Hoehlenbaer/SLARC/README.md

# SLARC – Six‑Legged Autonomous Robot Crab

> *'Crab' is a misnomer — six legs and no claws hardly make it one, but SLARC will happily act crab‑enough whenever something needs grabbing.*

SLARC is a personal hobby project with an ambitious goal: build a **state-of-the-art hexapod robot that is fully AI-controlled** — from low-level motion to high-level mission planning — using entirely off-the-shelf hardware, a fully 3D-printable chassis, and custom-trained neural networks.

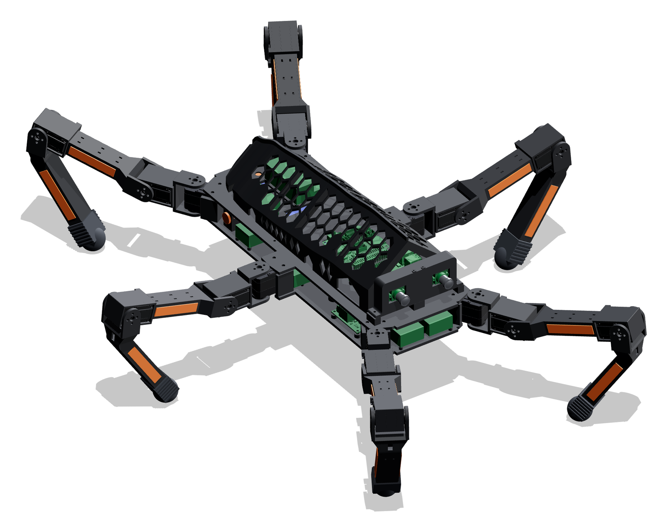
[picture p1: Documentation/Images/slarc_iso.png]
SLARC – full CAD model, isometric view


*Full CAD model, rendered straight from the parametric FreeCAD macros (Nov 2026).*

---

## What makes SLARC interesting

Most hobbyist hexapods are scripted or rely on simple remote control. SLARC aims to close the gap between hobby robotics and current research:

- **Fused multi-task perception** – a single shared neural network simultaneously performs stereo depth estimation, surface normal prediction, semantic segmentation, and object detection, all optimized for the Hailo-8 NPU
- **GPU-accelerated stereo rectification** – lens distortion correction and image scaling for both cameras runs entirely on the Raspberry Pi 5's VideoCore VII GPU via OpenGL ES shaders, freeing the CPU completely for other tasks
- **Needs-driven behaviour instead of voice remote control** – SLARC acts on its own needs (energy, curiosity, usefulness, company, safety); a deterministic arbiter picks the behaviour, and a small local vision-language model (Qwen3.5-4B on the Pi 5's CPU) answers only the semantic questions: what did the human mean, what is that object, where might the keys be
- **Portable reactive locomotion** – stair climbing and terrain adaptation are developed in a PyBullet simulation under one hard rule: the controllers may only use what the real robot can measure (joint angles, foot µ-switches, IMU), so the same logic can move 1:1 onto the ESP32
- **Fully self-printable, fully parametric** – every structural part of the chassis and legs is generated by FreeCAD macros and printed in PETG, PLA and TPU; no proprietary frames or machined parts

---

## Hardware

| Component | Details |
|---|---|
| **Main Brain** | Raspberry Pi 5, 8 GB RAM |
| **AI Accelerator** | Hailo-8 NPU (26 TOPS) via AI HAT+ |
| **Secondary Brain** | Waveshare General Driver for Robots (ESP32) |
| **Legs** | 6 × 3-DOF, 18 × Waveshare ST3215 serial bus servos (2.94 Nm stall), each servo supported on both sides |
| **Leg geometry** | Coxa 60 mm · Femur 150 mm · Tibia 175 mm (knee axis to foot tip, bent 38.6° downwards, 140 mm foot segment) — same values in CAD and simulation |
| **Feet** | TPU 95A foot caps with integrated µ-switch for ground contact detection |
| **Stereo Cameras** | 2 × IMX296 global shutter (1440×1080), M12 2.8 mm lens, 65 mm baseline, hardware-triggered via PWM |
| **IMU** | QMI8658C + AK09918C on the driver board (balance control on the ESP32); ICM-20948 on the stereo mount for visual-inertial SLAM on the Pi (I²C, data-ready interrupt, time-stamped against the camera trigger) |
| **Power** | Zeee 3S LiPo 9000 mAh, 3S BMS, relay-switched Pi supply and one relay per leg (power sequencing by the ESP32); wiring plan and perfboard layouts in `Documentation/Wiring` |
| **Chassis** | Two 4 mm PETG baseplates with the coxa servos sandwiched between them, generated by FreeCAD macros |
| **Size / mass** | ~85 cm leg span, ~1 m long; 3.79 kg all-up according to the CAD model (battery, electronics and cables estimated, still to be weighed) |

The Raspberry Pi handles all AI inference and high-level planning. The ESP32 handles real-time servo control, sensor reading and safety, communicating with the Pi over UART (see [Low-Level Control](#low-level-control--esp32)).

---

## AI Architecture

### Perception – FusedHexapodModel V5.0

The core perception system is a **single multi-task neural network** with four output heads, designed to run entirely on the Hailo-8 NPU. All heads share a common MobileNetV2-1.4 backbone with asymmetric channel alignment — the feature extraction cost is paid once per frame.

#### Architecture Evolution

The model has gone through several iterations, each driven by deployment constraints on the Hailo-8 NPU:

| Change | V3.1 | V4.0 | V5.0 | Reason |
|---|---|---|---|---|
| Backbone | MobileNetV3-Large | MobileNetV2-1.4 | MobileNetV2-1.4 | SE blocks caused 6× slowdown on Hailo |
| Channel Alignment | None | None | **Stereo-focused (64/128/128/256)** | Wider stereo features via 1×1 projection, preserving ImageNet weights |
| Stereo Matching | CostVolume + GroupedConv | CostVolume + GroupedConv | **Flat CostVolume + MLP reduction** | Cross-disparity learning, no per-bin isolation |
| CostVolume channels | 32 | 16 | 16 | Halved without quality loss |
| Stereo output | Full res (480×640) | s4 (120×160) | s4 (120×160) | s1 refinement added artifacts |
| Attention | CBAM after FPN | Removed | Removed | AvgPool + FC chains are NPU-hostile |
| Activations | ReLU + HardSwish | ReLU6 | ReLU6 | Pure INT8 quantization |
| Seg classes | 6 (with NAV_ANCHOR) | 6 (with NAV_ANCHOR) | **6 (FLOOR/TERRAIN split)** | Better outdoor navigation |
| Detection classes | 40 | 40 | **41 (+ UNKNOWN)** | Catch-all for the other 40 COCO classes |
| Confidence Gate | None | Peak confidence | Peak confidence | Suppresses false stereo matches |
| NPU deployment | Not achieved | 3-HEF, 18 FPS | **3-HEF (1+3+1 ctx), 16.5 FPS** | Wider features trade speed for quality |

#### Architecture Overview

```
Stereo Camera Pair (640×480, grayscale)
    │
    ▼
┌──────────────────────────────────────────────────────────────┐
│  MobileNetV2-1.4 Backbone (1-channel input, luminance merge) │
│  out_indices: s4 (32ch) · s8 (48ch) · s16 (136ch) · s32 (448ch)│
└──┬──────────┬──────────┬──────────┬──────────────────────────┘
   │          │          │          │
   ▼          ▼          ▼          ▼
┌──────────────────────────────────────────────────────────────┐
│  Channel Aligner (stereo-focused)                            │
│  1×1 Conv projections: 32→64 · 48→128 · 136→128 · 448→256   │
│  Wider s4/s8 for stereo, slimmer s32 saves compute           │
└──┬──────────┬──────────┬──────────┬──────────────────────────┘
   │s4(64)    │s8(128)   │s16(128)  │s32(256)
   │          │          │          ▼
   │          │          │    ┌───────────┐
   │          │          │    │   SPPF    │ Spatial Pyramid Pooling
   │          │          │    │  (k=5)    │ Expands receptive field
   │          │          │    └─────┬─────┘
   │          │          │          │
   │          │          ▼          ▼
   │          │    ┌─────────────────────┐
   │          │    │   Light FPN Neck    │ Bi-directional feature fusion
   │          │    │  (64ch, RepConv)    │ 4× RepConv (folded at deploy)
   │          │    └──┬───────┬───────┬──┘
   │          │       │s8     │s16    │s32
   │          │       ▼       ▼       ▼
   │          │    ┌────────────────────────┐
   │          │    │    YOLO Detection      │ 41 classes (40 known + UNKNOWN)
   │          │    │  (3 Decoupled Heads)   │ 3 scales: s8 / s16 / s32
   │          │    │  CoordConv + RepConv   │
   │          │    └────────────────────────┘
   │          │
   ▼          ▼
┌──────────────────┐
│  Geometry Stem   │ RepConv(64→32) + RepConv(32→32)
│  (s4, 32ch out)  │ High-res edge features
└──┬───────────────┘
   │ geo_features
   │
   ├───────────────────────────────────┐
   │                                   │
   ▼                                   ▼
┌──────────────────────┐    ┌─────────────────────────────────┐
│   NormalsHead        │    │   Correlation Stereo Head (V5)  │
│                      │    │                                 │
│  Fusion: s4 + s8     │    │  Flat CostVolume (s8)           │
│   + geo (CoordConv)  │    │   · Shift+Concat all disparities│
│   96 → 64 → 32 → 3  │    │   · 16ch × 24 bins = 384ch     │
│                      │    │                                 │
│  L2 normalize        │    │  MLP Reduction (384 → 96 → 24) │
│  (deploy-safe sqrt)  │    │   · Cross-disparity learning    │
│                      │    │   · Learns correlations across  │
│  Output:             │    │     all disparity bins jointly  │
│   normals_s4         │    │                                 │
│   [1, 3, 120, 160]   │    │  Confidence Gate (eval only)    │
│                      │    │                                 │
└──────┬───────────────┘    │  Refine s4 (backbone guidance)  │
       │ normals_s4         │                                 │
       ▼                    │  Output:                        │
┌────────────────────────┐  │   disp_s4  [1, 1, 120, 160]    │
│  LRASPP Seg Head       │  │   disp_s8  [1, 1,  60,  80]    │
│  low (s4 + normals)    │  └─────────────────────────────────┘
│  + high (s16, pooled   │
│    via LearnablePool)  │
│  + mid (dilated + norm)│
│                        │
│  Output:               │
│   seg [1, 6, 120, 160] │
│                        │
│  6 classes:            │
│  FLOOR · STEP ·        │
│  WALL · OBSTACLE ·     │
│  VOID · TERRAIN        │
└────────────────────────┘
```

#### Model Summary

| Property | Value |
|---|---|
| Total parameters | 5.90 M |
| Backbone (MobileNetV2-1.4) | 3.45 M |
| Channel Aligner | 0.14 M |
| YOLO Head | 1.46 M |
| Seg Head | 0.21 M |
| Normals Head | 0.16 M |
| Input | 1 × 480 × 640 grayscale (×2 for stereo) |
| Outputs | 7 tensors (disp_s4, seg, disp_s8, normals_s4, yolo_s8/s16/s32) |

#### Building Blocks

| Block | Purpose | NPU Cost |
|---|---|---|
| **MobileNetV2-1.4** | Shared backbone — wider channels (32/48/136/448) than MNV2-1.0, no SE blocks, pure ReLU6 | Very low — ideal for INT8 NPU |
| **Channel Aligner** | 1×1 Conv projections to Hailo-optimal widths (64/128/128/256); preserves ImageNet weights, wider s4/s8 for stereo, slimmer s32 saves compute | Negligible — four 1×1 convs |
| **SPPF** | Expands receptive field at s32 via cascaded 5×5 max-pooling | Minimal — pooling + 1×1 convs |
| **CoordConv** | Appends normalized X/Y coordinate grids; spatial awareness for stereo matching and normals | Negligible — 2 extra input channels |
| **RepConv** | Three parallel paths during training (3×3 + 1×1 + identity); folds into single 3×3 conv at deploy | **Zero overhead at inference** |
| **GeometryStem** | High-frequency edge features from s4 via 2× RepConv; shared by Stereo and Normals | Low — 2 convs at stride 4 |
| **Flat CostVolume** | Shift + Concat all disparity bins into a single flat tensor (384ch); no per-bin GroupedConv | More regular memory access pattern |
| **MLP Reduction** | Two-stage 1×1 Conv (384→96→24) with ReLU6; enables cross-disparity learning — each output bin sees all 24 shifts simultaneously | Low — two small 1×1 convs |
| **DWSepConv** | Depthwise-separable convolution; ~8–9× fewer FLOPs than standard conv | Very efficient |
| **LearnablePool** | Replaces AvgPool2d with depthwise conv initialized as averaging; avoids Hailo quantization shift errors | Identical compute, better quantization |
| **Confidence Gate** | At inference: suppresses stereo matches where peak confidence is too low (repetitive textures, sky) | Negligible — max + clamp + mul |
| **SegFormer teacher fusion** | SegFormer-b2 on GPU during training only; enriches geometry-derived seg labels with semantics | **Zero at inference** |
| **EMA loss balancing** | Per-task loss normalization with priority weights and NaN guards | **Zero at inference** |

#### Head Details

**Stereo Depth** — Flat CostVolume with cross-disparity learning at stride 4 resolution:
- Flat CostVolume at stride 8: shift + concatenate left/right features for all 24 disparity bins into a single 384-channel tensor
- MLP Reduction (384→96→24): two-stage 1×1 Conv with ReLU6 — enables each output bin to see all 24 shifts simultaneously, learning cross-disparity correlations instead of isolated per-bin matching
- Post-correlation refinement: 2× Conv2d 3×3 with spatial context smoothing
- Confidence Gate: peak confidence check — suppresses false matches on repetitive textures and sky regions
- Refine s4: Upscale ×2, backbone + geo + normals guidance via CoordConv
- Output: dense disparity map at s4 (120×160); for display, multiply by 4 and upscale with OpenCV

**Surface Normals** — Multi-scale fusion at stride 4:
- s4 backbone (64ch) + adapted s8 (32ch) + GeometryStem (32ch) = 128ch fused via CoordConv
- L2 normalization (deploy-safe: max-scaling to prevent INT8 overflow, then sqrt + clamp)
- Output: per-pixel unit normal vectors at s4 resolution (120×160)

**Segmentation** — LRASPP with normals injection:
- Low path: s4 features + predicted normals
- High path: s16 features via LearnablePool + 1×1 projection
- Mid path: dilated conv on s16 + normals
- Labels fused from depth-derived geometry (floor angle, surface roughness) + SegFormer-b2 teacher predictions (semantic classes)
- 6 classes: FLOOR (smooth hard surfaces), STEP (stairs), WALL (vertical), OBSTACLE (impassable), VOID (sky/far), TERRAIN (walkable but uneven: grass, sand, dirt)

**Object Detection** — YOLO-style 3-scale:
- 3-scale decoupled heads (s8, s16, s32) with CoordConv + RepConv
- 41 classes: 40 robot-relevant COCO classes (10 of them outdoor, e.g. bench, hydrant, traffic light as outdoor landmarks) + UNKNOWN
- UNKNOWN is trained on the remaining 40 COCO categories. Objects that COCO never labels (socks, cables, keys) were background during training, so true class-agnostic objectness should not be expected — this is still to be measured (LVIS annotations on COCO val)
- Not yet covered: doors, windows and drink cans. They are needed for navigation by named landmarks and for the can-fetching milestone and will be added by refining the detection head
- GIoU box regression, focal loss for classification

#### Training

| Aspect | Detail |
|---|---|
| Backbone init | MobileNetV2-1.4 pretrained on ImageNet, first conv patched 3→1 channel via luminance weight merging |
| Stereo + Seg + Normals data | TartanAir synthetic dataset (photorealistic indoor/outdoor stereo pairs with dense depth GT) |
| Detection data | COCO train2017 with offline YOLOv5 pseudo-label completion |
| Seg label fusion | Geometry (depth + normals thresholds) merged with SegFormer-b2 teacher on color images |
| Loss balancing | EMA-normalized multi-task loss with per-task priority weights and clamped effective weights [0.5, 10.0] |
| Optimizer | AdamW, per-module LR multipliers, Flat-Cosine LR schedule (warmup → hold → cosine decay) |
| Precision | Mixed FP16 via GradScaler, FP16-safe normalize (eps=1e-4), L1-norm edge maps (no sqrt) |
| Stability | NaN guards on EMA + total loss, per-module + global gradient clipping, forced `.item()` on all log values to prevent memory leaks in long training runs |
| Hardware | NVIDIA RTX 3080 Ti (12 GB), AMD Ryzen 9 5950X, WSL2 |

#### Eval Results

| Task | Metric | V3.1 | V4.0 | V5.0 | V4→V5 |
|---|---|---|---|---|---|
| **Stereo** | EPE | 2.42 px | 1.00 px | **0.97 px** | −3% |
| **Stereo** | Bad3 | — | 17.1% | **14.1%** | −18% |
| **Detection** | mAP@50 | 0.118 | 0.260 | **0.253** | −3% (41 cls) |
| **Detection** | Top10 Conf | — | 0.593 | **0.689** | +16% |
| **Segmentation** | mIoU | 23.8% | 22.7% | **22.6%** | ≈ (new classes) |
| **Normals** | Cosine Sim | 0.567 | 0.639 | **0.638** | ≈ |

**V5.0 highlights:**
- Stereo Bad3 drops from 17.1% to 14.1% — the MLP reduction and cross-disparity learning significantly improve matching quality
- YOLO confidence jumps 16%, mainly thanks to the wider backbone features
- YOLO mAP@50 is slightly lower (0.253 vs 0.260) because V5.0 has 41 classes instead of 40 — the additional UNKNOWN class makes classification marginally harder
- Seg mIoU is comparable despite a complete class redefinition (WALKABLE→FLOOR, NAV_ANCHOR removed, TERRAIN added)
- VOID detection works for the first time (53.7% IoU vs 0.0% in V4.0)

*All metrics evaluated on TartanAir eval (amusement, oldtown) and COCO val2017. Stereo EPE measured at s4 resolution (120×160).*

### Hailo-8 NPU Deployment

The model is split into **3 HEF files** for deployment on the Hailo-8 NPU. Alternative splits were evaluated (2-HEF combined, 3-HEF with Normals+Detection merged) but failed due to INT8 concat zero-point mismatches or excessive inter-context bandwidth. The 3-HEF split remains the most reliable and performant approach.

#### 3-HEF Pipeline

```
img_left ──→ [HEF A: Backbone] ──→ f_s4, f_s8, f_s16, f_s32
img_right ─→ [HEF A: Backbone] ──→ f_s4_r, f_s8_r
                                         │
              features_l + features_r ───→ [HEF B: Geometry] ──→ disp_s4, normals_s4, disp_s8
                                         │
              features_l + normals_s4 ──→ [HEF C: Detection] ──→ seg, yolo_s8, yolo_s16, yolo_s32
```

#### Compilation Results

| HEF | Contexts | Weights | GOPS | Inter-Context BW | SNR (dB) |
|---|---|---|---|---|---|
| **A: Backbone** | 1 | 3.0 M | 2.57 | 0 MB | 14–18 |
| **B: Geometry** | 3 | 0.3 M | ~12 | 73.9 MB | 28–39 |
| **C: Detection** | 1 | 3.9 M | ~8 | 0 MB | 40–44 |
| **Total** | **5** | **7.2 M** | **~23** | — | — |

#### Cluster Utilization

**Backbone** (single context):

| Cluster | Control | Compute | Memory |
|---|---|---|---|
| Total | 74.2% | 47.7% | 34.4% |

**Geometry** (3 contexts, highest utilization context shown):

| Cluster | Control | Compute | Memory |
|---|---|---|---|
| Total (ctx 1) | 71.9% | 28.1% | 26.4% |

**Detection** (earlier 2-context build, context 0 shown; the final build fits into a single context):

| Cluster | Control | Compute | Memory |
|---|---|---|---|
| Total (ctx 0) | 60.2% | 33.6% | 43.4% |

#### Quantization Quality (SNR)

| Output | HEF | SNR (dB) | Quality |
|---|---|---|---|
| f_s4 (backbone) | A | 16.3 | Acceptable (intermediate feature) |
| f_s8 (backbone) | A | 16.0 | Acceptable (intermediate feature) |
| f_s16 (backbone) | A | 14.2 | Acceptable (intermediate feature) |
| f_s32 (backbone) | A | 15.2 | Acceptable (intermediate feature) |
| disp_s4 (stereo) | B | **39.1** | Excellent |
| normals_s4 | B | **33.1** | Very good |
| disp_s8 (coarse) | B | **27.8** | Good |
| seg | C | **44.5** | Excellent |
| yolo_s8 | C | **41.8** | Excellent |
| yolo_s16 | C | **43.6** | Excellent |
| yolo_s32 | C | **39.7** | Excellent |

*Backbone SNR is lower because intermediate features have wider value distributions. The downstream heads compensate effectively — all final output SNRs exceed 27 dB.*

#### Runtime Performance (Raspberry Pi 5, PCIe Gen 3)

| Step | V4.0 Latency | V5.0 Latency (median) |
|---|---|---|
| Backbone (left) | 13.5 ms | 14.1 ms |
| Backbone (right) | 10.0 ms | 10.0 ms |
| Geometry (stereo + normals) | 21.8 ms | 25.9 ms |
| Detection (seg + YOLO) | 10.6 ms | 10.4 ms |
| **Pipeline total** | **56 ms → 17.9 FPS** | **60.5 ms → 16.5 FPS** |

*V5.0 final HEFs (1+3+1 contexts), pure inference time from raw image to head outputs, no I/O or post-processing; min/max 59.9 / 62.5 ms. V5.0 uses stereo-focused channel alignment (64/128/128/256) which produces wider feature tensors, slightly increasing transfer overhead. Measured on Raspberry Pi 5 with PCIe Gen 3 (`dtparam=pciex1_gen=3`).*

#### Quantization check FP32 → INT8 (TartanAir oldtown sample)

| | EPE | Max disparity |
|---|---|---|
| FP32 (PyTorch) | 1.134 px | 20.12 px |
| INT8 (Hailo-8) | 1.121 px | 20.47 px |

Mean FP32 → INT8 difference: 0.20 px — INT8 quantization costs no measurable stereo accuracy. Normals, segmentation and detection also match the FP32 outputs visually.

**Known limitation – sky:** the largest remaining stereo error is in sky regions (the network outputs disparity where the ground truth is ~0). This is a training-data artifact, not an architecture problem; fixing it needs fine-tuning on real images from SLARC's own cameras.

#### Lessons Learned: Hailo-8 Optimization

The path from a trained PyTorch model to a working HEF on the Hailo-8 was the most challenging part of this project. Key takeaways:

1. **Squeeze-and-Excite blocks are NPU killers.** MobileNetV3-Large with SE blocks: 35 ms per backbone pass. Without SE: 5.6 ms — a 6.3× speedup. The avgpool→fc→fc→sigmoid→multiply chain creates excessive context switches.

2. **HardSwish costs more than expected.** Even without SE, MobileNetV3 (16 FPS) was slower than MobileNetV2 (18.5 FPS) because HardSwish compiles as a multi-op sequence requiring 16-bit precision.

3. **AvgPool2d causes quantization failures.** Global average pooling with large kernel sizes (30×40, 60×80) triggers shift-delta errors in the Hailo quantizer. Solution: replace with depthwise conv initialized as averaging (`LearnablePool`), or use `pre_quantization_optimization(global_avgpool_reduction)`.

4. **The DFC renames all ONNX inputs.** Start nodes become `input_layer1`, `input_layer2`, etc., regardless of the ONNX names. Input mapping must use positional order, not name matching.

5. **Model script normalization requires assignment syntax.** `norm_0 = normalization([mean], [std], input_layer1)` — bare `normalization()` calls fail silently.

6. **Single-HEF is not always faster.** A single HEF with many contexts can have higher inter-context bandwidth than multiple smaller HEFs. Always benchmark both approaches.

7. **Calibration data must be unnormalized.** When using in-network normalization via model script, calibration data should be raw \[0, 255\] values, not pre-normalized.

8. **RepConv deploy flag must be threaded through all constructors.** If any `RepConv` module doesn't receive `deploy=True`, the folded weights won't load. Use a post-creation fix: iterate all modules and set `deploy=True` + create `rbr_reparam` manually.

9. **Classification backbones waste channels for dense prediction.** MobileNetV2-1.4 puts 448 channels at s32 (for ImageNet classification) but only 48 at s8 (where stereo matching happens). A simple 1×1 projection ("Channel Aligner") redistributes capacity: wider s4/s8 for stereo, slimmer s32 for detection. ImageNet weights are preserved — only the projection layers are new.

10. **Grouped Convolutions in Cost Volumes limit stereo quality.** V4.0's GroupedConv processed each disparity bin in isolation — bin 5 had no information about bins 4 or 6. Replacing this with a flat Concat + MLP reduction (384→96→24) lets each output bin see all 24 shifts simultaneously, enabling cross-disparity learning. This changed the learning dynamics fundamentally: the model learns global depth structure instead of local bin-by-bin matching.

11. **Concat zero-point mismatches block HEF merging.** Combining Normals (range [-1, 1]) and Backbone features (range [-3, 3]) in a single HEF causes INT8 quantization conflicts at Concat nodes. Keeping them in separate HEFs lets the compiler resolve zero-points at HEF boundaries. A 2-HEF approach (Backbone + Combined) failed for this reason; 3-HEF remains the most reliable split.

### High-Level Brain – needs-driven behaviour (`src_dev/ai/brain/`, V0.9)

SLARC should not be a voice-controlled remote. A command like *"walk north until the battery is empty"* is just remote control with extra steps. Instead, SLARC acts on its own needs — **energy, curiosity, usefulness, company** — plus a sense of **safety**. People can still ask for things; the brain files a request under these needs. The goal is behaviour that feels alive rather than scripted.

The design follows behaviour-based robotics (three-layer architecture):

| Layer | Where | Rate | Job |
|---|---|---|---|
| Reflexes & expression | ESP32 | 100 Hz | Balance, foot contacts, detecting being lifted or tapped, idle motion, "thinking" pose |
| Behaviour | Pi, behaviour trees (`py_trees`) | 10 Hz | Runs one behaviour from a fixed catalogue: explore, look around, inspect, search, report, greet, follow, return home, rest, retreat … |
| Needs & memory | Pi | 1 Hz | Updates the needs, applies the safety veto, picks the behaviour, keeps memory of objects and places and a diary |
| LLM | Pi, llama.cpp | Event-driven | Semantic questions only |

**Key decisions**

- **Action selection lives in code, not in the LLM.** In the first test, Qwen3-4B as decision maker scored 36/45 against 42/45 for the plain code arbiter, and it chose a human request over returning home in all three "battery low, far from home" cases. Safety limits and the energy-based return home are therefore hard rules with a veto.
- **The LLM does what only it can:** interpret chat messages, judge unknown objects, guess where to search for something, narrate the diary, and break near-ties between equally good options. Outputs are forced into a fixed format with llama.cpp GBNF grammars.
- **"What is that?"** Unknown detections are never touched. SLARC crops the box with a red frame, asks the vision-language model from two viewpoints and only accepts a name if both answers agree; otherwise it asks a human in the chat. On PC tests about 3 of 4 household objects were named correctly.
- **Blackboard as the only interface** (`blackboard.py`, BB 0.2): pose, 10 cm occupancy grid, detections in world coordinates, object tracks (present / missing / moved), persons, frontiers and navigation state. Path planning with A* (`nav/`, numpy only). The brain stays unchanged when simulation is replaced by real perception and SLAM.

**LLM on the Raspberry Pi 5 (8 GB, CPU only)**

| Setting | Value |
|---|---|
| Model | Qwen3.5-4B Q4_K_M + vision projector (mmproj) Q8_0 |
| Runtime | One `llama-server`, built without BLAS (no measurable gain), 4 slots — one per task, so switching tasks costs nothing |
| Server options | `-np 4 -c 8192 -fa on -ctk q8_0 -ctv q8_0 -ub 256 --cache-ram 0` |
| Memory | ~4.2 GB |
| Pause per call (measured) | Chat ~9–10 s · search places ~12–15 s · object judgement ~14 s · goal choice ~19 s · image question at 320 px ~10 s |

While the LLM computes, SLARC enters a **thinking state**: perception and motion on the Pi pause so the model gets all cores, while the ESP32 keeps the reflexes running and shows a thinking pose. As far as I know there is still no practical way to run an SLM of this size on the Hailo-8 — happy to hear otherwise.

**Testing without hardware:** unit tests (`brain/tests`), decision and open-ended test suites with held-out sentences, a model comparison tool, a text-level day simulation (`brain/sim`) and a 2D simulation (`brain/sim2d`) with a simulated camera, map building, object tracking and an HTML replay viewer. In the first 2D run SLARC mapped all seven rooms of a simulated flat in under an hour, tracked 20 objects and was back home before the battery ran low.

**Interaction** works without audio for now: web chat, phone notifications, body language, LEDs and tapping the shell as praise. Audio will come via USB, because I²S on the Pi collides with the camera trigger on GPIO18.

Full concept, measurements and decisions: `Documentation/Brain_Konzept.md` (German).

*The earlier prototypes (`exploration_manager_V4.py`, `bt_executor.py`, `mission_replanner_V1.py`) turned a command into a JSON behaviour tree. They are superseded by the brain but remain in `src_dev/ai/` as reference.*

---

## Camera Pipeline & GPU-Accelerated Rectification

> **This may be of independent interest as a standalone technique.**

Stereo vision requires both camera images to be rectified before depth estimation — distortion must be removed and the images aligned so that corresponding points sit on the same horizontal scanline. On a Raspberry Pi, doing this in software (OpenCV `remap`) consumes a significant portion of the CPU budget at high resolution.

SLARC offloads the entire rectification and rescaling pipeline to the **VideoCore VII GPU** using OpenGL ES 3.0 fragment shaders via `moderngl`. The approach:

```
picamera2 (1440×1080, YUV420)
    │  Y-plane only → Shared Memory
    ▼
OpenGL ES Fragment Shader (VideoCore VII)
    │  Inverse camera model per output pixel:
    │   1. Map output pixel → ray (K_new⁻¹)
    │   2. Rotate ray into camera frame (R⁻¹)
    │   3. Apply radial + tangential distortion (k1, k2, p1, p2)
    │   4. Project back to source pixel (K_old)
    │   5. Bilinear texture sample
    ▼
Rectified + scaled output (640×480, RGB)
    │  → Shared Memory → Hailo-8 inference
    ▼
POSIX Semaphore signals AI process
```

**Why this matters on a Raspberry Pi:**
- The VideoCore VII has its own memory bus and shader cores that are otherwise completely idle during inference workloads
- CPU load for rectification at 50 fps drops from ~40% (OpenCV) to ~0% (GPU shader)
- Both cameras are processed sequentially in a single OpenGL framebuffer pass
- The pipeline handles arbitrary stereo calibration matrices loaded from a JSON file, or falls back to identity matrices for testing

The implementation lives in `vision/vision_processor.py` and `vision/vision_capture.py`. Synchronization between the two camera capture processes and the GPU worker uses a `multiprocessing.Barrier` and POSIX semaphores, keeping latency deterministic.

If you are working on stereo vision on Raspberry Pi and looking for a way to free up CPU time, this approach should transfer directly to any project using `picamera2` + `moderngl`.

Both IMX296 sensors are triggered externally by a PWM signal so that left and right exposures start at the same instant (setup notes: `Documentation/Setup HW trigger.txt`). With fx ≈ 357 px at 640×480 and 192 px maximum disparity, the 65 mm baseline gives a minimum measurable distance of ≈ 1.86 × baseline ≈ 12 cm — close enough to see the robot's own feet.

---

## Locomotion & Simulation

Gait and climbing control are developed in **PyBullet** (`utilities/Motion_development/slarc_sim/`) before they touch real servos. The simulation model uses the planned leg geometry, servo limits (2.94 Nm stall, soft position gain to mimic gear backlash and the TPU foot) and realistic friction/contact parameters.

**Design rule:** every controller may only use signals the real robot has — joint angles, foot µ-switch contacts and IMU roll/pitch. No world coordinates from the physics engine. That keeps the control logic portable to the ESP32.

### Controller layers

| Layer | Input | Function |
|---|---|---|
| **R1 – foot seek** | µ-switch per leg | Lowers a leg until it touches ground; no contact → keep searching |
| **R2 – balancer** | IMU pitch / roll | Holds the body attitude; while climbing the setpoint follows the slope of the support plane instead of 0° |
| **R3 – body height** | Median of stance-leg forward kinematics | Keeps body height robust against single legs standing on bumps (median, not mean) |

In an isolated hold test the three regulators kept all six feet in contact through all disturbance scenarios. During walking they run per gait.

### Gaits

| Gait | Legs in stance | Use |
|---|---|---|
| **Tripod** | 3 | Fast walking on flat ground |
| **Ripple** | 4 | Uneven terrain, more stability margin |
| **Placemove** | 5 | One leg at a time, probing foothold – stairs and unknown terrain |

A **centaur mode** (walking on the middle and rear pairs, front legs used as grippers) is planned.

### Stair climbing

The current development line is **V10.17** (`slarc_sim_V10.py`): leg geometry, masses and inertias come from the CAD model (`urdf/slarc_cad.urdf`, 3.79 kg), the IK handles the bent tibia and the lowered femur axis, and joint limits are the real mechanical ones (coxa ±90°, femur/tibia ±112°) — a target outside them is pulled back along the line to the neutral foot position instead of clipping single joints. Climbing a real 17 cm step was shown to be kinematically feasible for the earlier 175/150 mm legs (to be rechecked for 150/175 with the bent tibia). With the current CAD geometry V10.17 gets stuck at the step edge, so the climbing constants have to be re-optimised. Longer term, constant tuning alone will not be enough: the target architecture is a planned foothold layer on the Pi on top of the stable analytical regulators on the ESP32. Key findings so far:

- Body length matters: with the coxa joints 400 mm apart, one leg pair lands per step on a 250 mm tread instead of several pairs crowding one step
- Height regulation while climbing uses a dedicated small gain — this brought body bounce down from ~5 cm to ~1 cm
- A fore-aft centre-of-mass shift unloads whichever leg group is about to swing
- Rear leg targets are biased forward during climbing so the rear legs swing via the coxa instead of folding the tibia against the riser
- Manual teleop found a reliable climbing pattern: alternating tripods with a deliberate sideways body roll that unloads each tripod before it swings, contact-gated so a leg only moves once its µ-switch reports no ground contact

### Self-righting

The gabled back shell is shaped so that SLARC cannot rest stably on its back. In simulation (Nov 2026, manual teleop in joint mode, `slarc_manual.py --start-back`) SLARC rolled from its back onto its belly for the first time: the right-side coxas go to their stops, femur and tibia push, and the body rolls over the middle right leg. An automatic self-righting routine is still to be written.

### Tools

| File | Purpose |
|---|---|
| `slarc_sim_V10.py` | Main simulation: gaits, regulators, stair and hill courses, CSV logging with a version tag in every log |
| `slarc_harness.py` | Headless regression harness (PyBullet DIRECT), PASS/FAIL per scenario, exit code for CI |
| `slarc_cma_climb.py` | CMA-ES optimizer for the climbing constants over three step heights (8, 12, 17 cm); best result in `slarc_cma_best.txt` |
| `slarc_manual.py` | Manual teleoperation (foot or joint mode) with recording and replay (JSONL keyframes), load and torque table for all 18 servos (% of stall), optional start on the back |
| `slarc_leg_tuner.py` | Slider-based joint tuner, saves poses to `leg_positions.json` |
| `test_hold.py`, `test_layers.py` | Isolated tests for hold mode and controller layers |

---

## Low-Level Control – ESP32

The **Waveshare General Driver for Robots** (ESP32) is the real-time executor. It owns the servo bus, the foot switches and the IMU and is responsible for safety on its own — it never waits for the Pi to stop a movement.

**Current state – firmware V0.1** (`firmware/esp32/`, PlatformIO + Arduino): a commissioning tool with a USB serial command line. It has an ST3215 bus driver and commands for I²C scan, servo search over all baud rates, ID assignment, register dump, live joint angles, zero-offset calibration, slow moves within the software joint limits, foot contacts, battery voltage, the power button and the relays. Pins, servo IDs, joint directions and limits sit in `include/config.h`, taken from `Documentation/Hardware_Interfaces.md`. No control loop and no Pi protocol yet.

**Planned architecture:**

- **Framework:** PlatformIO + Arduino-ESP32 (Core 3.x), two FreeRTOS tasks: communication on core 0, a fixed 100 Hz control loop on core 1 with one SyncWrite to all 18 servos per cycle
- **Hardware-independent core library** (`slarc_core`) with unit tests that run on the PC (`pio test -e native`)
- **Safety:** heartbeat from the Pi every 100 ms; > 300 ms without heartbeat during a movement → `SAFE_STOP` (servos hold position, latched until cleared)
- **Power sequencing:** a push button wakes the ESP32 from deep sleep; it switches the Pi supply via relay K1, the Pi holds K1 itself through a transistor so it can shut down cleanly, then the ESP32 powers the legs (one relay per leg) and enables torque. Shutdown runs in reverse: park the legs, torque off, shut down the Pi, deep sleep. Holding the button for 5 s cuts all relays at once

### Pi ↔ ESP32 protocol (v0.1)

Newline-delimited JSON over UART with a CRC-8 per message, body-frame coordinates (REP-103) and leg order FR, MR, HR, FL, ML, HL (H = hind).

| Class | Examples | Behaviour |
|---|---|---|
| **Streaming** | walk velocity `vx, vy, wz`, body pose | Continuous; latest value wins |
| **Action** | pose, park, grip | Discrete; acknowledged with `ack` / `done` / `err` |
| **Config** | limits, gains | Only while idle |

Telemetry at 20 Hz: state, measured and commanded joint angles, contact bits, roll/pitch, torque, loop timing. Odometry fields are planned so the Pi can execute distance- and angle-based moves.

---

## Mechanical Design (CAD)

All printed parts are generated by **parametric FreeCAD macros** (FreeCAD 0.21 / 1.0). Every dimension sits in a spreadsheet, so leg lengths, clearances or the stereo baseline can be changed and the model rebuilds. All macros live in `Drawings/Macros/`, together with the STEP models of the bought parts, which the macros load from their own folder and place into the assembly for collision checks.

| Macro | Content |
|---|---|
| `slarc_leg_freecad_v9.py` | Complete leg (V9.7): coxa, femur, tibia with three ST3215, double-bearing forks, servos fully enclosed and secured from below, bent tibia, TPU foot cap with µ-switch. Femur and tibia are hollow tubes that carry the switch cable inside. Details driven by the first test prints: servo pocket clearance from the STEP dimensions, teardrop screw holes, 45° peaked roofs instead of bridges in every cavity, cable-tie eyelets on the outside, a terminal chamber behind the µ-switch. All printable without supports. `MIRROR = True` builds the mirrored left leg |
| `slarc_foot_fit_test_v1.py` | Fit test for the sliding TPU foot cap: eight short rings with clearances from 0.3 to 1.0 mm on one print |
| `slarc_baseplates_v2.py` | Upper plate (Pi 5 + AI HAT+, General Driver, stereo mount, 5 V DC-DC for the Pi, module spots for the MCP23017 IO expander and an optional I²C mux) and lower plate (battery bay with a tool-free bayonet latch pin, holder for the battery connectors, BMS, relay), coxa servos between the plates, sweep cut-outs for the coxa range of motion, split for a 300 × 300 mm print bed |
| `slarc_stereo_mount_v1_4.py` | Stereo holder for 2 × IMX296 with M12 lens, 65 mm baseline, pocket for the trigger PCB, mount for the ICM-20948 on top (rigid to the camera pair), rounded corners (V1.5), M12 lens ZH3019-14 as check body (stand-in; the fitted lens is a Richer-R 2.8 mm, length still to be measured) |
| `slarc_cover_v1.py` | Back shell in beetle form: gabled lattice roof with a ridge crest (makes lying on the back unstable and helps self-righting), carried by 6 posts on the plate columns, two print parts without supports |
| `slarc_assembly_v1.py` | Full robot: both plates with electronics plus six legs (fast linked mode or six independent legs with individual joint angles) |

**Materials:** PETG (structure, black), PLA (decorative strips, orange), TPU 95A (feet). Printed on an Anycubic Kobra+ with Cura.

**Bill of materials:** `Drawings/Macros/SLARC_Stueckliste.xlsx` — bought parts with quantities and reserve, printed parts with volumes from the CAD model, print settings per part, and a weight estimate.

**Print projects:** `Drawings/Cura/make_cura_3mf.py` generates a ready-to-slice Cura project (`Drawings/STL files/AKP_<part>.3mf`) for every printed part: model in print orientation, material, infill, walls, supports and brim taken from the bill of materials, printer and profile from templates.

> Mirrored legs: in the left legs the femur and tibia servos are mounted rotated by 180°, so their direction of rotation must be inverted in software.

---

## Software Stack

### Virtual Environments

All Python components run in isolated venvs under `~/projects/slarc/venvs/`:

| Venv | Purpose | Key packages |
|---|---|---|
| `slarc_base` | Shared IPC / messaging | `posix_ipc` |
| `vision` | Camera, OpenCV, rendering | `picamera2`, `opencv-python`, `moderngl`, `pyzmq` |
| `ai` | LLM + perception inference | `llama-cpp-python`, `onnxruntime`, `ollama`, `hailort` |
| `sensors` | IMU, I²C sensors | `smbus2`, `icm20948`, `scipy` |
| `motion_control` | Servo / GPIO control | `RPi.GPIO`, `scipy` |
| `slam` | Mapping and localization | `opencv-python`, `matplotlib` |

`vision` and `ai` use `--system-site-packages` to access `hailort` and `picamera2`, which are installed system-wide by the Hailo stack.

### Shell Shortcuts

`setup_venvs.sh` automatically adds convenience aliases to `~/.bashrc`:

```bash
venv-ai       # source .../venvs/ai/bin/activate
venv-vision   # source .../venvs/vision/bin/activate
venv-sensors  # source .../venvs/sensors/bin/activate
venv-motion   # source .../venvs/motion_control/bin/activate
venv-slam     # source .../venvs/slam/bin/activate
venv-base     # source .../venvs/slarc_base/bin/activate
venv-off      # deactivate
```

Active after the next login, or immediately with `source ~/.bashrc`.

---

## Raspberry Pi 5 Configuration

### Boot without button press

To allow the Pi to boot automatically when power is applied (e.g. when the Waveshare driver board enables the relay), add to `/boot/firmware/config.txt`:

```
POWER_OFF_ON_HALT=0
```

Without this setting, the Pi enters a low-power halt state on shutdown and requires a physical button press to boot again.

### PCIe Gen 3

For optimal Hailo-8 transfer speeds, enable PCIe Gen 3:

```
dtparam=pciex1_gen=3
```

This is already configured automatically by the AI HAT+. If using an M.2 AI Kit, enable it manually via `raspi-config → Advanced Options → PCIe Speed → Yes` or by adding the line above to `/boot/firmware/config.txt`.

---

## Requirements

| Component | Requirement |
|---|---|
| Hardware | Raspberry Pi 5 |
| AI Accelerator | Hailo-8 (AI HAT+ or AI Kit) |
| Operating System | Raspberry Pi OS **Trixie** – 64-bit |
| Kernel | ≥ 6.6.31 |

> **Note:** Raspberry Pi OS Bookworm is **not** supported for the current Hailo software stack (`hailo-all` ≥ 4.20). Flash a fresh Trixie image using [Raspberry Pi Imager](https://www.raspberrypi.com/software/).

---

## Quick Start

Clone this repository and run the setup script:
```bash
# git is required to clone – on a fresh Trixie image it may be missing:
sudo apt install -y git

git clone https://github.com/Hoehlenbaer/SLARC.git ~/projects/slarc
cd ~/projects/slarc/utilities
sudo bash setup_venvs.sh
```

That's it. The script handles everything in the correct order:

1. **System packages** – installs `build-essential`, `cmake`, `ninja-build`, `libopenblas-dev`, `python3-venv` and others if missing
2. **Hailo stack** – installs `hailo-all` via apt if not already present, builds the DKMS kernel module, configures autoload, and installs a post-upgrade hook so the driver survives future kernel updates automatically
3. **Virtual environments** – creates all project venvs
4. **Python packages** – installs all pip dependencies per venv, including a custom OpenBLAS-accelerated build of `llama-cpp-python`
5. **Shell shortcuts** – adds `venv-ai`, `venv-vision`, `venv-off` etc. to `~/.bashrc`
6. **LLM model** – downloads `Qwen3-4B-Instruct-2507-Q4_K_M.gguf` (~2.3 GB) to `~/.models/` if not already present; download is resumable with Ctrl+C

The script is **fully idempotent** – re-running it on an already configured system skips everything that is already in place.

> **Note:** the setup script still installs the earlier LLM setup (Qwen3-4B, `llama-cpp-python` with OpenBLAS). The high-level brain now uses Qwen3.5-4B with a vision projector in a `llama-server` built without BLAS (see [High-Level Brain](#high-level-brain--needs-driven-behaviour-src_devaibrain-v09)); the script has not been updated for that yet.

> **After a fresh Hailo installation:** A reboot is required before the Hailo device becomes available. The script will remind you.

---

## llama-cpp-python

Built from source with OpenBLAS acceleration. The repository is cloned to `~/llama-cpp-python` and is handled automatically by `setup_venvs.sh`. To rebuild manually:

```bash
cd ~/llama-cpp-python
source ~/projects/slarc/venvs/ai/bin/activate
CMAKE_ARGS="-DGGML_BLAS=ON -DGGML_BLAS_VENDOR=OpenBLAS" pip install . --no-cache-dir
deactivate
```

---

## Hailo NPU

### Verify the device

```bash
hailortcli fw-control identify
```

### Kernel updates

After a kernel update (`apt upgrade`), the Hailo PCIe driver is automatically rebuilt by a DKMS hook that `setup_venvs.sh` installs at `/etc/kernel/postinst.d/dkms-hailo`. No manual action required. If you suspect the driver is missing after an update:

```bash
dkms status                  # should show current kernel as 'installed'
sudo modprobe hailo_pci      # load manually if needed
hailortcli fw-control identify
```

---

## Configuration Backup & Restore

To migrate settings from a Bookworm system to Trixie (PCIe speed, PWM overlays, I²C, systemd units, etc.):

```bash
# On the old Bookworm system
sudo bash utilities/rpi_config_backup.sh

# Copy the archive to the Trixie system, then:
sudo bash utilities/rpi_config_restore.sh rpi_backup_YYYYMMDD_HHMMSS.tar.gz
```

The restore script is interactive and selective – it never blindly overwrites system files. Every file gets a `.pre-restore.bak` before being changed.

---

## Repository Structure

```
SLARC/
├── src_stable/                 # Tested state, started by launch_all.py
│   ├── launch_all.py
│   ├── vision/                 # vision_main / vision_capture / vision_processor (GPU rectification)
│   ├── ai/                     # ai_main.py – perception + planning process
│   ├── motion_control/
│   ├── sensors/
│   └── slam/
├── src_dev/                    # Work in progress
│   ├── ai/                     # HEF pipeline, benchmarks, earlier LLM planner prototypes
│   │   ├── brain/              # High-level brain: needs, arbiter, behaviours, LLM tasks, blackboard,
│   │   │                       #   nav (A*), vision (VLM tools), sim + sim2d, tests, results
│   │   ├── hefs/               # Compiled HEFs
│   │   └── V5.x_*_deploy/      # Deploy notebooks + HEFs per model version
│   ├── motion_control/         # Pathfinder (costmap A*) prototypes
│   ├── sensors/                # ICM-20948 tests and calibration
│   └── vision/
├── firmware/
│   └── esp32/                  # ESP32 firmware (PlatformIO), currently V0.1 commissioning tool
├── utilities/
│   ├── setup_venvs.sh          # Main setup script (start here)
│   ├── rpi_config_backup.sh    # Backs up RPi config to a .tar.gz archive
│   ├── rpi_config_restore.sh   # Restores config from archive (Bookworm → Trixie)
│   └── Motion_development/
│       └── slarc_sim/          # PyBullet simulation, harness, CMA-ES optimizer, teleop, CAD-URDF
├── Documentation/              # Model training/deploy notebooks, Hailo notes, HW trigger setup
│   ├── Hardware_Interfaces.md  # Hardware interfaces for the firmware, Pi, simulation and AI work
│   ├── Stand_und_Entscheidungen.md  # Decisions with reasons, measurements, open points
│   ├── Brain_Konzept.md        # High-level brain concept and measurements
│   ├── SLARC Pi↔ESP32 Protokoll v0.1.pdf  # Protocol spec
│   ├── Images/                 # README images and render scripts
│   └── Wiring/                 # Wiring plan, current budget, perfboard layouts (SVG)
├── Drawings/
│   ├── Macros/                 # FreeCAD macros, STEP models used by them, bill of materials
│   ├── Cura/                   # Generator for Cura projects (source: bill of materials)
│   ├── STL files/              # Exported print files and Cura projects (AKP_*.3mf)
│   └── Step files/             # STEP models of bought parts (ST3215, Pi 5, driver, relay, IMX296)
├── Archive/                    # Older model generations and experiments
├── CLAUDE.md                   # Working notes for Claude Code (German)
└── README.md
```

---

## Project Status

| Component | Status |
|---|---|
| Chassis / legs – parametric CAD (FreeCAD) | ✅ Complete design, collision-checked; first test prints done, leg V9.2–V9.7 fixes from them |
| TPU foot cap fit | 🔧 Fit-test rings printed, clearance to be chosen |
| Bill of materials + Cura projects | ✅ Print settings per part, Cura projects generated from the BOM |
| Wiring plan + perfboard layouts | ✅ Plan in `Documentation/Wiring`, not yet built |
| Hardware build | 🔧 Starting with a single leg and servo dummies |
| Simulation – walking (tripod / ripple / placemove) | ✅ Working, R1–R3 regulators integrated |
| Simulation – stair climbing (17 cm) | 🔧 V10.17 stalls at the step edge; climbing constants to be re-optimised |
| Simulation – self-righting from the back | 🔧 Works manually in teleop; automatic routine to do |
| ESP32 firmware | 🔧 V0.1 commissioning tool in the repo; control loop and protocol to do |
| Pi ↔ ESP32 protocol | 🔧 Spec v0.1 |
| Camera pipeline – GPU rectification | ✅ Working |
| FusedHexapodModel V5.0 – Training | ✅ Complete |
| FusedHexapodModel V5.0 – Hailo deployment | ✅ 3-HEF pipeline (1+3+1 contexts), 16.5 FPS |
| FusedHexapodModel – Stereo head | ✅ EPE 0.97 px, Bad3 14.1% |
| FusedHexapodModel – Surface normals | ✅ Cosine sim 0.638 |
| FusedHexapodModel – Segmentation | ✅ mIoU 22.6% (6 classes: FLOOR/STEP/WALL/OBSTACLE/VOID/TERRAIN) |
| FusedHexapodModel – Object detection | ✅ mAP@50 0.253 (41 classes incl. UNKNOWN) |
| FusedHexapodModel – new classes (door, window, can) | 📋 Planned (refinement of the detection head) |
| FusedHexapodModel – fine-tuning on SLARC camera images (sky artifact) | 📋 Planned, needs stereo calibration first |
| High-level brain (needs, behaviour trees, LLM for semantics) | 🔧 V0.9, running in 2D simulation; LLM setup measured on the Pi 5 |
| System setup scripts | ✅ Complete |
| Centaur mode (quadruped + front-leg gripping) | 📋 Planned |

**Goal for end of 2026:** SLARC climbs an office staircase and fetches a soda can.

---

## Troubleshooting

**Hailo stops working after `apt upgrade`**
A kernel update replaced the running kernel. The DKMS hook should handle this automatically, but if it didn't:
```bash
sudo dkms build hailo_pci/4.23.0 -k $(uname -r)
sudo dkms install hailo_pci/4.23.0 -k $(uname -r)
sudo modprobe hailo_pci
```

**Hailo not detected after install**
Reboot the Raspberry Pi. The kernel module needs to load after a fresh `hailo-all` installation.

**`hailortcli fw-control identify` fails**
- Check that the AI HAT+ is properly seated
- Verify PCIe is enabled in `/boot/firmware/config.txt`
- Check kernel version: `uname -r` (must be ≥ 6.6.31)

**llama-cpp-python build fails**
- Ensure `libopenblas-dev` is installed: `dpkg -s libopenblas-dev`
- Check available disk space – the build temporarily requires several GB
- If RAM is tight, a swapfile helps: `sudo dphys-swapfile setup`

**numpy version conflicts**
`sensors` and `slam` venvs intentionally pin numpy to `1.24` for compatibility with `scipy==1.11.4`. This is isolated from the `ai` venv which uses the latest numpy.

**Pi won't boot after shutdown**
Add `POWER_OFF_ON_HALT=0` to `/boot/firmware/config.txt`. Without this, the Pi enters a halt state that requires a physical button press.

---

## License

MIT License

Copyright (c) 2026 Hoehlenbaer (https://github.com/Hoehlenbaer/SLARC)

Permission is hereby granted, free of charge, to any person obtaining a copy of this software and associated documentation files (the "Software"), to deal in the Software without restriction, including without limitation the rights to use, copy, modify, merge, publish, distribute, sublicense, and/or sell copies of the Software, and to permit persons to whom the Software is furnished to do so, subject to the following conditions:

The above copyright notice and this permission notice shall be included in all copies or substantial portions of the Software.

THE SOFTWARE IS PROVIDED "AS IS", WITHOUT WARRANTY OF ANY KIND, EXPRESS OR IMPLIED, INCLUDING BUT NOT LIMITED TO THE WARRANTIES OF MERCHANTABILITY, FITNESS FOR A PARTICULAR PURPOSE AND NONINFRINGEMENT. IN NO EVENT SHALL THE AUTHORS OR COPYRIGHT HOLDERS BE LIABLE FOR ANY CLAIM, DAMAGES OR OTHER LIABILITY, WHETHER IN AN ACTION OF CONTRACT, TORT OR OTHERWISE, ARISING FROM, OUT OF OR IN CONNECTION WITH THE SOFTWARE OR THE USE OR OTHER DEALINGS IN THE SOFTWARE.

---

*If you use SLARC code or techniques in your own project, a mention or link back is always appreciated — not required, just good open-source karma.*
