Hoehlenbaer/SLARC/src_dev/ai/brain/ergebnisse/2026-11-08/pi_matrix_1748.md

# Pi-Messreihe 08.11.2026 17:48

| Lauf | Modell | mmproj | Slots | zielwahl Wechsel / wiederholt | chat Wechsel / wiederholt | objekt Wechsel / wiederholt | suchorte Wechsel / wiederholt | Prompt tok/s (Zielwahl) | Erzeugung tok/s | frei MB | °C Ende |
|---|---|---|---|---|---|---|---|---|---|---|---|
| slots-1 | Qwen3.5-4B-Q4_K_M.gguf | mmproj-Qwen3.5-4B-Q8_0.gguf | 1 | 71.66 / 12.64 s | 43.69 / 9.37 s | 28.95 / 12.04 s | 23.09 / 12.23 s | 19.1 | 3.1 | 3938 | 63.4 |
| slots-4 | Qwen3.5-4B-Q4_K_M.gguf | mmproj-Qwen3.5-4B-Q8_0.gguf | 4 | 12.25 / 12.28 s | 8.85 / 8.79 s | 11.24 / 11.29 s | 11.47 / 11.43 s | 9.7 | 3.2 | 2909 | 66.1 |
