Hoehlenbaer/SLARC/src_dev/ai/brain/ergebnisse/2026-11-08/pi_matrix_2056.md

# Pi-Messreihe 08.11.2026 20:56

| Lauf | Modell | mmproj | Slots | zielwahl Wechsel / wiederholt / anders | chat Wechsel / wiederholt / anders | objekt Wechsel / wiederholt / anders | suchorte Wechsel / wiederholt / anders | Prompt tok/s (Zielwahl) | Erzeugung tok/s | Server anon MB | Server Datei MB | frei MB | °C Ende |
|---|---|---|---|---|---|---|---|---|---|---|---|---|---|
| inhalt-q35-4b | Qwen3.5-4B-Q4_K_M.gguf | mmproj-Qwen3.5-4B-Q8_0.gguf | 4 | 11.69 / 11.62 / 19.41/19.08 s | 8.43 / 8.4 / 9.74/8.85 s | 10.05 / 10.03 / 14.96/14.06 s | 12.02 / 12.07 / 14.98/11.51 s | 10.0 | 3.4 | 4174 | 2352 | 3197 | 63.9 |
| inhalt-q3-4b | Qwen3-4B-Instruct-2507-Q4_K_M.gguf | – | 4 | 14.85 / 14.86 / 22.77/23.26 s | 9.88 / 9.67 / 10.38/9.79 s | 8.43 / 8.43 / 11.34/11.23 s | 10.36 / 10.38 / 13.04/9.99 s | 3.4 | 3.4 | 3094 | 2376 | 4306 | 63.4 |
