Hoehlenbaer/SLARC/Drawings/Macros/SLARC_Stueckliste.xlsx

Sheet: Legende
SLARC – Stückliste (BOM)
Druckeinstellungen | Blatt Druckeinstellungen: Werte, die für alle Teile eines Materials gelten. Teilespezifisches (Füllung, Wände, Ausrichtung, Stützen) im Blatt Druckteile.
Blaue Schrift | Eingabewerte (Mengen, Volumen, Schätzwerte) – bei Änderungen hier anpassen
Gelb hinterlegt | Von dir auszufüllen: Einzelpreis, Status, Bezugsquelle
Schwarze Schrift | Formeln – nicht überschreiben
Bestellliste | Blatt Bestellliste: Schrauben und Elektronik geordnet, Mengen inkl. Reserve per Formel aus Kaufteile, Status ebenfalls aus Kaufteile.
Stand | Konstruktion: Bein V9.1 (Femur 150, Tibia 175, Knick 38,6°), Baseplates V2.7 (DC-DC, Modulplätze, Steckerhalter, Akku-Riegel), Kamerahalter V1.5, Panzer V1.1
Druckteil-Volumen | aus dem FreeCAD-Modell (Gesamtmodell, Standardparameter). Ändern sich Femur/Tibia-Längen, ändern sich die Volumen.
Gewichte | Gedruckte Masse = Volumen × Dichte × Füllfaktor. Der Füllfaktor ist eine Schätzung; Cura zeigt nach dem Slicen den echten Wert.
Beispielzeile | Zeile 'Servo ST3215' im Blatt Kaufteile zeigt das Format: Preis eintragen -> Gesamtpreis rechnet sich.
Cura-Projekte | Drawings/Cura/make_cura_3mf.py liest das Blatt Druckteile: Zeilen mit STL-Datei (Spalte N) bekommen ein Projekt AKP_<STL>.3mf. Material (C), Füllung (erste Zahl in J), Wände (K), Ausrichtung (O: Fläche des Modells, die aufs Bett kommt: -Z = wie modelliert, +Z = Oberseite, ±X/±Y = Seitenflächen). In M wird 'Brim N mm' und 'Tree Support' erkannt. Spalte P: weitere Cura-Einstellungen pro Modell als key=value; key=value.

Sheet: Kaufteile
Pos | Gruppe | Bauteil | Spezifikation / Hinweis | Menge | Reserve | Bestellmenge | Einzelpreis (€) | Gesamt (€) | Status | Bezugsquelle
1 | Antrieb | Servo ST3215 (Feetech/Waveshare, 12 V) | 30 kg·cm (2,94 Nm) Stall; Blechschrauben 2x5 beiliegend | 18 | 2 |  | 24.90 €
2 | Steuerung | Raspberry Pi 5 | inkl. Active Cooler | 1 | 0 |  |  |  | vorhanden
3 | Steuerung | Raspberry Pi Active Cooler | falls nicht beim Pi | 1 | 0
4 | Steuerung | Hailo-8 AI HAT+ (26 TOPS) | bringt eigene Abstandsbolzen + GPIO-Verlängerung mit | 1 | 0 |  |  |  | vorhanden
5 | Steuerung | Waveshare General Driver for Robots | ESP32, Bus-Servo-Anschluss | 1 | 0 |  |  |  | vorhanden
6 | Energie | DC-DC 12 V -> 5 V / 5 A Fulree F35J5V5A1S-C | Versorgung Pi 5; 46,2x27,5x14, auf Baseplate oben hinten | 1 | 0
7 | Steuerung | IO-Expander MCP23017-E (Modul/Breakout) | auf Hub-Platine B (seitliche Stiftleiste); Adresse 0x20 (A0–A2 auf GND); Füße an PA0–5, ITA -> IO34; ~7,30 € | 1 | 0
8 | Steuerung | I2C-Hub / Multiplexer TCA9548A (optional) | Modulplatz MUX ist reserviert | 1 | 0
9 | Steuerung | Drucktaster 12 mm, Einbau, Schließer (Metall, IP65) | Ein/Aus: weckt ESP32 aus dem Deep Sleep (IO35), kurz = aus, 5 s = Notaus; Gewindelänge >= 6 mm, Kopf-Ø <= 15 mm | 1 | 0
10 | Verdrahtung | Widerstand 10 kΩ | Pull-ups Fußkontakte (6) + Ein/Aus-Taster an IO35 (1) | 7 | 4
11 | Verdrahtung | WS2812B-LED-Streifen (optional) | Daten an IO4; 5 V vom Treiber (bis ~10 LEDs) oder vom DC-DC | 1 | 0
12 | Sensorik | IMX296 Kamera-Modul mit ext. Trigger | 39x39 mm, M12-Halter | 2 | 0 |  |  |  | vorhanden
13 | Sensorik | M12-Objektiv 2,8 mm (ZH3019-14) | F2.2, 1/2.7" | 2 | 0
14 | Sensorik | CSI-Kabel Pi 5 (22-pol auf 15-pol), ca. 200 mm | Kamera -> Pi 5 CAM0/CAM1 | 2 | 0
15 | Sensorik | Trigger-Verteilerplatine | Eigenbau, 20x22 mm | 1 | 0
16 | Sensorik | Mikroschalter D2F (oder ähnlich) | Fußkontakt; Maße im Bein-Makro (sw_*) anpassen | 6 | 2
17 | Sensorik | IMU ICM-20948 (Pimoroni-Breakout) | vorhanden (vom alten Kameramodul); oben auf dem Kamerahalter, I²C am Pi | 1 | 0 |  |  |  | vorhanden
18 | Energie | LiPo ZEEE 3S 9000 mAh | ca. 170x50x32 mm, Deans (Buchse am Akku) | 1 | 0 |  |  |  | vorhanden
19 | Energie | BMS 3S (Daly 12 V 60 A oder 30–40 A) | kleineres BMS reicht (Mittel ~10 A, Spitzen 20–30 A) | 1 | 0
20 | Energie | Flachsicherung 30 A + Inline-Halter | F1 in der Plusleitung Deans -> Power-Board; Standard-Flachsicherung (ATO), Halter mit Litze ≥ AWG14 (z. B. Neuftech 30 A wasserdicht); Reserve = Ersatzsicherung gleicher Bauform | 1 | 1
21 | Energie | Relaismodul 8-Kanal | 8× SRD-05VDC-SL-C (10 A): K1 12 V -> DC-DC (Pi), K2–K7 je ein Bein, K8 frei; Jumper JD-VCC ziehen (VCC 3,3 V, JD-VCC 5 V) | 1 | 0 |  |  |  | vorhanden
22 | Energie | Deans-T-Stecker (Stifte, Robot-Seite) | Gegenstück zur Deans-Buchse am Akku; sitzt im Steckerhalter (untere Platte hinten) | 1 | 1
23 | Energie | Litze AWG20 rot/schwarz (m) | vorhanden; je Bein 12 V (von Kx NO) + GND, Relais-COM, DC-DC, Pi-5V (je Pol 2 Adern) | 12 | 0 |  |  |  | vorhanden
24 | Verdrahtung | Bein-Platine A (Lochraster ½ 3×7 cm) | Eigenbau, Layout Documentation/Wiring | 6 | 1
25 | Verdrahtung | JST-XH 2,54 Steckverbinder-Sortiment |  | 1 | 0
26 | Verdrahtung | Dupont-Kabel (Trigger/Strobe) | Kameras <-> Trigger-Platine | 4 | 2
27 | Verdrahtung | Elko 470 µF / 25 V (radial, low ESR) | je Bein-Platine, + an 12 V | 6 | 2
28 | Verdrahtung | Keramikkondensator 100 nF | Abblockung MCP23017 (Hub) | 1 | 4
29 | Verdrahtung | Transistor BC547 (NPN) | Relais-Adapter: Pi hält K1 (Diode ginge nicht, ausgeschalteter Pi zieht den Eingang) | 1 | 1
30 | Verdrahtung | Widerstand 4,7 kΩ | Basiswiderstand BC547 | 1 | 2
31 | Verdrahtung | Stiftleiste 2,54 mm gerade, 40-pol. | Servo-Anschlüsse Bein-Platinen (18× 3-pol.) | 2 | 0
32 | Verdrahtung | Buchsenleiste 2,54 mm, 10-pol., gewinkelt | Relais-Adapter auf die Eingangsstifte des Relaismoduls (nur ~16 mm Höhe frei) | 1 | 0
33 | Verdrahtung | Lochrasterplatinen AZ-Delivery | vorhanden: 3× 3×7 (6 Bein-Platinen), 2× 5×7 (Hub, Power), 1× 2×8 (Relais-Adapter) | 1 | 0 |  |  |  | vorhanden
34 | Verdrahtung | Signal-Litze AWG24, mehrere Farben (m) | für XH-Crimps (AWG20 passt nicht in XH-Kontakte): Hub <-> Beine, I²C, INT, Relais | 10 | 0
35 | Energie | Litze AWG14 rot/schwarz (m) | Akku -> Sicherung -> Power-Board, Akku- -> BMS -> Power-Board; alternativ 3× AWG20 parallel | 1 | 0
36 | Verdrahtung | Kupferdraht 1,5 mm² massiv (m) | Sammelschienen Power-Board (z. B. NYM-Rest) | 0.5 | 0
37 | Verdrahtung | Kupferdraht verzinnt 0,8 mm (m) | Schienen Bein-Platinen und Hub | 2 | 0
38 | Verdrahtung | Servokabel 5264 3-pol. | H5 -> Hub (nur DATA + GND), ggf. Verlängerung Tibia-Servo | 2 | 2
39 | Verbindung | Zylinderschraube M3x8 (ISO 7380/4762) | Gabelwange oben -> Horn, 4 je Gelenk; NICHT länger (Servogehäuse) | 72 | 8
40 | Verbindung | Zylinderschraube M3x6 | Gabelwange unten -> Rückscheibe, 4 je Gelenk (72); Relaismodul in Gewindeeinsätze (4); nicht länger | 76 | 8
41 | Verbindung | Blechschraube 2x5 (beiliegend bei ST3215) | Coxa 4 je Servo (Platten), Bein-Servos 2 je Servo | 48 | 0
42 | Verbindung | Zylinderschraube M3x50 | alle 8 Säulen von unten: 6 in die Gewindeeinsätze der Panzersäulen, 2 bei x = -40 mit Sicherungsmutter (5,6 mm Überstand unter dem Panzer) | 8 | 1
43 | Verbindung | Gewindeeinsatz M3 (Einschmelzmutter, 5,7 lang, Ø4,6) | Panzersäulen (6) + Relais-Bunde auf der unteren Platte (4) | 10 | 2 |  |  |  | vorhanden
44 | Verbindung | Zylinderschraube M3x12 + Mutter | Teilungsspant Panzer | 3 | 1
45 | Verbindung | Zylinderschraube M3x10 | Plattenstoß, 4 je Platte | 8 | 2
46 | Verbindung | Sicherungsmutter M3 (Nylonring) | Plattenstoß (8) + 2 Säulen M3x50 bei x = -40 (2) | 10 | 4
47 | Verbindung | Zylinderschraube M3x10 + Mutter | DC-DC-Laschen (2) + Hub-Träger (2) + Steckerhalter Akku (2) + Taster-Winkel (1) | 7 | 2
48 | Verbindung | Linsenkopfschraube M2x6 | Kamera-Platinen (8) + Lochraster-Platinen (18), direkt in die 1,7-mm-Kernlöcher | 26 | 4 |  |  |  | vorhanden
49 | Verbindung | Zylinderschraube M3x25 + Mutter | Kamerahalter-Laschen durch Sockel + Platte (Bohrung 3,2 = M3) | 2 | 1
50 | Verbindung | Zylinderschraube M2,5x16 | Pi 5: von unten durch Platte, gedruckte Hülse und Pi in die Abstandsbolzen des AI HAT+ (ersetzt dessen lange Schrauben) | 4 | 2
51 | Verbindung | Distanzhülsen M2,5 x 16 + Schrauben M2,5x7 (Treiber) | liegen dem Treiber bei | 4 | 0 |  |  |  | vorhanden
52 | Verbindung | Kunststoff-Unterlegscheiben M2/M2,5/M3 (Sortiment) |  | 1 | 0 |  |  |  | vorhanden
53 | Verbindung | Federstahldraht 1,2 mm (m) | Haltestifte Mikroschalter: quer durch Tibia und Schalterlöcher, bündig abknipsen (2 je Fuß); Ersatz: Stahlnagel Ø1,2 oder aufgebogene Büroklammer | 0.5 | 0
54 | Kleinteile | Kabelbinder 2,5 mm | Kabelösen Femur/Tibia | 50 | 0
55 | Kleinteile | Klettband 20 mm (m) | Batterie 2 Gurte, BMS 1 Gurt | 1 | 0
56 | Kleinteile | Moosgummi EPDM 5 mm, selbstklebend (Streifen, ca. 20 mm breit) | Akku: Streifen unter die obere Platte (Spalt 4,1 mm) gegen Klappern; 1 Stück 20x20 mit Ø9-Loch unter den Kopf des Akku-Riegels | 1 | 0
57 | Kleinteile | Doppelseitiges Klebeband | Trigger-Platine | 1 | 0
58 | Kleinteile | 2K-Epoxid oder Sekundenkleber + Primer | Zierleisten | 1 | 0
59 | Filament | PETG schwarz (kg) | siehe Blatt Druckteile; inkl. Probedrucke | 2 | 0
60 | Filament | TPU 95A (kg) | Füße | 0.25 | 0
61 | Filament | PLA orange (kg) | Zierleisten | 0.1 | 0
 |  |  |  |  |  |  | Summe
 |  |  |  |  |  |  | Preise erfasst

Sheet: Bestellliste
Bestellliste – Mengen inkl. Reserve, rechnen aus dem Blatt Kaufteile (Spalte Bestellmenge). Status aus Kaufteile.
Schrauben, Muttern, Einsätze
Gruppe | Teil | Bestellmenge | Status | Verwendung
Blechschraube | Blechschraube 2x5 (beiliegend bei ST3215) |  |  | Coxa-Servos an den Platten (4 je Servo), Bein-Servos unten (2 je Servo); liegen den Servos bei
M2 | Linsenkopfschraube M2x6 |  |  | Kamera- und Lochraster-Platinen in 1,7-mm-Kernlöcher
M2,5 | Zylinderschraube M2,5x16 |  |  | Pi 5 durch Platte + gedruckte Hülse in die HAT-Bolzen
M3 | Zylinderschraube M3x6 |  |  | Gabelwange unten + Relaismodul (Gewindeeinsätze)
M3 | Zylinderschraube M3x8 |  |  | Gabelwange oben -> Horn, 4 je Gelenk
M3 | Zylinderschraube M3x10 |  |  | Plattenstoß (8, mit Sicherungsmutter); DC-DC, Hub-Träger, Steckerhalter, Taster-Winkel (7, mit Mutter)
M3 | Zylinderschraube M3x12 |  |  | Teilungsspant Panzer
M3 | Zylinderschraube M3x25 |  |  | Kamerahalter-Laschen durch Sockel + Platte
M3 | Zylinderschraube M3x50 |  |  | alle 8 Säulen (6 in Gewindeeinsätze, 2 mit Sicherungsmutter)
Muttern | Mutter M3 (DIN 934) |  |  | zu allen Schrauben „+ Mutter“ (M3x10, M3x12, M3x25)
Muttern | Sicherungsmutter M3 (Nylonring) |  |  | Plattenstoß, 2 Säulen bei x = -40
Einsätze | Gewindeeinsatz M3 (5,7 lang, Ø4,6) |  |  | Panzersäulen + Relais-Bunde
Sonstiges | Kunststoff-Unterlegscheiben M2/M2,5/M3 (Sortiment) |  |  | Elektronik isoliert befestigen
Sonstiges | Federstahldraht 1,2 mm (m) |  |  | Haltestifte Mikroschalter
Elektronik und Verdrahtung
Gruppe | Teil | Bestellmenge | Status | Verwendung
Antrieb | Servo ST3215 (Feetech/Waveshare, 12 V) |  |  | 18 Servos, 3 je Bein
Rechner | Raspberry Pi 5 |  |  | Perzeption, Planung
Rechner | Raspberry Pi Active Cooler |  |  | falls nicht beim Pi
Rechner | Hailo-8 AI HAT+ (26 TOPS) |  |  | NPU
Rechner | Waveshare General Driver for Robots |  |  | ESP32, Servo-Bus
Energie | LiPo ZEEE 3S 9000 mAh |  |  | Akku
Energie | BMS 3S (Daly 12 V 60 A oder 30–40 A) |  |  | Kurzschluss-, Überstrom-, Zellenschutz
Energie | Flachsicherung 30 A + Inline-Halter |  |  | F1 in der Plusleitung; Inline-Halter, Litze ≥ AWG14
Energie | Deans-T-Stecker (Stifte, Robot-Seite) |  |  | Steckerhalter
Energie | DC-DC 12 V -> 5 V / 5 A Fulree F35J5V5A1S-C |  |  | Pi-Versorgung
Energie | Relaismodul 8-Kanal |  |  | K1 Pi, K2–K7 Beine
Sensorik | IMX296 Kamera-Modul mit ext. Trigger |  |  | Stereo
Sensorik | M12-Objektiv 2,8 mm (ZH3019-14) |  |  | Stereo
Sensorik | CSI-Kabel Pi 5 (22-pol auf 15-pol), ca. 200 mm |  |  | Kamera -> Pi
Sensorik | IMU ICM-20948 (Pimoroni-Breakout) |  |  | VIO/SLAM am Pi
Sensorik | Mikroschalter D2F (oder ähnlich) |  |  | Fußkontakte
Bauteile | IO-Expander MCP23017-E (Modul/Breakout) |  |  | Hub-Platine
Bauteile | Drucktaster 12 mm, Einbau, Schließer (Metall, IP65) |  |  | Ein/Aus
Bauteile | Widerstand 10 kΩ |  |  | Pull-ups Füße + Taster
Bauteile | Widerstand 4,7 kΩ |  |  | Basiswiderstand BC547
Bauteile | Transistor BC547 (NPN) |  |  | Relais-Adapter
Bauteile | Elko 470 µF / 25 V (radial, low ESR) |  |  | Bein-Platinen
Bauteile | Keramikkondensator 100 nF |  |  | Hub
Optional | I2C-Hub / Multiplexer TCA9548A (optional) |  |  | nicht nötig, Platz vom Hub belegt
Optional | WS2812B-LED-Streifen (optional) |  |  | Status-LEDs an IO4
Stecker & Kabel | JST-XH 2,54 Steckverbinder-Sortiment |  |  | Hub <-> Beine, Fußschalter, Taster, Treiber
Stecker & Kabel | Stiftleiste 2,54 mm gerade, 40-pol. |  |  | Servo-Anschlüsse Bein-Platinen
Stecker & Kabel | Buchsenleiste 2,54 mm, 10-pol., gewinkelt |  |  | Relais-Adapter
Stecker & Kabel | Dupont-Kabel (Trigger/Strobe) |  |  | Kameras, I²C, Pi-GPIO
Stecker & Kabel | Servokabel 5264 3-pol. |  |  | H5 -> Hub, ggf. Verlängerung
Stecker & Kabel | Signal-Litze AWG24, mehrere Farben (m) |  |  | gesteckte Signalleitungen
Stecker & Kabel | Litze AWG14 rot/schwarz (m) |  |  | Akku -> F1 -> Power-Board
Stecker & Kabel | Litze AWG20 rot/schwarz (m) |  |  | Strom je Bein, Relais, DC-DC, Pi
Stecker & Kabel | Kupferdraht 1,5 mm² massiv (m) |  |  | Sammelschienen Power-Board
Stecker & Kabel | Kupferdraht verzinnt 0,8 mm (m) |  |  | Schienen Bein-Platinen, Hub
Platinen | Lochrasterplatinen AZ-Delivery |  |  | 3× 3×7, 2× 5×7, 1× 2×8

Sheet: Druckteile
Bauteil | Makro / Objekt | Material | Anzahl | Volumen je Teil (cm³) | Dichte (g/cm³) | Masse massiv je Teil (g) | Füllfaktor | Masse gedruckt gesamt (g) | Füllung (Cura) | Wände (Linien à 0,4) | Druckausrichtung | Stützen / Besonderes | STL-Datei (für Cura-Projekt) | Cura-Ausrichtung (Fläche aufs Bett) | Cura-Extras (key=value; …)
Coxa rechts | Bein-Makro, Coxa_Part | PETG | 3 | 21.71 | 1.27 |  | 0.8 |  | 50 % Gyroid | 4 | Gelenkachse senkrecht | Tree Support | SLARC_Leg_Coxa | -Z | support_top_distance=0.2; support_roof_enable=True; support_roof_density=80; support_xy_distance=0.8; support_roof_offset=1.5
Coxa links (gespiegelt) | MIRROR = True oder in Cura spiegeln | PETG | 3 | 21.71 | 1.27 |  | 0.8 |  | 50 % Gyroid | 4 | Gelenkachse senkrecht | Tree Support
Femur rechts | Femur_Part | PETG | 3 | 48.61 | 1.27 |  | 0.8 |  | 40 % Gyroid (nur Gelenkbereiche) | 5 | Gelenkachse senkrecht | Tree Support; 5 Wände = 2-mm-Rohrwand; Brückeneinstellungen an (16-mm-Decke im Rohr) | SLARC_Leg_Femur | -Z | support_top_distance=0.2; support_roof_enable=True; support_roof_density=80; support_xy_distance=0.8; support_roof_offset=1.5; minimum_support_area=20
Femur links (gespiegelt) | Femur_Part, gespiegelt | PETG | 3 | 48.61 | 1.27 |  | 0.8 |  | 40 % Gyroid (nur Gelenkbereiche) | 5 | Gelenkachse senkrecht | Tree Support; Brückeneinstellungen an
Tibia rechts | Tibia_Part | PETG | 3 | 57.13 | 1.27 |  | 0.8 |  | 40 % Gyroid | 5 | Gelenkachse senkrecht | Tree Support; Brückeneinstellungen an | SLARC_Leg_Tibia | -Z | support_top_distance=0.2; support_roof_enable=True; support_roof_density=80; support_xy_distance=0.8; support_roof_offset=1.5
Tibia links (gespiegelt) | Tibia_Part, gespiegelt | PETG | 3 | 57.13 | 1.27 |  | 0.8 |  | 40 % Gyroid | 5 | Gelenkachse senkrecht | Tree Support; Brückeneinstellungen an
Fuß | Foot_TPU | TPU 95A | 6 | 17.51 | 1.21 |  | 0.8 |  | 20–25 % Gyroid | 5 | Öffnung nach unten | Brim 5 mm (hohes, weiches Teil auf schmalem Rand; 14.11.2026). Keine Stützen (Hohlraumdecke: 8-mm-Brücke zwischen 45°-Fasen); STL in Druckausrichtung | SLARC_Leg_Foot | -Z
Zierleiste Femur | Deco_Femur_A/B | PLA | 12 | 0.92 | 1.24 |  | 1 |  | 20 % | 2 | flach | keine | SLARC_Leg_Deco_Femur | -Z
Zierleiste Tibia | Deco_Tibia_A/B | PLA | 12 | 1.04 | 1.24 |  | 1 |  | 20 % | 2 | flach | keine | SLARC_Leg_Deco_Tibia | -Z
Baseplate oben vorn | Baseplate_Top_Front | PETG | 1 | 137.33 | 1.27 |  | 0.85 |  | 40 % Gyroid | 4 | Unterseite aufs Bett | keine; Brim 8 mm; V2.13: Fenster unter Pi und Treiber | SLARC-Baseplate_Top_Front | -Z
Baseplate oben hinten | Baseplate_Top_Rear | PETG | 1 | 88.45 | 1.27 |  | 0.85 |  | 40 % Gyroid | 4 | Oberseite aufs Bett (Stoßzunge oben flach) | keine; Brim 8 mm | SLARC-Baseplate_Top_Rear | +Z
Baseplate unten vorn | Baseplate_Bottom_Front | PETG | 1 | 191.43 | 1.27 |  | 0.85 |  | 40 % Gyroid | 4 | Unterseite aufs Bett | keine; Brim 8 mm; M2-Bunde für 4 Bein-Platinen; V2.13: Servo-Wiegen FR/FL/MR/ML (Wangen stehend, ohne Stützen) | SLARC-Baseplate_Bottom_Front | -Z
Baseplate unten hinten | Baseplate_Bottom_Rear | PETG | 1 | 108.54 | 1.27 |  | 0.85 |  | 40 % Gyroid | 4 | Unterseite aufs Bett | flache Stütze nur unter der Stoßzunge (sonst Support-Blocker); Brim 8 mm; V2.13: Servo-Wiegen RR/RL | SLARC-Baseplate_Bottom_Rear | -Z | support_enable=True; minimum_support_area=20
Kamerahalter | Stereo-Makro V1.5 / Stereo_Mount | PETG | 1 | 30.7 | 1.27 |  | 0.85 |  | 40 % Gyroid | 4 | Frontfläche aufs Bett | keine; Brim 6–8 mm | SLARC-Stereo_Mount | +X
Steckerhalter Akku | Baseplate-Makro V2.6 / Connector_Holder | PETG | 1 | 4.06 | 1.27 |  | 1 |  | 100 % | 4 | Laschen aufs Bett | keine; Tunnel als kurze Brücken | SLARC_Connector_Holder | -Z
Akku-Riegel (Bajonettstift) | Baseplate-Makro V2.7 / Battery_Latch (STL: SLARC_Battery_Latch_Pin) | PETG | 1 | 3.63 | 1.27 |  | 1 |  | 100 % | 4 | stehend, Kopf aufs Bett | keine | SLARC_Battery_Latch_Pin | -Z
Rückenpanzer vorn | slarc_cover_v1.py V1.2 / Cover_Front | PETG | 1 | 81.3 | 1.27 |  | 0.9 |  | 100 % (Gitter) | 4 | Grundfläche aufs Bett | keine; Dachunterseite 50°
Rückenpanzer hinten | slarc_cover_v1.py V1.2 / Cover_Rear | PETG | 1 | 71.54 | 1.27 |  | 0.9 |  | 100 % (Gitter) | 4 | Grundfläche aufs Bett | keine; Dachunterseite 50°
Hub-Träger | Baseplate-Makro V2.8 / Hub_Carrier | PETG | 1 | 6.87 | 1.27 |  | 0.85 |  | 40 % | 4 | flach, Bunde nach oben | keine | SLARC_Hub_Carrier | -Z
Power-Brücke | Baseplate-Makro V2.8 / Power_Bridge | PETG | 1 | 12.52 | 1.27 |  | 0.85 |  | 40 % | 4 | Deck aufs Bett, Bunde nach oben | keine | SLARC_Power_Bridge | -Z
Hülse Power-Brücke | Baseplate-Makro V2.8 / Power_Bridge_Sleeve | PETG | 2 | 1.38 | 1.27 |  | 1 |  | 100 % | 4 | stehend | keine | SLARC_Power_Bridge_Sleeve | -Z
Distanzhülse Pi | Baseplate-Makro V2.9 / Pi_Sleeve | PETG | 4 | 0.13 | 1.27 |  | 1 |  | 100 % | 4 | stehend | keine; Bohrung bei Bedarf auf 2,8–3 mm aufbohren | SLARC_Pi_Sleeve | -Z
Taster-Winkel | Baseplate-Makro V2.10 / Button_Bracket | PETG | 1 | 2.48 | 1.27 |  | 1 |  | 100 % | 4 | Fuß aufs Bett, Blende stehend | keine | SLARC_Button_Bracket | -Z
ST3215-Dummy (optional) | Drawings/STL files/ST3215_Dummy.stl | PETG | 0 | 34.4 | 1.27 |  | 0.5 |  | 15 % | 3 | seitlich liegend | keine; Anzahl nach Bedarf eintragen (Platzhalter für fehlende Coxa-Servos) | ST3215_Dummy | -Y
Summe nach Material
PETG |  |  |  |  |  |  | g gesamt
TPU 95A |  |  |  |  |  |  | g gesamt
PLA |  |  |  |  |  |  | g gesamt
Alle Druckteile
Hilfsmittel (nicht im Robotergewicht)
Bein-Prüfstand Unterteil | Baseplate-Makro V2.12 / Leg_Test_Stand_Base (STL: SLARC_Leg_Test_Stand_Base) | PLA | 1 | 117.27 | 1.24 |  | 0.5 |  | 15 % | 3 | Platte aufs Bett, Wände nach oben | keine; Achse 60 mm vor der Tischkante (Kerben), mit Schraubzwinge klemmen; 4× M3-Gewindeeinsatz oben in die Wände; V2.13 mit Servo-Wiege; 0,2-mm-Schichten (0,4 zu grob für Gewindeeinsätze) | SLARC_Leg_Test_Stand_Base | -Z
Bein-Prüfstand Deckel | Baseplate-Makro V2.12 / Leg_Test_Stand_Cap (STL: SLARC_Leg_Test_Stand_Cap) | PLA | 1 | 18.5 | 1.24 |  | 0.85 |  | 40 % Gyroid | 4 | Oberseite aufs Bett (Tasche oben) | keine; 4× M3x8 in die Einsätze; dichter als das Unterteil, weil hier die Servoschrauben sitzen (1,5 mm unter dem Kopf) | SLARC_Leg_Test_Stand_Cap | +Z
Elektronik-Testbrett | Baseplate-Makro V2.15 / Bench_Board (STL: SLARC_Bench_Board) | PLA | 1 | 166.5 | 1.24 |  | 0.5 |  | 15 % Gyroid | 3 | Platte aufs Bett | keine; Relais auf 4× M3-Einsatz + M3x6, Treiber auf Hülsen mit M2.5x7 von unten, Power C und Bein A mit M2x6 | SLARC_Bench_Board | -Z
Testbrett-Adapter Relais | Baseplate-Makro V2.15 / bench_adapters (STL: SLARC_Bench_Adapter_Relay) | PLA | 1 | 16.2 | 1.24 |  | 0.5 |  | 20 % Gyroid | 3 | Platte aufs Bett | keine; nur für Testbrett V2.14: 4× M3x8 in die alten Einsätze, Modul mit 4× M3x12 + Mutter (Sechskant unten) | SLARC_Bench_Adapter_Relay | -Z
Testbrett-Adapter Power C | Baseplate-Makro V2.15 / bench_adapters (STL: SLARC_Bench_Adapter_PowerC) | PLA | 1 | 7 | 1.24 |  | 0.5 |  | 20 % Gyroid | 3 | Platte aufs Bett | keine; nur für Testbrett V2.14: 2× M2x6 in die alten Bunde, Platine mit 2× M2x10 + Mutter (seitlich einschieben) | SLARC_Bench_Adapter_PowerC | -Z
TPU-Fuß Passungsringe (Test, V1.1) | slarc_foot_fit_test_v1.py / Foot_Fit_Rings (STL: SLARC_Foot_Fit_Rings) | TPU 95A | 1 | 7.89 | 1.21 |  | 1 |  | 100 % | 5 | Öffnung (Lippenseite) aufs Bett | keine; 4 Ringe mit Lippe 0,5 mm (Punkt auf der Lasche), Gleitspiel slide_c 0,5–0,8 mm, Wert erhaben auf der Lasche; Ring mit der Bettseite voran auf die Tibia schieben | SLARC_Foot_Fit_Rings | -Z
Fuß-Gleithülse PETG (Test, 3 Spielvarianten) | slarc_foot_slider_test_v1.py V1.1 / Foot_Slider_Test (STL: SLARC_Foot_Slider_Test) | PETG | 1 | 32.5 | 1.27 |  | 1 |  | 100 % | 4 | Stirnwand aufs Bett | keine (Senkungsdecke 6,5-mm-Brücke); Spiel 0,2/0,3/0,4 mm je Seite (Zahl vertieft auf der Seite); je Hülse 1 Zylinderschraube M3x6 direkt ins PETG (Schaltpunkt, Kopf versenkt) | SLARC_Foot_Slider_Test | -Z

Sheet: Druckeinstellungen
Einstellung | PETG | TPU 95A | PLA
Düse | 0,4 mm | 0,4 mm | 0,4 mm
Schichthöhe | 0,2 mm (erste Schicht 0,2–0,24 mm) | 0,2 mm | 0,2 mm
Düsentemperatur | 230 °C (erste Schicht 235, Ende 225; Temperaturturm Anycubic PETG 10.11.2026) | 225 °C | 210 °C
Betttemperatur | 80 °C, große flache Teile 85 °C | 50 °C | 60 °C
Lüfter | erste 3–4 Schichten aus, danach max. 30–40 % | 50 % | 100 % ab Schicht 2
Druckgeschwindigkeit | normal; erste Schicht 20 mm/s | 20–25 mm/s (Profil 20, Wände 10); Fahrt 120 mm/s (80 gab Fäden an der Kugelkuppe, 14.11.2026) | normal
Erste Schicht | Linienbreite 120 %, horizontale Ausdehnung −0,1 mm (Elefantenfuß) | Linienbreite 120 % | Linienbreite 120 %
Löcher | horizontale Ausdehnung für Löcher 0,15 mm (aus Marcos Cura-Profil) | – | wie PETG: 0,15 mm
Rückzug (Retract) | 4,5 mm (Bowden, aus Marcos Profil) | kurz (≤ 1 mm) oder aus | 3 mm aus Material eSUN PLA+; bei Fäden 4–4,5 mm
Brücken | Brückeneinstellungen an: Wand/Haut 20–25 mm/s, Lüfter Brücke 100 %, Haut-Fluss 100 % (bei Durchhängen 90 %), mehrere Brückenschichten an | – | –
Wände (Standard) | 4 Linien (1,6 mm); Bein-Rohre 5 Linien = 2 mm | 5 Linien | 3 Linien (Zierleisten 2)
Deck-/Bodenschichten | je 5 (1 mm) | je 4 | oben 5 (1,0 mm), unten 4 (0,8 mm)
Haftung | Brim bei großen flachen Teilen (Platten 8 mm, Kamerahalter 6–8 mm), sonst keine | keine | keine
Umgebung | kein Luftzug; Teil auf dem Bett abkühlen lassen | – | –
Kernlöcher | M2 = 1,7 mm, M2,5 = 2,1 mm: Wandzahl ist wichtiger als Füllung | – | –
Kleinteile | mehrere 100-%-Teile zusammen auf eine Platte (Kühlzeit je Schicht) | – | –
Stützen | Tree, nur vom Druckbett; Dach 80 %, Abstand oben 0,2 mm, XY 0,8 mm, Dachversatz 1,5 mm (pro Teil in Spalte P der Druckteile). Lüfter für gestützte Haut 100 % (Lüfterdrehzahl überschreiben, 12.11.2026) | keine | wie PETG: Lüfter für gestützte Haut 100 %
Beschleunigung / Ruck | Druck 500 mm/s², Ruck 5 mm/s (Marcos Profil); Fahrt 1000 mm/s², Ruck 8 mm/s (13.11.2026, vorher Cura-Standard 5000/30 -> Vibrationen beim Stützendruck) | Druck 500 mm/s², Ruck 5 mm/s; Fahrt 1000 mm/s², Ruck 8 mm/s (13.11.2026) | Druck 500 mm/s², Ruck 6 mm/s; Fahrt 1000 mm/s² (Marcos Profil)

Sheet: Gewicht
Baugruppe | Masse (g) | Quelle / Annahme
Gedruckte Teile |  | Blatt Druckteile
Servos ST3215 |  | 18 x ca. 55 g (Annahme, bitte wiegen)
Akku 3S 9000 mAh | 600 | Annahme, bitte wiegen
Elektronik (Pi+Hailo+Kühler, Treiber, Kameras, Relais, BMS, DC-DC, MCP23017) | 450 | Annahme
Kabel, Schrauben, Kleinteile | 200 | Annahme
Gesamt |  | Sim rechnet bisher mit 2.580 g
