Hoehlenbaer/SLARC/Drawings/IMX219-83-Stereo-Camera-3D-Drawing/0619.stp

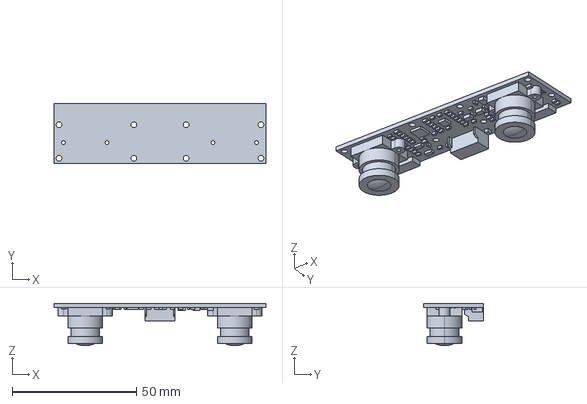
[picture p2: CAD file, 2025-09-16]
Drawings/IMX219-83-Stereo-Camera-3D-Drawing/0619.stp
85.2 x 24.0 x 17.1 mm
