Hoehlenbaer/SLARC/Drawings/Macros/SLARC.FCStd

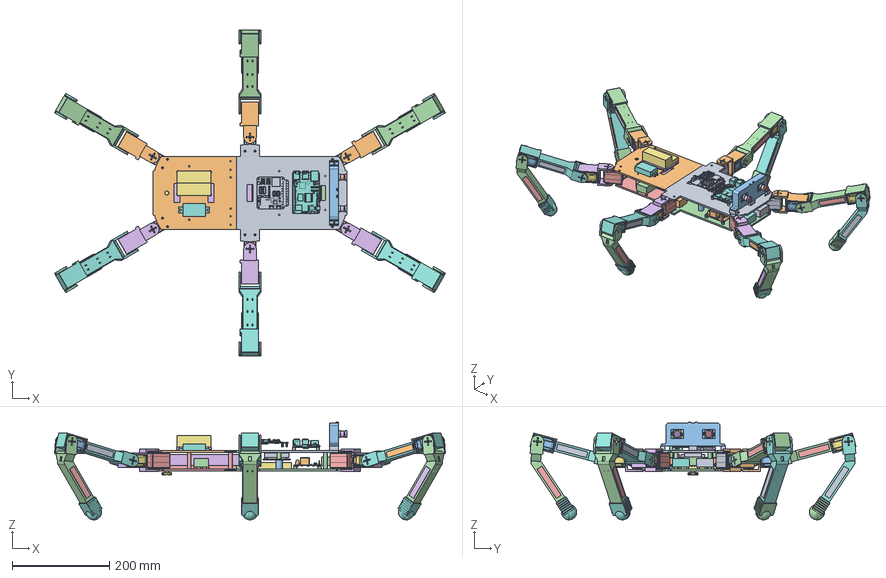
[picture p3: CAD file, 2026-10-26]
Drawings/Macros/SLARC.FCStd
804.4 x 671.0 x 201.2 mm
Baseplate_Top_Front
Baseplate_Top_Rear
Stereo_Mount
Baseplate_Bottom_Front
Baseplate_Bottom_Rear
Battery_3S_9000
BMS_Daly_3S
DCDC_5V_Fulree
Connector_Holder
Button_Bracket
Power_Button
Pi_Sleeve1
Pi_Sleeve2
Pi_Sleeve3
Pi_Sleeve4
PCB_A_FR
PCB_A_FL
PCB_A_MR
PCB_A_ML
PCB_A_RR
PCB_A_RL
Hub_Carrier
PCB_B_Hub
Power_Bridge
PCB_C_Power
Power_Bridge_Sleeve1
Power_Bridge_Sleeve2
PCB_D_Relay_Adapter
Lens_ZH3019_L
Lens_ZH3019_R
Battery_Latch_1
RaspberryPi5
GeneralDriver
Relay8
IMX296_L
IMX296_R
ST3215_Coxa x 3
Coxa_Part x 3
ST3215_Femur x 3
Femur_Part x 3
Deco_Femur_A x 3
Deco_Femur_B x 3
ST3215_Tibia x 3
Tibia_Part x 3
Deco_Tibia_A x 3
Deco_Tibia_B x 3
Microswitch x 3
Foot_TPU x 3
ST3215_Coxa001 x 3
Coxa_Part001 x 3
ST3215_Femur001 x 3
Femur_Part001 x 3
Deco_Femur_A001 x 3
Deco_Femur_B001 x 3
ST3215_Tibia001 x 3
Tibia_Part001 x 3
Deco_Tibia_A001 x 3
Deco_Tibia_B001 x 3
Microswitch001 x 3
Foot_TPU001 x 3
