Hoehlenbaer/SLARC/Drawings/Step files/IMX296 With M12.stp

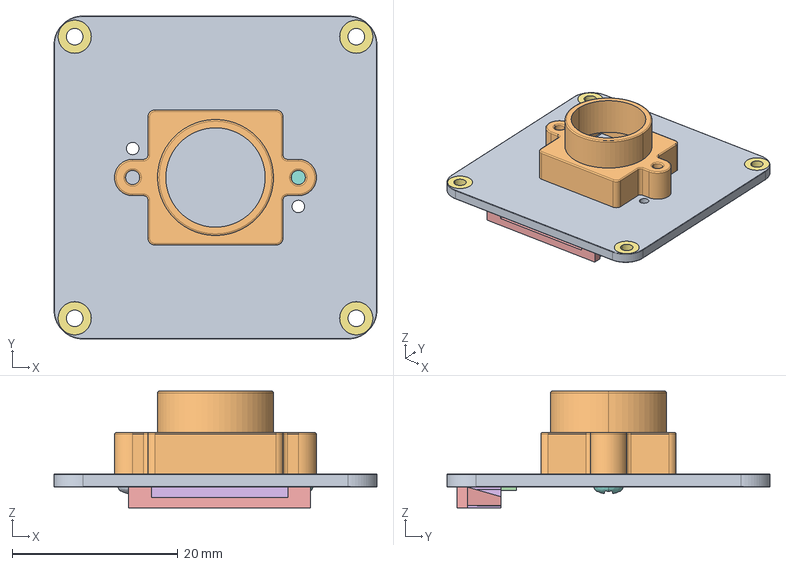
[picture p4: CAD file, 2026-01-20]
Drawings/Step files/IMX296 With M12.stp
39.0 x 39.0 x 14.1 mm
