Hoehlenbaer/SLARC/Drawings/STL files/AKP_SLARC_Leg_Foot.3mf

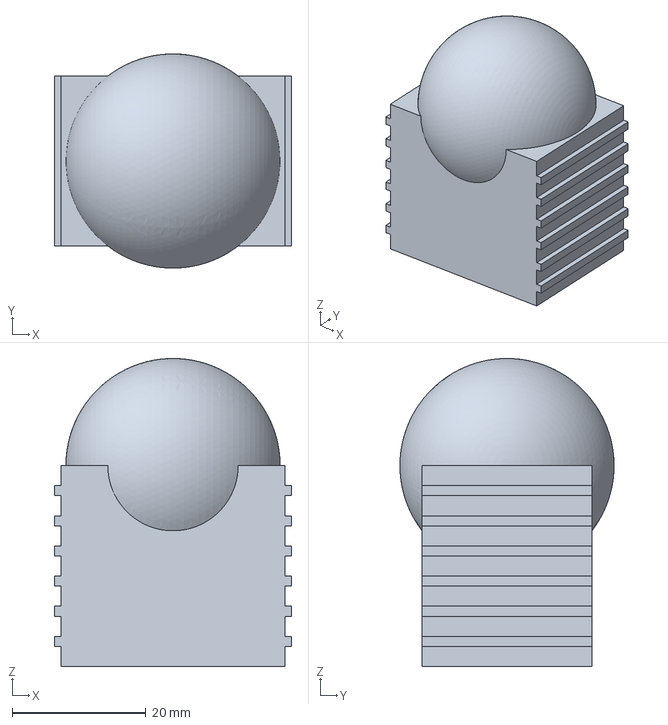
[picture p5: CAD file, 2026-11-14]
Drawings/STL files/AKP_SLARC_Leg_Foot.3mf
35.4 x 32.0 x 46.0 mm
