Hoehlenbaer/SLARC/utilities/Motion_development/slarc_sim/urdf/meshes/coxa_R.stl

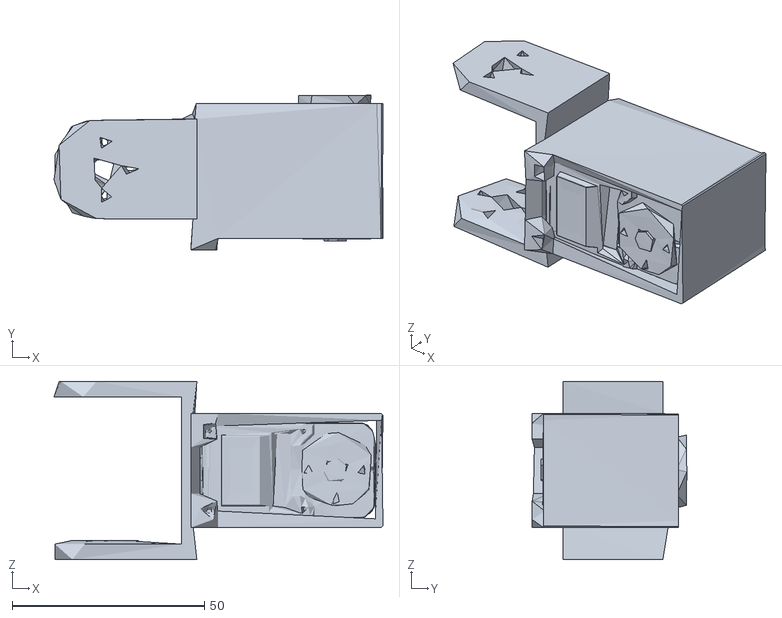
[picture p6: CAD file, 2026-10-24]
utilities/Motion_development/slarc_sim/urdf/meshes/coxa_R.stl
85.5 x 40.2 x 46.3
