Hoehlenbaer/SLARC/Drawings/Macros/ST3215_Dummy.step

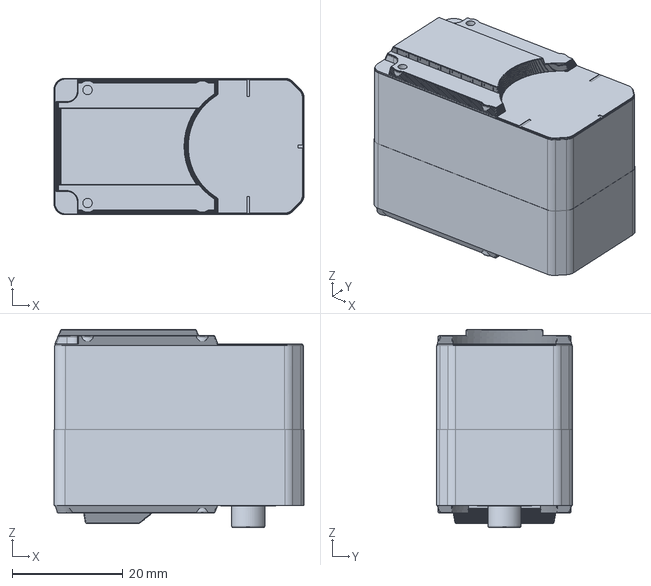
[picture p7: CAD file, 2026-10-24]
Drawings/Macros/ST3215_Dummy.step
45.1 x 24.6 x 35.7 mm
