Hoehlenbaer/SLARC/Drawings/STL files/SLARC_Foot_Fit_Rings.stl

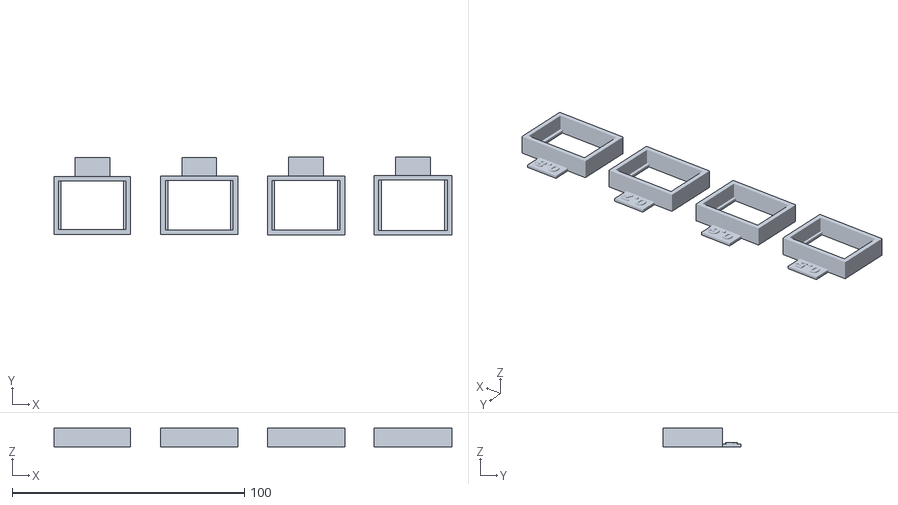
[picture p9: CAD file, 2026-11-13]
Drawings/STL files/SLARC_Foot_Fit_Rings.stl
171.3 x 33.6 x 8.00
