Hoehlenbaer/SLARC/utilities/Motion_development/slarc_sim/urdf/meshes/femur_R.stl

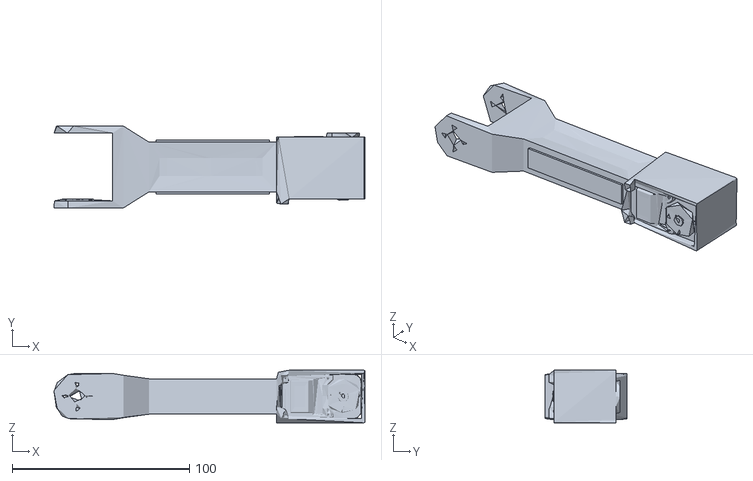
[picture p10: CAD file, 2026-10-24]
utilities/Motion_development/slarc_sim/urdf/meshes/femur_R.stl
175.5 x 46.2 x 29.7
