Hoehlenbaer/SLARC/Drawings/STL files/AKP_SLARC-Baseplate_Bottom_Rear.3mf

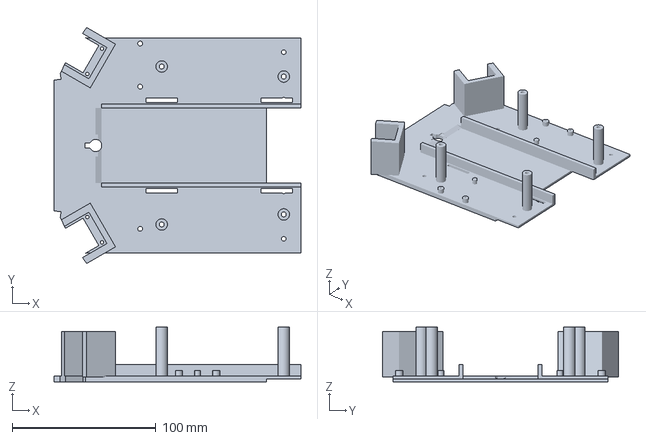
[picture p11: CAD file, 2026-11-13]
Drawings/STL files/AKP_SLARC-Baseplate_Bottom_Rear.3mf
172.0 x 164.4 x 38.1 mm
