Hoehlenbaer/SLARC/utilities/Motion_development/slarc_sim/urdf/meshes/tibia_L.stl

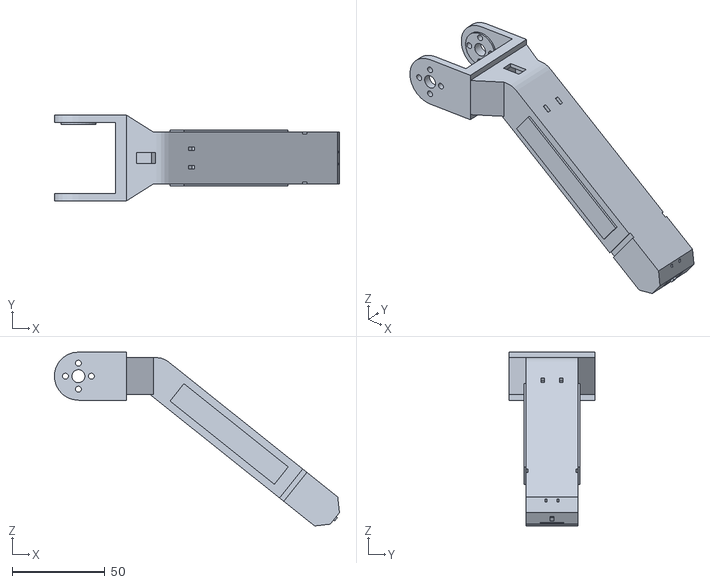
[picture p12: CAD file, 2026-10-24]
utilities/Motion_development/slarc_sim/urdf/meshes/tibia_L.stl
153.8 x 46.2 x 93.8
