Hoehlenbaer/SLARC/Drawings/STL files/AKP_SLARC_Power_Bridge.3mf

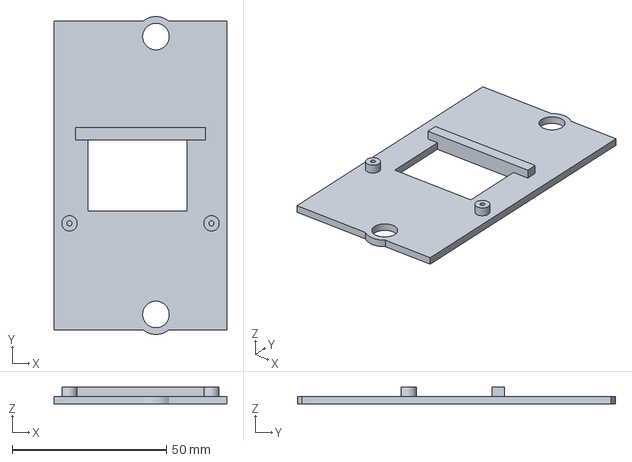
[picture p13: CAD file, 2026-11-13]
Drawings/STL files/AKP_SLARC_Power_Bridge.3mf
56.0 x 103.0 x 5.50 mm
