Hoehlenbaer/SLARC/utilities/Motion_development/slarc_sim/urdf/meshes/foot_L.stl

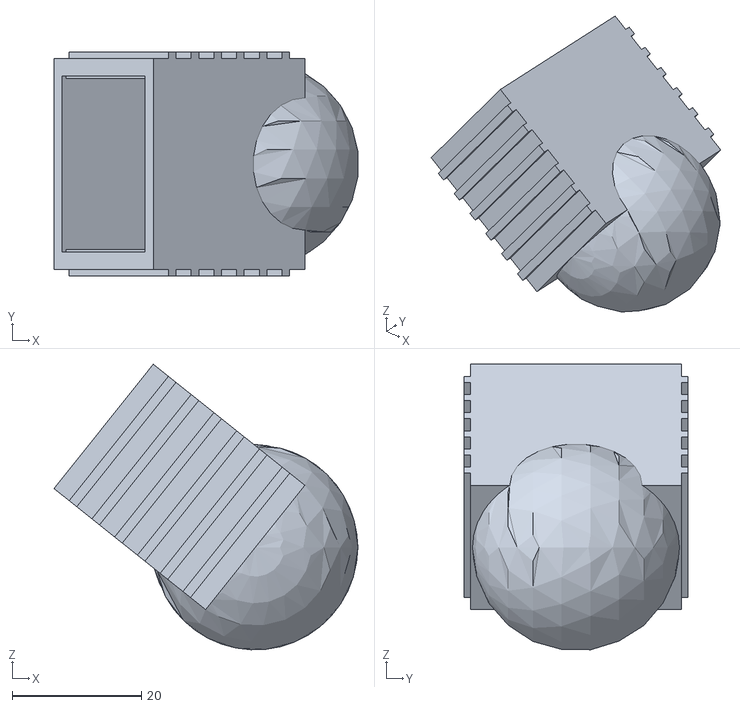
[picture p14: CAD file, 2026-10-24]
utilities/Motion_development/slarc_sim/urdf/meshes/foot_L.stl
47.0 x 34.6 x 44.2
