Hoehlenbaer/SLARC/Drawings/STL files/AKP_SLARC_Battery_Latch_Pin.3mf

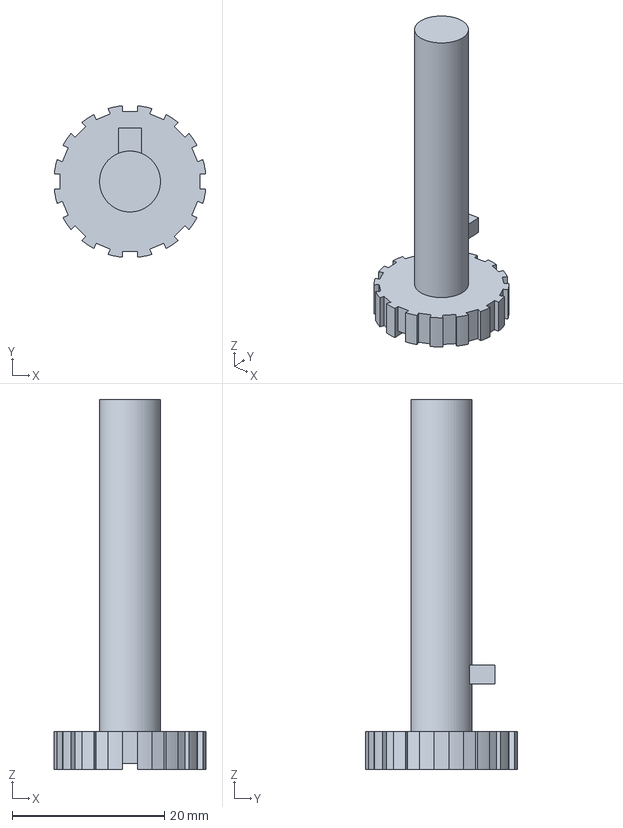
[picture p15: CAD file, 2026-11-13]
Drawings/STL files/AKP_SLARC_Battery_Latch_Pin.3mf
19.9 x 19.9 x 48.6 mm
