Hoehlenbaer/SLARC/utilities/Motion_development/slarc_sim/urdf/meshes/cover_hull.stl

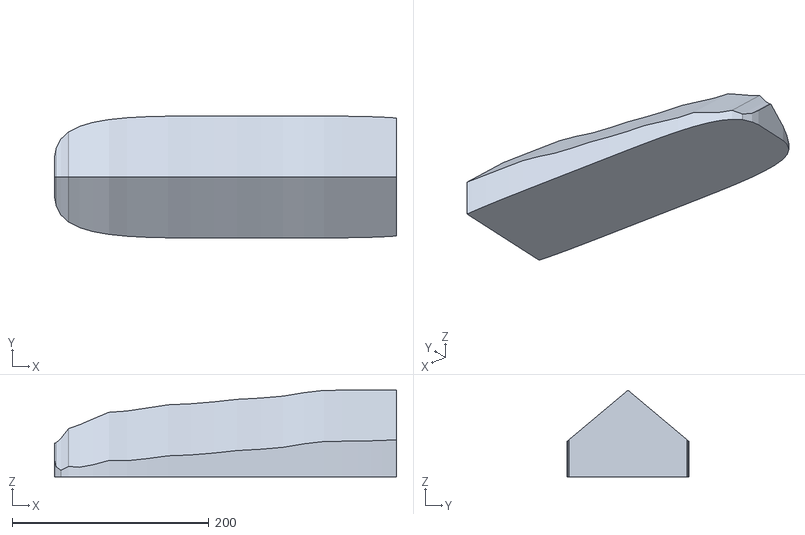
[picture p16: CAD file, 2026-10-24]
utilities/Motion_development/slarc_sim/urdf/meshes/cover_hull.stl
347.5 x 124.0 x 88.0
