Hoehlenbaer/SLARC/Drawings/Macros/General Driver for Robots STEP.step

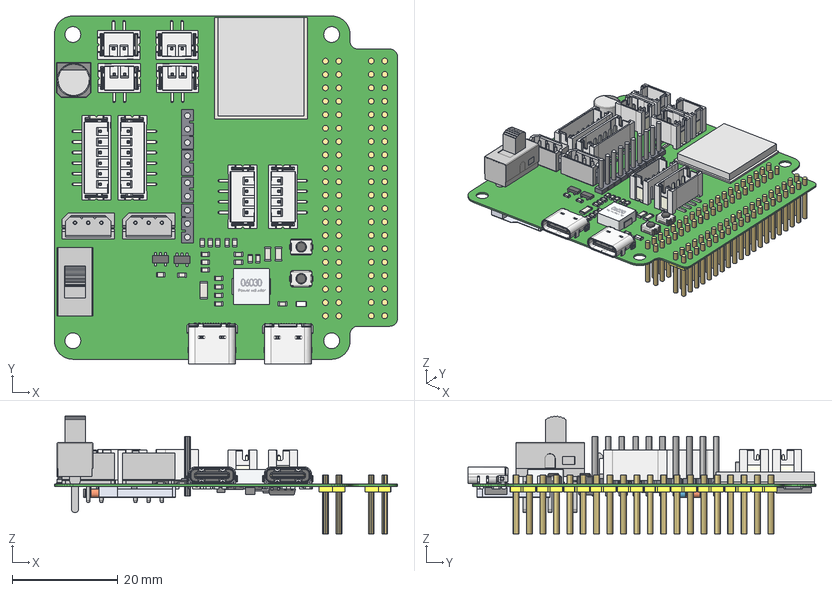
[picture p17: CAD file, 2026-01-10]
Drawings/Macros/General Driver for Robots STEP.step
65.0 x 65.9 x 22.3 mm
Board
Extruded x 118
Extruded (1) x 59
User_Library-DS1066-04-4MSV6 x 2
Extruded (2) x 20
Extruded (3) x 20
Extruded (4) x 80
Extruded (5) x 2
TSSOP14_ËÜÌå
Òý½Å_0.9 x 14
LOGOԲ0.25
Extruded (6)
Extruded (7)
Extruded (8)
Extruded (9) x 2
Extruded (10) x 4
Extruded (11) x 56
Extruded (12) x 27
Extruded (13) x 4
Extruded (14) x 7
Extruded (15)
User_Library-DS1066-04-2MSV6 x 4
Extruded (16) x 2
Extruded (17)
Extruded (18) x 8
Extruded (19) x 4
Extruded (20)
Extruded (21) x 6
Extruded (22) x 3
Extruded (23) x 4
Extruded (24) x 2
Extruded (25) x 4
Extruded (26) x 2
Extruded (27) x 6
Extruded (28) x 3
Cap,_elec,_6.3x4.2
Cap,_elec,_6.3x4.2 (1)
Cap,_elec,_6.3x4.2 (2)
Extruded (29)
User_Library-DS1066-04-6MSV6 x 2
X2564WV-03-N0SN x 2
User_Library-06030
Extruded (30)
Extruded (31)
Extruded (32)
Extruded (33)
User_Library-sop-8
Extruded (34)
Extruded (35)
Extruded (36) x 6
Extruded (37) x 2
Extruded (38) x 9
Extruded (39) x 3
SMT_Tactile_Switch_PTS-820 x 2
Extruded (40)
Extruded (41) x 24
Extruded (42) x 10
Extruded (43) x 2
Extruded (44)
Extruded (45)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
