Hoehlenbaer/SLARC/Drawings/STL files/AKP_SLARC_Pi_Sleeve.3mf

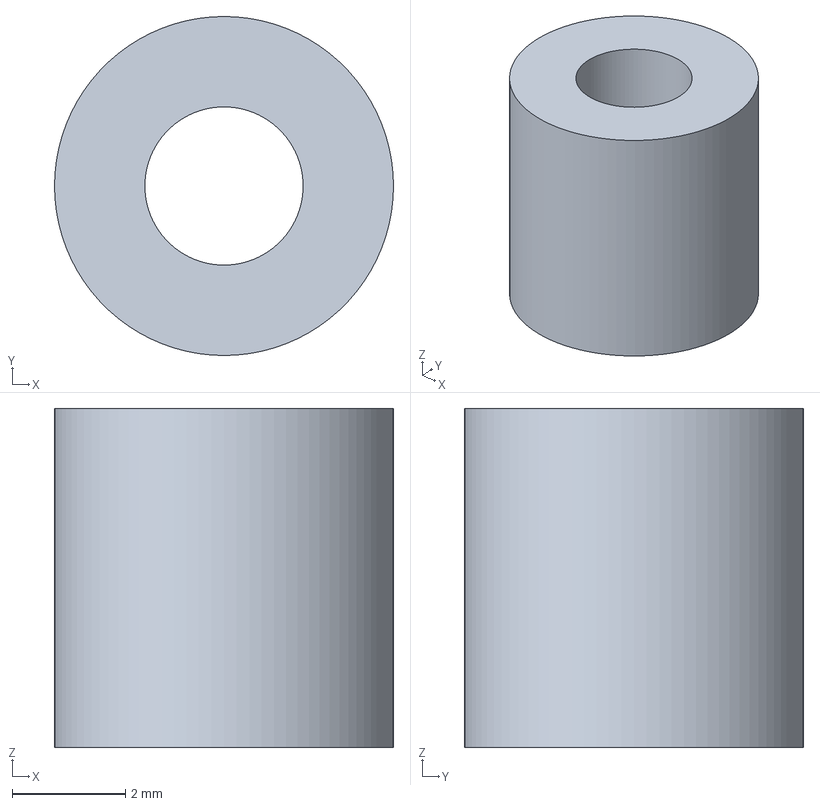
[picture p18: CAD file, 2026-11-13]
Drawings/STL files/AKP_SLARC_Pi_Sleeve.3mf
6.00 x 6.00 x 6.00 mm
