Hoehlenbaer/SLARC/Drawings/STL files/AKP_SLARC_Leg_Tibia.3mf

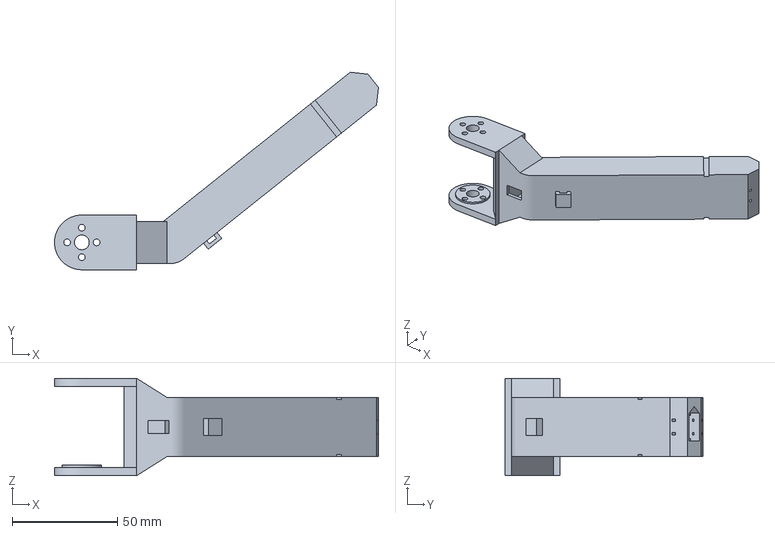
[picture p19: CAD file, 2026-11-13]
Drawings/STL files/AKP_SLARC_Leg_Tibia.3mf
153.9 x 93.8 x 46.2 mm
