Hoehlenbaer/SLARC/Drawings/STL files/AKP_SLARC-Baseplate_Top_Rear.3mf

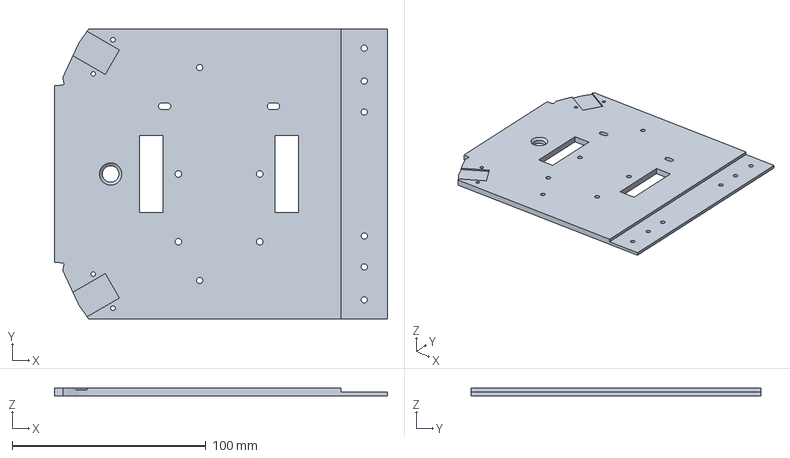
[picture p20: CAD file, 2026-11-13]
Drawings/STL files/AKP_SLARC-Baseplate_Top_Rear.3mf
172.0 x 150.0 x 4.00 mm
