Hoehlenbaer/SLARC/Drawings/STL files/AKP_SLARC-Baseplate_Top_Front.3mf

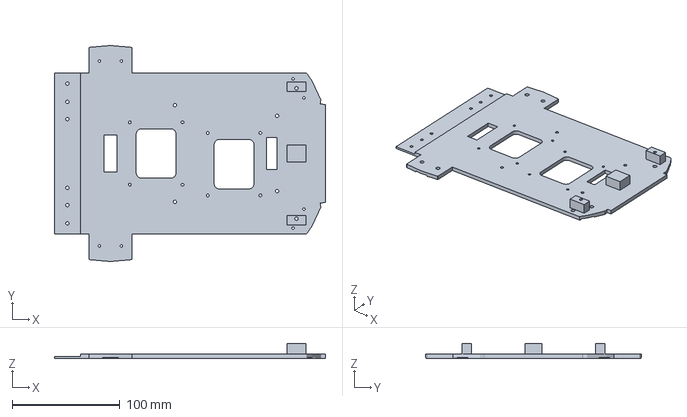
[picture p21: CAD file, 2026-11-13]
Drawings/STL files/AKP_SLARC-Baseplate_Top_Front.3mf
252.0 x 200.9 x 14.0 mm
