Hoehlenbaer/SLARC/Drawings/STL files/AKP_SLARC_Leg_Coxa.3mf

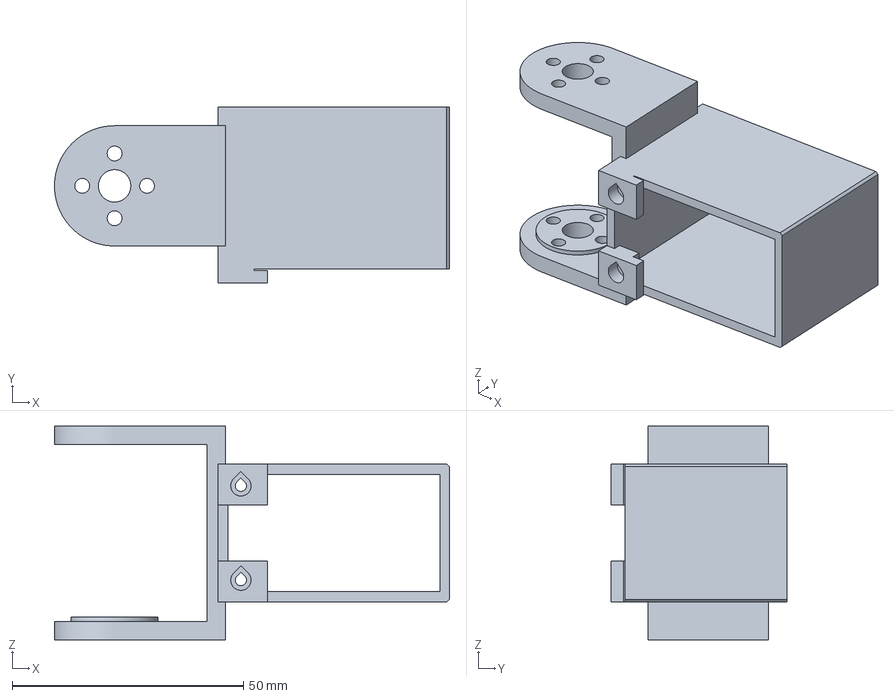
[picture p22: CAD file, 2026-11-13]
Drawings/STL files/AKP_SLARC_Leg_Coxa.3mf
85.4 x 38.0 x 46.2 mm
