Hoehlenbaer/SLARC/Drawings/STL files/AKP_SLARC_Leg_Femur.3mf

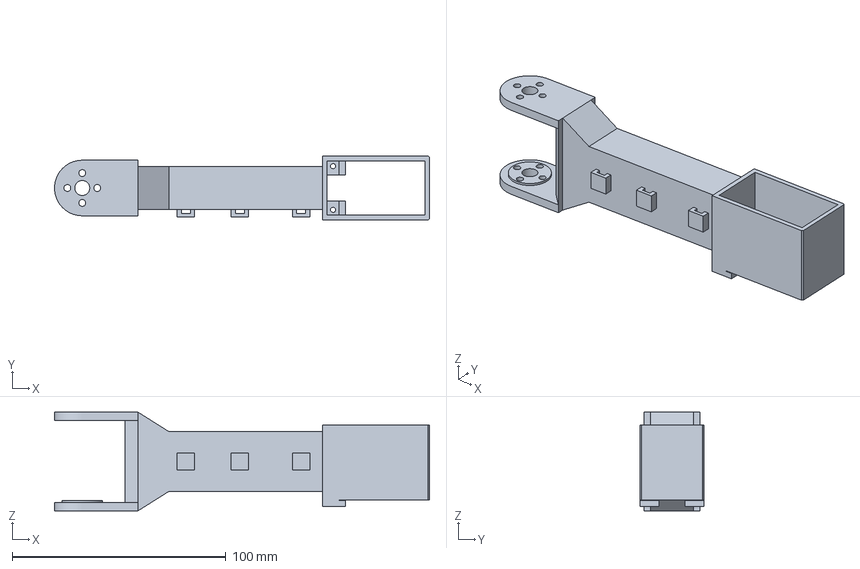
[picture p23: CAD file, 2026-11-13]
Drawings/STL files/AKP_SLARC_Leg_Femur.3mf
175.4 x 29.8 x 46.2 mm
