Hoehlenbaer/SLARC/Drawings/STL files/AKP_SLARC_Power_Bridge_Sleeve.3mf

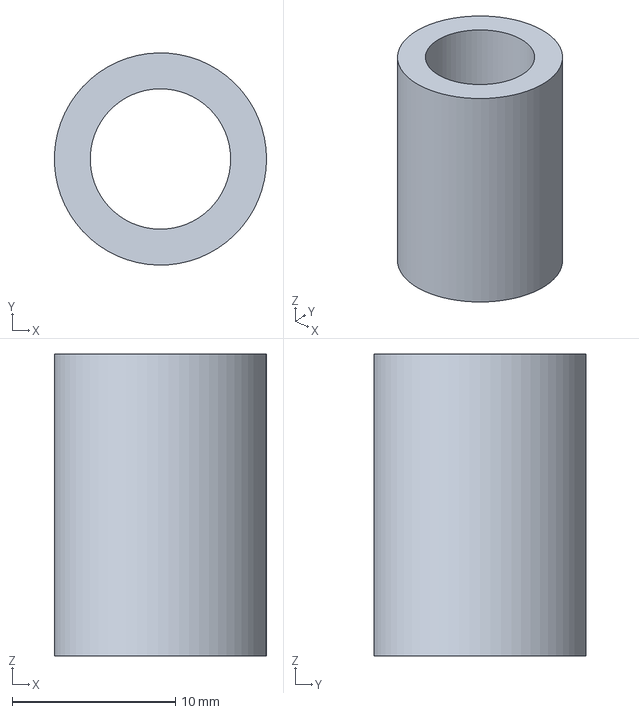
[picture p24: CAD file, 2026-11-13]
Drawings/STL files/AKP_SLARC_Power_Bridge_Sleeve.3mf
13.0 x 13.0 x 18.5 mm
