Hoehlenbaer/SLARC/Drawings/STL files/AKP_SLARC_Connector_Holder.3mf

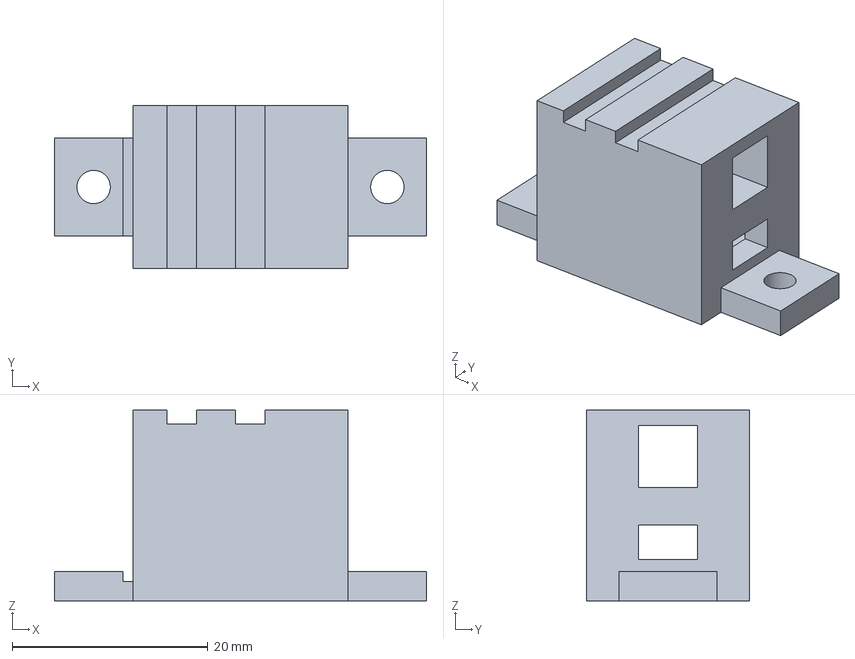
[picture p25: CAD file, 2026-11-13]
Drawings/STL files/AKP_SLARC_Connector_Holder.3mf
38.0 x 16.7 x 19.5 mm
