Hoehlenbaer/SLARC/Drawings/STL files/AKP_SLARC_Button_Bracket.3mf

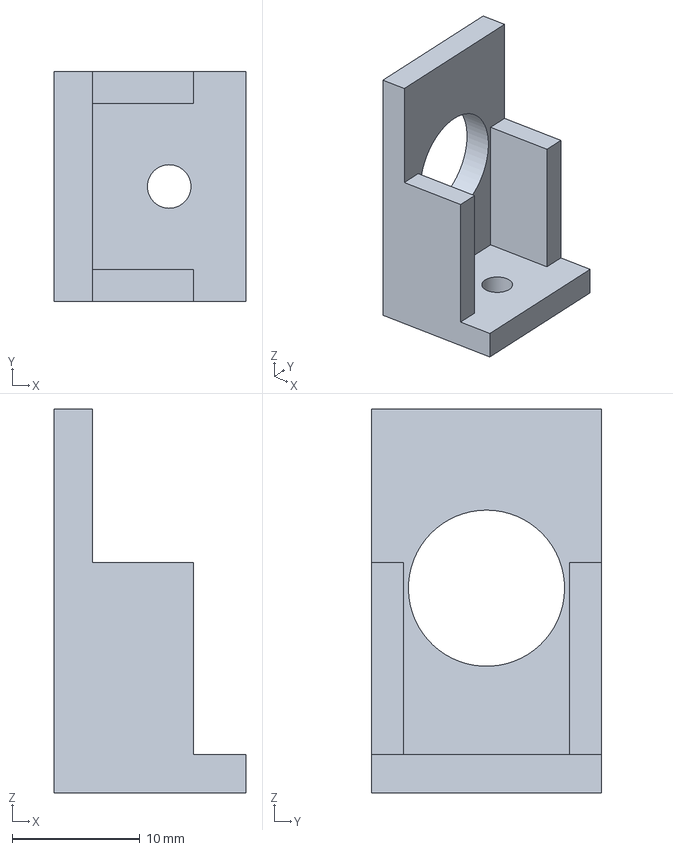
[picture p26: CAD file, 2026-11-13]
Drawings/STL files/AKP_SLARC_Button_Bracket.3mf
15.0 x 18.0 x 30.0 mm
