Hoehlenbaer/SLARC/Drawings/STL files/AKP_SLARC_Bench_Board.3mf

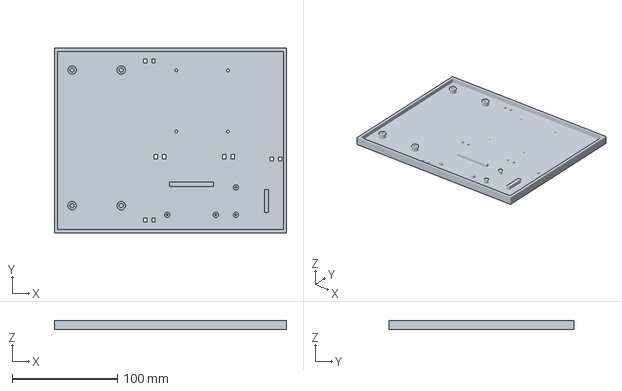
[picture p27: CAD file, 2026-11-13]
Drawings/STL files/AKP_SLARC_Bench_Board.3mf
220.0 x 175.0 x 9.00 mm
