Hoehlenbaer/SLARC/Drawings/STL files/AKP_SLARC_Leg_Test_Stand_Cap.3mf

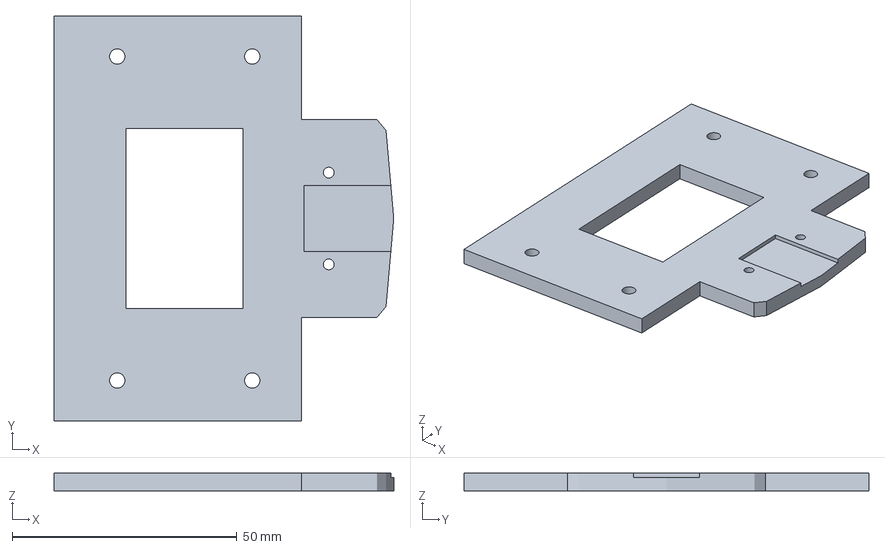
[picture p28: CAD file, 2026-11-13]
Drawings/STL files/AKP_SLARC_Leg_Test_Stand_Cap.3mf
75.4 x 90.0 x 4.00 mm
