Hoehlenbaer/SLARC/Drawings/STL files/AKP_SLARC_Leg_Deco_Tibia.3mf

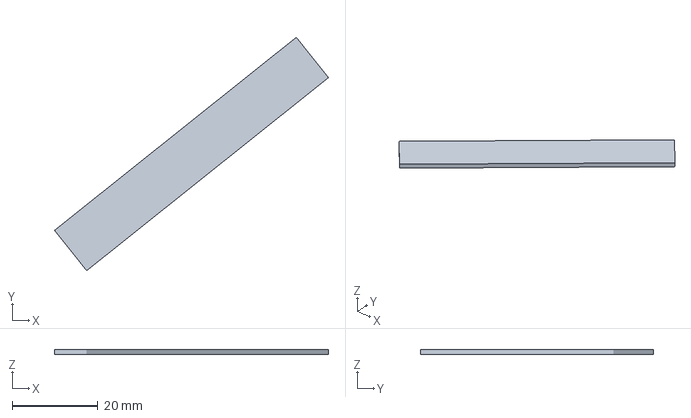
[picture p29: CAD file, 2026-11-13]
Drawings/STL files/AKP_SLARC_Leg_Deco_Tibia.3mf
63.8 x 54.3 x 1.20 mm
