Hoehlenbaer/SLARC/Drawings/STL files/AKP_SLARC_Foot_Fit_Rings.3mf

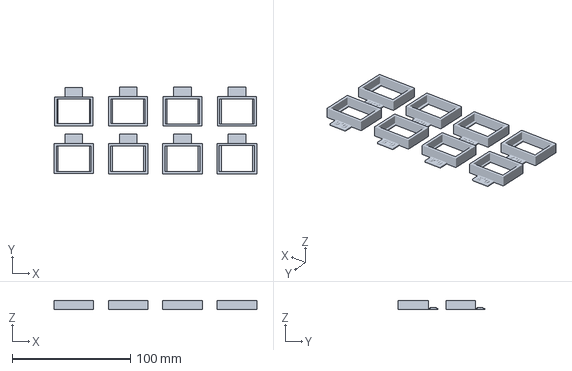
[picture p30: CAD file, 2026-11-13]
Drawings/STL files/AKP_SLARC_Foot_Fit_Rings.3mf
171.7 x 73.6 x 8.00 mm
