Hoehlenbaer/SLARC/Drawings/STL files/AKP_SLARC_Hub_Carrier.3mf

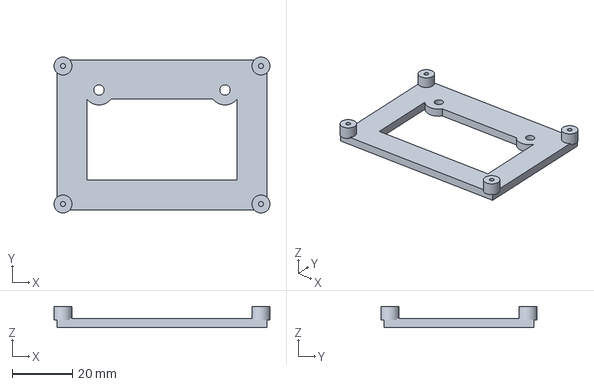
[picture p31: CAD file, 2026-11-13]
Drawings/STL files/AKP_SLARC_Hub_Carrier.3mf
72.0 x 52.0 x 7.00 mm
