Hoehlenbaer/SLARC/Drawings/STL files/AKP_SLARC-Stereo_Mount.3mf

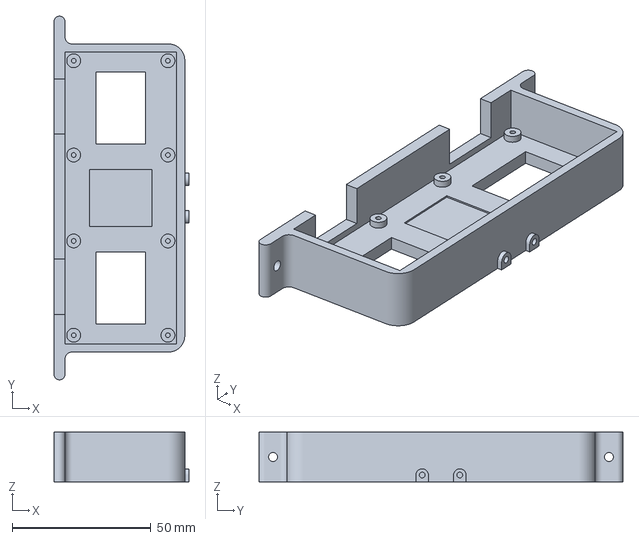
[picture p32: CAD file, 2026-11-13]
Drawings/STL files/AKP_SLARC-Stereo_Mount.3mf
48.7 x 131.2 x 18.0 mm
