Hoehlenbaer/SLARC/Drawings/STL files/AKP_SLARC_Bench_Adapter_PowerC.3mf

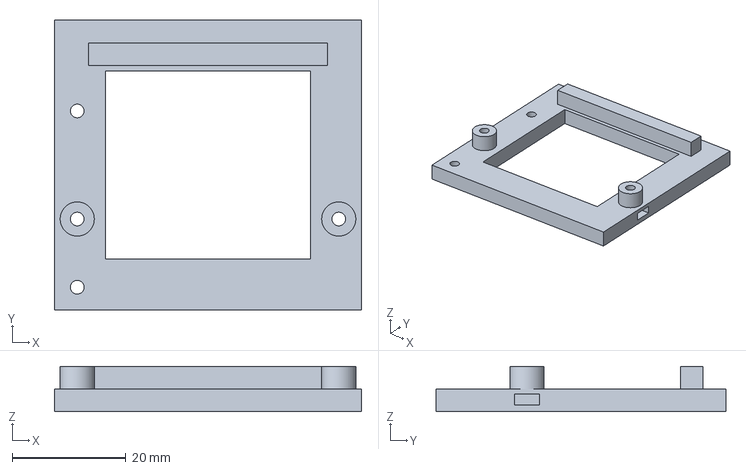
[picture p33: CAD file, 2026-11-13]
Drawings/STL files/AKP_SLARC_Bench_Adapter_PowerC.3mf
54.0 x 51.0 x 8.00 mm
