Hoehlenbaer/SLARC/Drawings/STL files/SLARC_Leg_Foot.stl

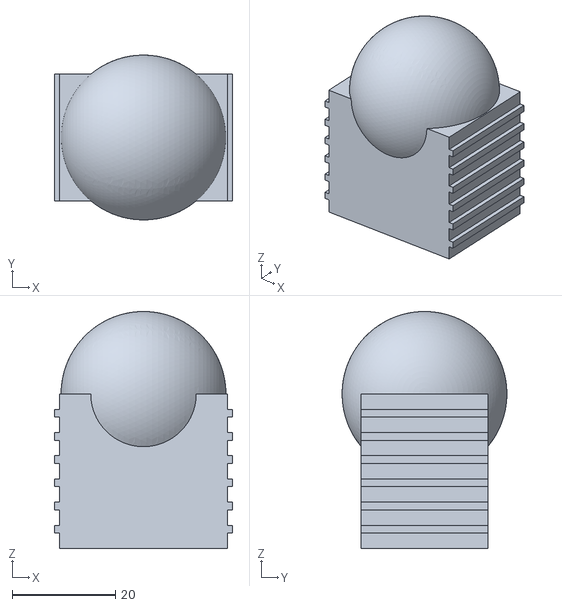
[picture p34: CAD file, 2026-11-11]
Drawings/STL files/SLARC_Leg_Foot.stl
34.6 x 32.0 x 46.0
