Hoehlenbaer/SLARC/Drawings/STL files/SLARC-Baseplate_Bottom_Front.stl

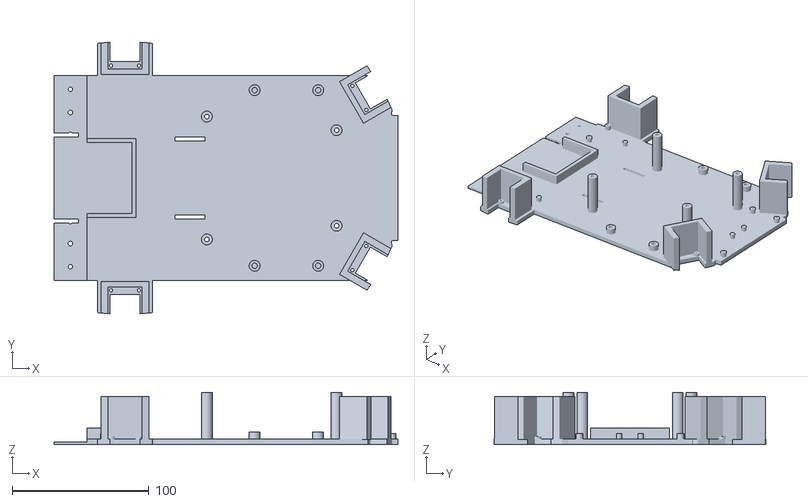
[picture p35: CAD file, 2026-11-10]
Drawings/STL files/SLARC-Baseplate_Bottom_Front.stl
252.0 x 199.0 x 38.1
