Hoehlenbaer/SLARC/Drawings/STL files/SLARC_Bench_Adapter_Relay.stl

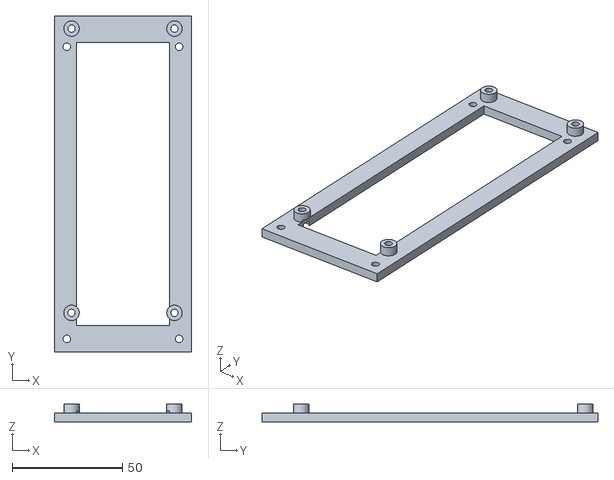
[picture p36: CAD file, 2026-11-08]
Drawings/STL files/SLARC_Bench_Adapter_Relay.stl
62.0 x 152.0 x 8.00
