Hoehlenbaer/SLARC/Drawings/STL files/AKP_SLARC_Leg_Deco_Femur.3mf

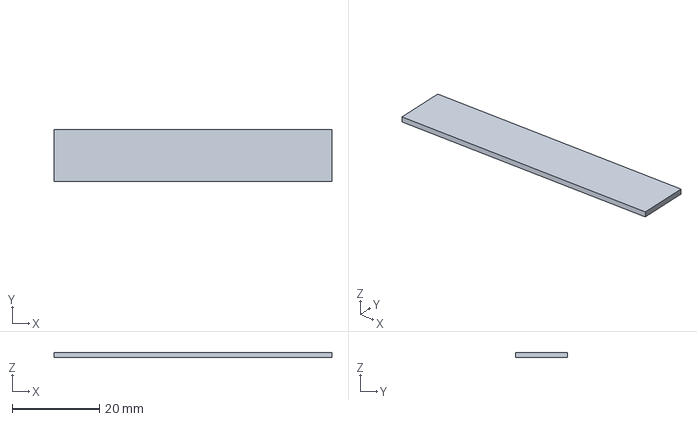
[picture p37: CAD file, 2026-11-05]
Drawings/STL files/AKP_SLARC_Leg_Deco_Femur.3mf
63.9 x 12.0 x 1.20 mm
