Hoehlenbaer/SLARC/Drawings/STL files/AKP_SLARC_Leg_Test_Stand_Base.3mf

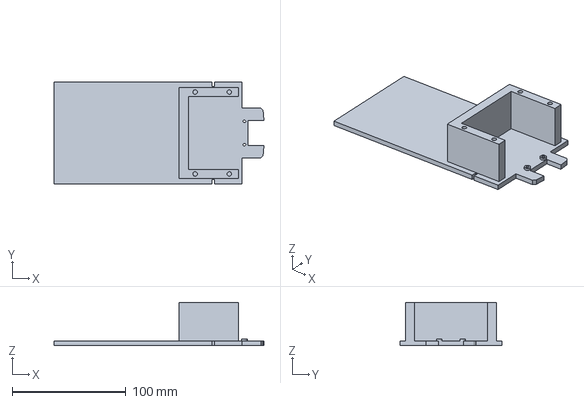
[picture p38: CAD file, 2026-11-01]
Drawings/STL files/AKP_SLARC_Leg_Test_Stand_Base.3mf
184.5 x 90.0 x 38.1 mm
