Hoehlenbaer/SLARC/Drawings/STL files/SLARC_Leg-LegFoot_TPU.stl

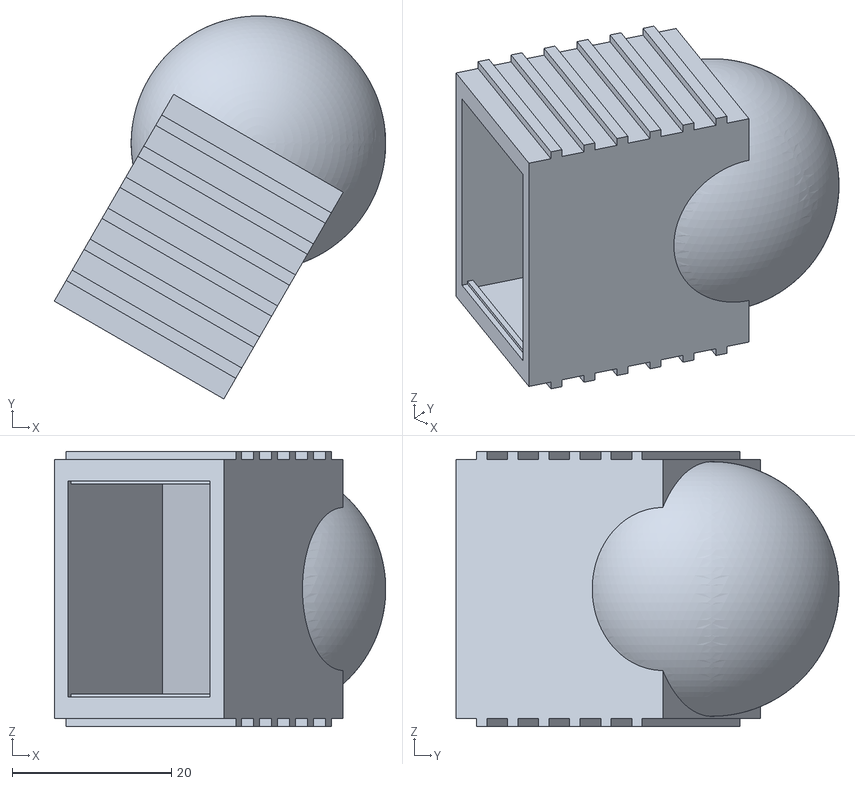
[picture p39: CAD file, 2026-10-23]
Drawings/STL files/SLARC_Leg-LegFoot_TPU.stl
41.6 x 48.1 x 34.6
