Hoehlenbaer/SLARC/(list of files, cad)

Other CAD files:
Drawings/Macros/raspberry_pi_5.stp
Drawings/Macros/IMX296 With M12.stp
Drawings/Macros/Relay Module - 8 Channel.STEP
Drawings/STL files/SLARC_Leg_Tibia.stl
Drawings/STL files/AKP_SLARC-Baseplate_Bottom_Front.3mf
Drawings/STL files/SLARC-Baseplate_Top_Front.stl
Drawings/STL files/SLARC_Leg_Femur.stl
Drawings/STL files/SLARC_Power_Bridge.stl
Drawings/STL files/SLARC_Bench_Adapter_PowerC.stl
Drawings/STL files/SLARC_Bench_Board.stl
Drawings/STL files/SLARC_Leg_Coxa.stl
Drawings/STL files/SLARC_Leg_Test_Stand_Cap.stl
Drawings/STL files/SLARC_Power_Bridge_Sleeve.stl
Drawings/STL files/SLARC-Stereo_Mount.stl
Drawings/STL files/ST3215_Dummy.stl
Drawings/STL files/SLARC_Connector_Holder.stl
Drawings/STL files/temp.FCStd
