Hoehlenbaer/SLARC/Documentation/Setup HW trigger.txt

sudo su
echo 1 > /sys/module/imx296/parameters/trigger_mode

#60 Hz, 2ms
echo 0 | sudo tee /sys/class/pwm/pwmchip0/unexport
echo 0 | sudo tee /sys/class/pwm/pwmchip0/export
echo 16666666 | sudo tee /sys/class/pwm/pwmchip0/pwm0/period
echo 14666666 | sudo tee /sys/class/pwm/pwmchip0/pwm0/duty_cycle
echo 1 | sudo tee /sys/class/pwm/pwmchip0/pwm0/enable

#50 Hz, 2ms
echo 0 | sudo tee /sys/class/pwm/pwmchip0/unexport
echo 0 | sudo tee /sys/class/pwm/pwmchip0/export
echo 20000000 | sudo tee /sys/class/pwm/pwmchip0/pwm0/period
echo 18000000 | sudo tee /sys/class/pwm/pwmchip0/pwm0/duty_cycle
echo 1 | sudo tee /sys/class/pwm/pwmchip0/pwm0/enable

#40 Hz, 2ms
echo 0 | sudo tee /sys/class/pwm/pwmchip0/unexport
echo 0 | sudo tee /sys/class/pwm/pwmchip0/export
echo 25000000 | sudo tee /sys/class/pwm/pwmchip0/pwm0/period
echo 23000000 | sudo tee /sys/class/pwm/pwmchip0/pwm0/duty_cycle
echo 1 | sudo tee /sys/class/pwm/pwmchip0/pwm0/enable

#30 Hz, 2ms
echo 0 | sudo tee /sys/class/pwm/pwmchip0/unexport
echo 0 | sudo tee /sys/class/pwm/pwmchip0/export
echo 33333333 | sudo tee /sys/class/pwm/pwmchip0/pwm0/period
echo 31333333 | sudo tee /sys/class/pwm/pwmchip0/pwm0/duty_cycle
echo 1 | sudo tee /sys/class/pwm/pwmchip0/pwm0/enable

#60 Hz, 8ms
echo 0 | sudo tee /sys/class/pwm/pwmchip0/unexport
echo 0 | sudo tee /sys/class/pwm/pwmchip0/export
echo 16666666 | sudo tee /sys/class/pwm/pwmchip0/pwm0/period
echo 8666666 | sudo tee /sys/class/pwm/pwmchip0/pwm0/duty_cycle
echo 1 | sudo tee /sys/class/pwm/pwmchip0/pwm0/enable

#60 Hz, 10ms
echo 0 | sudo tee /sys/class/pwm/pwmchip0/unexport
echo 0 | sudo tee /sys/class/pwm/pwmchip0/export
echo 16666666 | sudo tee /sys/class/pwm/pwmchip0/pwm0/period
echo 6666666 | sudo tee /sys/class/pwm/pwmchip0/pwm0/duty_cycle
echo 1 | sudo tee /sys/class/pwm/pwmchip0/pwm0/enable

#40 Hz, 10ms
echo 0 | sudo tee /sys/class/pwm/pwmchip0/unexport
echo 0 | sudo tee /sys/class/pwm/pwmchip0/export
echo 25000000 | sudo tee /sys/class/pwm/pwmchip0/pwm0/period
echo 15000000 | sudo tee /sys/class/pwm/pwmchip0/pwm0/duty_cycle
echo 1 | sudo tee /sys/class/pwm/pwmchip0/pwm0/enable

#run camera
rpicam-hello --cam 0 --timeout 30000 --gain 15.0 --shutter 2000 --metering centre
