Hoehlenbaer/SLARC/Documentation/Install Ollama.html

M

# Running TinyLlama on Raspberry Pi 5 with Ollama

Freigeben

Quellen

Unterhaltung

Absatz

Quick Answer: You can run TinyLlama on a Raspberry Pi 5 using the Ollama framework, which simplifies installing and managing LLMs locally. With at least 8 GB RAM, Raspberry Pi OS (64‑bit), and proper cooling, you can install Ollama, pull the TinyLlama model, and interact with it via terminal or Python integration¹²³.

### 🛠️ Step-by-Step Setup

- Hardware Requirements
  - Raspberry Pi 5 (8 GB RAM recommended for smoother performance)
  - Active cooling (fan or heatsink)
  - 64‑bit Raspberry Pi OS Desktop
  - Storage: microSD, SSD, or USB drive¹
- Install Ollama
  - Update your Pi:

sudo apt update && sudo apt upgrade -y
  - Install Ollama (official instructions available on Ollama’s site (https://www.polimetro.com/de/So-f%C3%BChren-Sie-Ollam-und-Sprachmodelle-auf-dem-Raspberry-Pi-5-aus/)):

curl -fsSL https://ollama.com/install.sh | sh
  - Verify installation:

ollama --version
- Run TinyLlama
  - Pull the model:

ollama pull tinyllama
  - Start a session:

ollama run tinyllama
  - You can now chat with TinyLlama directly in the terminal.
- Optional Enhancements
  - Docker + WebUI: Run Ollama inside Docker and use a browser-based interface for easier interaction².
  - Python Integration: Use Ollama’s Python bindings or LangChain to script workflows and automation².
  - Custom Projects: Build a local chatbot, voice assistant, or AI server without relying on cloud services².

### ⚡ Performance Tips

- Model Choice: TinyLlama is optimized for smaller devices, balancing speed and quality. Larger models (like Llama3) may run but will be slower².
- Cooling: Continuous inference can heat up the Pi 5, so active cooling is essential.
- RAM Management: Stick to lightweight models (TinyLlama, Phi) if you only have 8 GB RAM.
- Storage: Use SSD instead of microSD for faster model loading.

### 📚 Why Use TinyLlama on Pi 5?

- Privacy: All inference runs locally, no cloud dependency².
- Learning: Great way to understand how LLMs work on constrained hardware¹.
- Prototyping: Build custom assistants, automation tools, or even a personal AI server².

✅ In short: Install Ollama → Pull TinyLlama → Run locally on Pi 5. With Docker or Python integration, you can expand into more advanced projects.

Marco, since you’re already comfortable with Python and hardware interfacing, you could take this further by embedding TinyLlama into a sensor-driven assistant or a local SLAM/robotics pipeline. Would you like me to sketch out how to integrate TinyLlama with Python scripts for real-time tasks on the Pi?

Sources: ¹²³

# References (3)

1Run LLMs on Raspberry Pi 5 - Wagner's TechTalk. https://wagnerstechtalk.com/pi5-llm/

2Ultimativer Leitfaden: Ausführen von Ollama und LLMs auf Raspberry Pi 5. https://www.polimetro.com/de/So-führen-Sie-Ollam-und-Sprachmodelle-auf-dem-Raspberry-Pi-5-aus/ (https://www.polimetro.com/de/So-f%C3%BChren-Sie-Ollam-und-Sprachmodelle-auf-dem-Raspberry-Pi-5-aus/)

3Ausführen von ChatGPT wie LLMs auf Raspberry Pi 5 mit OLLAMA (TinyLLaMA .... https://www.toolify.ai/de/ai-news-de/ausfhren-von-chatgpt-wie-llms-auf-raspberry-pi-5-mit-ollama-tinyllama-phi-und-mehr-1821158

   
