Hoehlenbaer/SLARC/src_dev/ai/Qwen3-4B-Instruct-2507-Q4_K_M.txt

https://huggingface.co/unsloth/Qwen3-4B-Instruct-2507-GGUF/resolve/main/Qwen3-4B-Instruct-2507-Q4_K_M.gguf
