Hoehlenbaer/SLARC/Documentation/How to create SLARC-brain model.odt

Gerne zeige ich Ihnen die notwendigen Schritte, um Ihr Modell unter dem neuen Namen SLARC-brain zu erstellen.

Dieser Prozess importiert Ihre heruntergeladene .gguf-Datei und speichert alle definierten Regeln (System Prompt, Performance-Optimierungen) dauerhaft unter dem neuen Tag.

🛠️ Schritte zur Erstellung des Modells SLARC-brain

Stellen Sie sicher, dass Sie die Ollama-Version auf dem Zielsystem (RPi5) aktualisiert haben, damit der keep_alive-Parameter fehlerfrei unterstützt wird.

1. Komponenten vorbereiten

Sie benötigen zwei Dateien im selben Ordner auf Ihrem System:

1. Ihre GGUF-Datei: (z.B. Llama-3.2-3B-Instruct-Q5_K_M.gguf).
2. Ihre Modelfile: (eine Textdatei ohne Dateiendung).

📄 Inhalt der Modelfile (Finaler Zustand)

Passen Sie den Pfad und den Modellnamen an Ihre Datei an. Beachten Sie, dass der SYSTEM-Prompt den gesamten Regeltext enthalten muss.

Dockerfile

FROM ./Llama-3.2-3B-Instruct-Q5_K_M.gguf

# Der vollständige, lange System-Prompt für die Logik
SYSTEM """
Du bist die autonome Planungs- und Entscheidungszentrale...
[... Füge hier den kompletten, finalen System-Prompt ein ...]
"""

# Performance-Parameter:
PARAMETER temperature 0.0
PARAMETER keep_alive -1
PARAMETER num_predict 100

2. Modell erstellen

Öffnen Sie das Terminal (PowerShell unter Windows oder Terminal auf dem RPi) und führen Sie die folgenden Befehle aus:

A. In den Ordner navigieren

Wechseln Sie in das Verzeichnis, in dem sich die beiden Dateien (.gguf und Modelfile) befinden.

Bash

cd /pfad/zum/Modellordner/

B. Erstellung befehlen

Verwenden Sie den ollama create-Befehl und geben Sie Ihren neuen Tag (SLARC-brain) an.

Bash

ollama create SLARC-brain -f Modelfile

Ollama führt nun die folgenden Aktionen durch:

1. Es liest die Modelfile.
2. Es importiert die GGUF-Datei.
3. Es speichert alle SYSTEM- und PARAMETER-Anweisungen dauerhaft unter dem Tag SLARC-brain.

3. Testen im Python-Code

Nach erfolgreicher Erstellung können Sie Ihr Modell sofort in Ihrem Python-Skript verwenden, indem Sie den Tag auf den neuen Namen ändern:

Python

# Im Python-Skript
MODEL_TAG = 'SLARC-brain'

# ... in der Funktion get_decision ...
response = ollama.chat(
model=MODEL_TAG, # <--- Jetzt SLARC-brain
format='json',
messages=[{'role': 'user', 'content': user_input}]
)
