Hoehlenbaer/SLARC/Documentation/Models/FusedHexapodModel/HEF-benchmark.txt

V4.0 baseline
============================================================
📈 3-HEF PIPELINE ERGEBNISSE
============================================================

Schritt         |   Median |     Mean |      Min |      Max
------------------------------------------------------------
Backbone(L)     |   13.45ms |   13.47ms |   13.43ms |   14.06ms
Backbone(R)     |   10.05ms |   10.08ms |    9.94ms |   10.53ms
Geometry        |   21.83ms |   21.83ms |   21.61ms |   22.21ms
Detection       |   10.62ms |   10.63ms |   10.57ms |   10.94ms
------------------------------------------------------------
TOTAL           |   55.98ms |   56.02ms |   55.69ms |   56.84ms

🎯 Pipeline FPS: 17.9 FPS (Median)

V5.0 corr wide
============================================================
📈 3-HEF PIPELINE ERGEBNISSE
============================================================

Schritt         |   Median |     Mean |      Min |      Max
------------------------------------------------------------
Backbone(L)     |   14.14ms |   14.19ms |   14.11ms |   15.75ms
Backbone(R)     |   10.05ms |   10.21ms |    9.94ms |   13.56ms
Geometry        |   28.00ms |   28.02ms |   27.17ms |   34.06ms
Detection       |   15.01ms |   15.10ms |   14.58ms |   15.87ms
------------------------------------------------------------
TOTAL           |   67.26ms |   67.52ms |   66.58ms |   74.55ms

🎯 Pipeline FPS: 14.9 FPS (Median)

V5.0 corr moderate
============================================================
📈 3-HEF PIPELINE ERGEBNISSE
============================================================

Schritt         |   Median |     Mean |      Min |      Max
------------------------------------------------------------
Backbone(L)     |   14.00ms |   14.02ms |   13.98ms |   14.30ms
Backbone(R)     |    9.61ms |    9.66ms |    9.49ms |   10.19ms
Geometry        |   22.33ms |   22.37ms |   22.12ms |   23.37ms
Detection       |   11.02ms |   11.04ms |   10.79ms |   12.03ms
------------------------------------------------------------
TOTAL           |   56.98ms |   57.09ms |   56.55ms |   58.33ms

🎯 Pipeline FPS: 17.5 FPS (Median)

V5.0 cv wide
============================================================
📈 3-HEF PIPELINE ERGEBNISSE
============================================================

Schritt         |   Median |     Mean |      Min |      Max
------------------------------------------------------------
Backbone(L)     |   14.14ms |   14.17ms |   14.09ms |   14.93ms
Backbone(R)     |   10.02ms |   10.16ms |    9.90ms |   13.70ms
Geometry        |   28.08ms |   28.24ms |   27.50ms |   34.56ms
Detection       |   15.20ms |   15.30ms |   14.85ms |   16.62ms
------------------------------------------------------------
TOTAL           |   67.64ms |   67.87ms |   66.68ms |   74.09ms

🎯 Pipeline FPS: 14.8 FPS (Median)

V5.0 cv moderate
============================================================
📈 3-HEF PIPELINE ERGEBNISSE
============================================================

Schritt         |   Median |     Mean |      Min |      Max
------------------------------------------------------------
Backbone(L)     |   13.99ms |   14.01ms |   13.97ms |   14.48ms
Backbone(R)     |    9.62ms |    9.71ms |    9.53ms |   12.89ms
Geometry        |   21.66ms |   21.73ms |   21.46ms |   23.82ms
Detection       |   10.75ms |   10.81ms |   10.25ms |   16.30ms
------------------------------------------------------------
TOTAL           |   56.08ms |   56.27ms |   55.42ms |   63.72ms

🎯 Pipeline FPS: 17.8 FPS (Median)

V5.0 corr raw
