Hoehlenbaer/SLARC/src_dev/ai/test_images/tartan/amusement_P001_000000_left.png

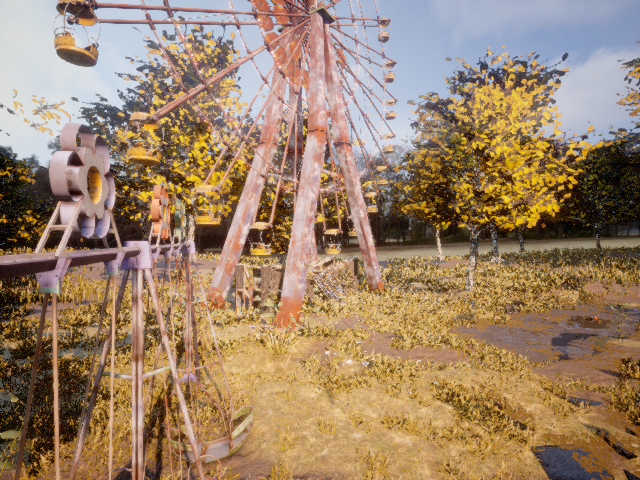
src_dev/ai/test_images/tartan/amusement_P001_000000_left.png
