Hoehlenbaer/SLARC/src_dev/ai/test_images/tartan/amusement_P004_001193_left.png

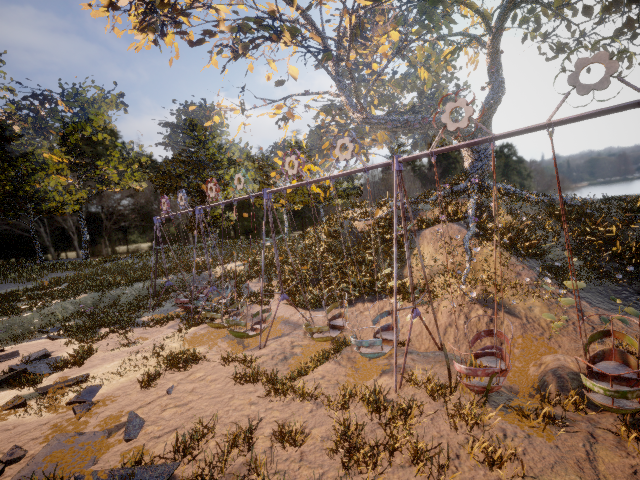
src_dev/ai/test_images/tartan/amusement_P004_001193_left.png
