Hoehlenbaer/SLARC/src_dev/ai/test_images/tartan/oldtown_P000_000000_left.png

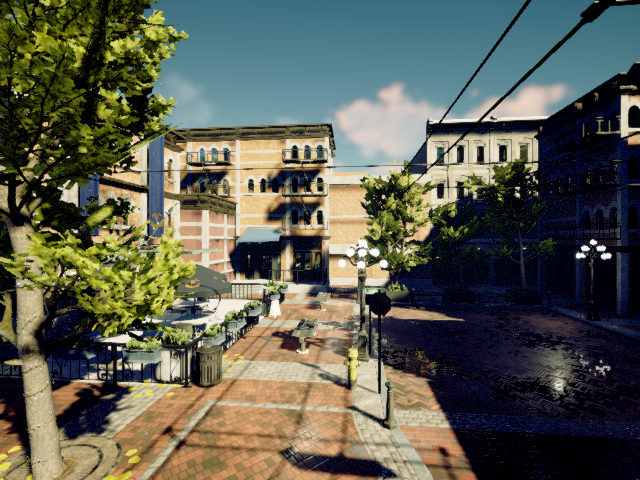
src_dev/ai/test_images/tartan/oldtown_P000_000000_left.png
