Hoehlenbaer/SLARC/src_dev/ai/test_images/tartan/oldtown_P000_000114_left.png

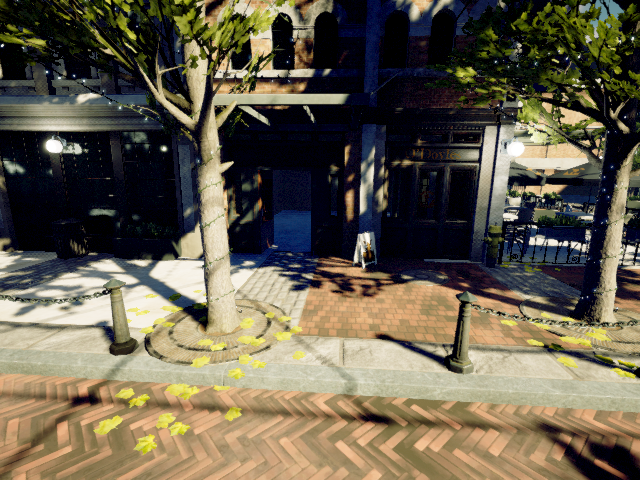
src_dev/ai/test_images/tartan/oldtown_P000_000114_left.png
