Hoehlenbaer/SLARC/src_dev/ai/test_images/tartan/oldtown_P001_000000_right.png

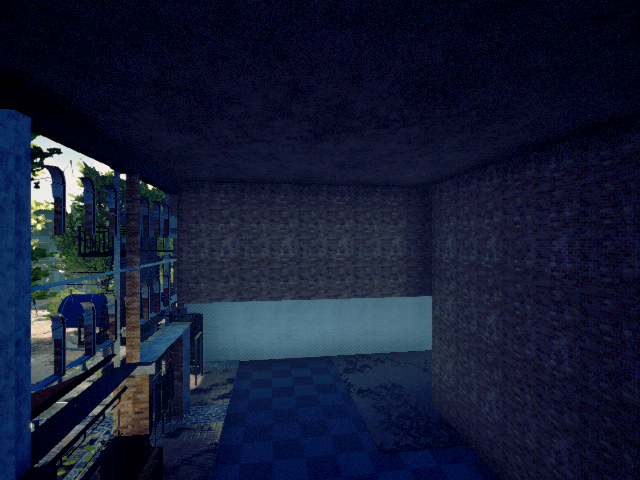
src_dev/ai/test_images/tartan/oldtown_P001_000000_right.png
