Hoehlenbaer/SLARC/src_dev/ai/test_images/tartan/oldtown_P001_000970_left.png

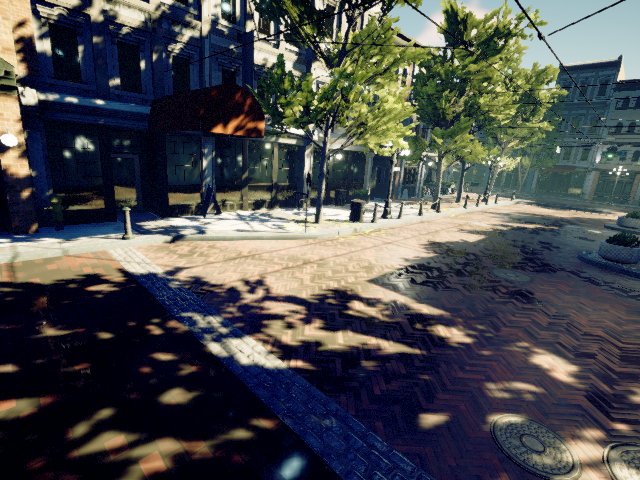
src_dev/ai/test_images/tartan/oldtown_P001_000970_left.png
