Hoehlenbaer/SLARC/src_dev/ai/test_images/tartan/oldtown_P004_000021_left.png

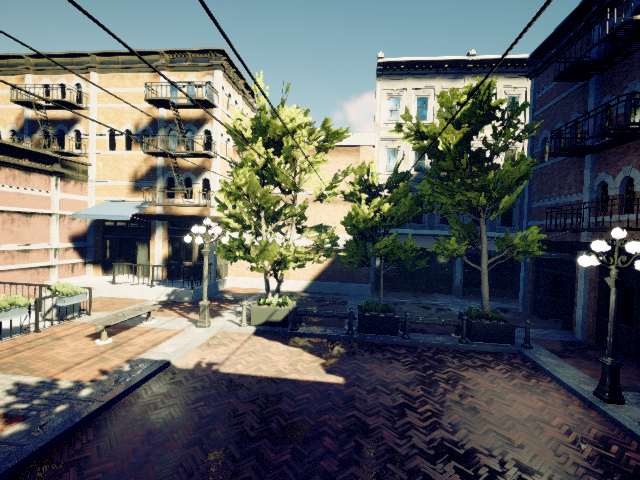
src_dev/ai/test_images/tartan/oldtown_P004_000021_left.png
