Hoehlenbaer/SLARC/src_dev/ai/test_images/tartan/oldtown_P004_000021_right.png

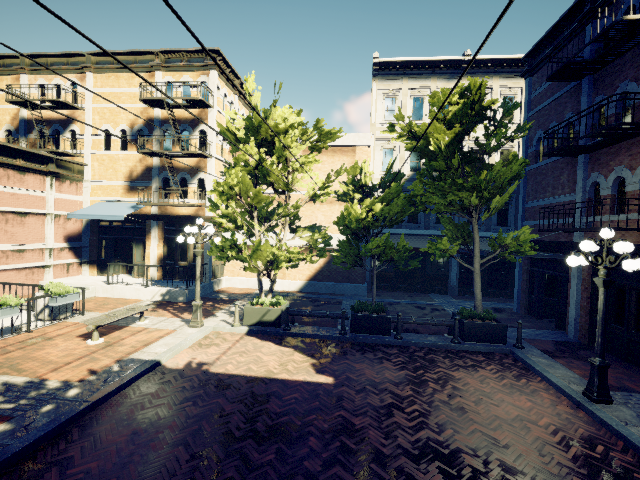
src_dev/ai/test_images/tartan/oldtown_P004_000021_right.png
