Hoehlenbaer/SLARC/Documentation/Models/FusedBackbone-Stereo/debug/FusedBackbone-Stereo_debug_ep_001.png

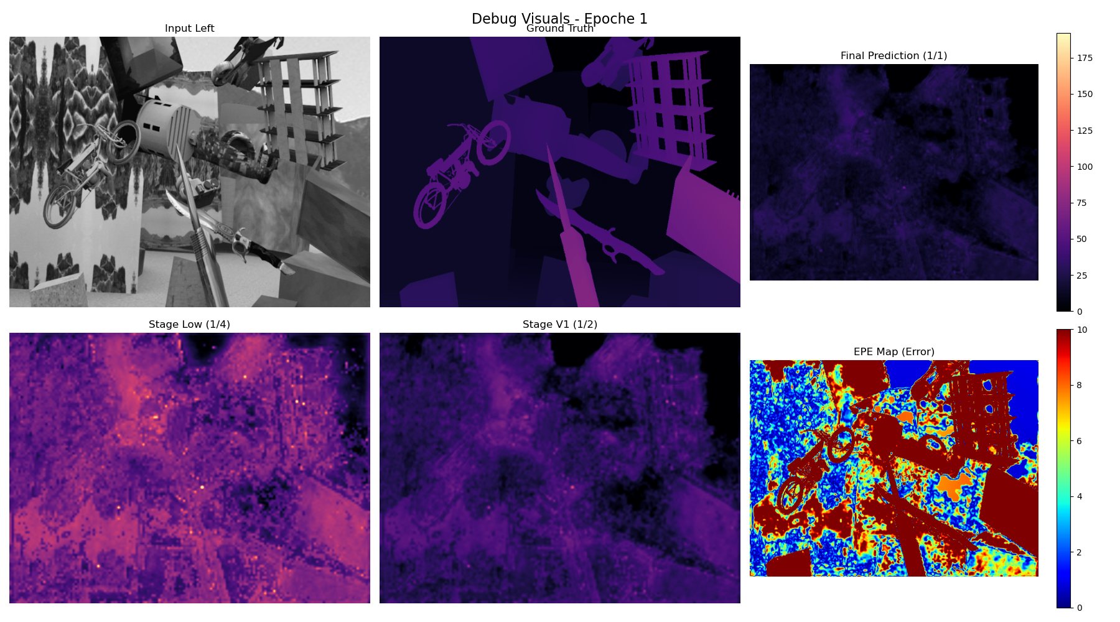
Documentation/Models/FusedBackbone-Stereo/debug/FusedBackbone-Stereo_debug_ep_001.png
