Hoehlenbaer/SLARC/Documentation/Models/FusedBackbone-Stereo/debug/FusedBackbone-Stereo_debug_ep_008.png

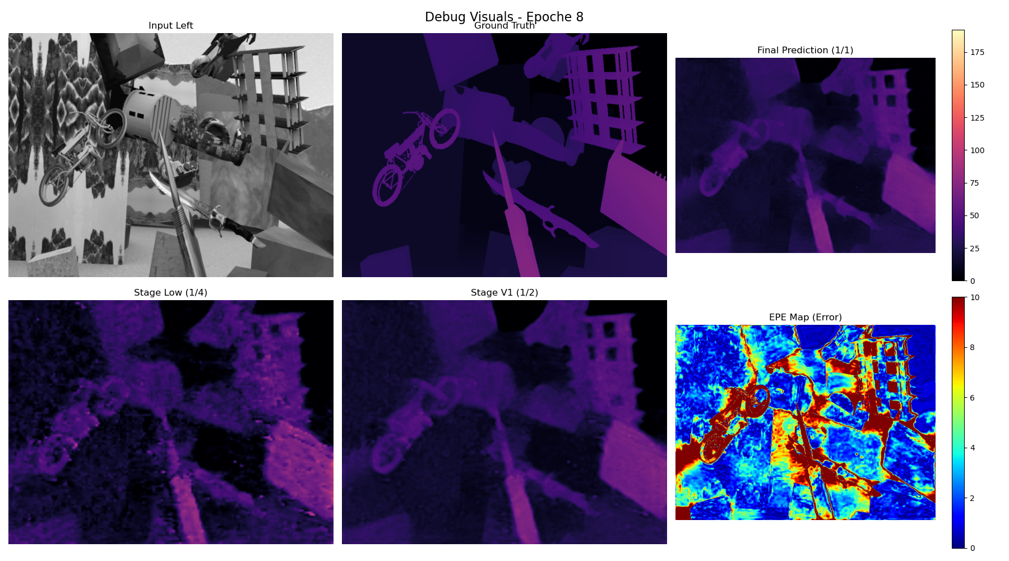
Documentation/Models/FusedBackbone-Stereo/debug/FusedBackbone-Stereo_debug_ep_008.png
