Hoehlenbaer/SLARC/Documentation/Models/FusedBackbone-Stereo/debug/FusedBackbone-Stereo_debug_ep_050.png

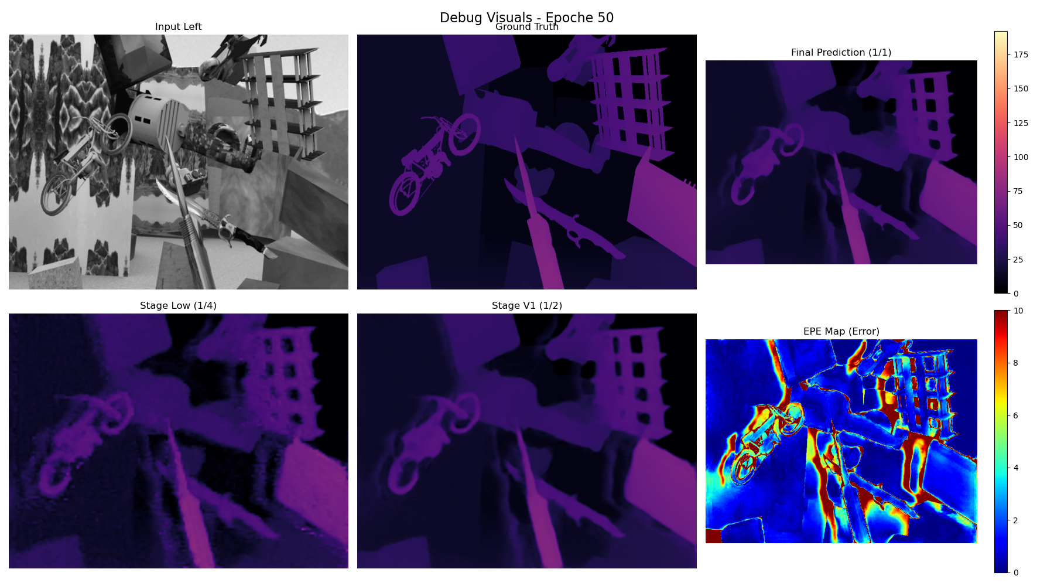
Documentation/Models/FusedBackbone-Stereo/debug/FusedBackbone-Stereo_debug_ep_050.png
