Hoehlenbaer/SLARC/Documentation/Models/FusedBackbone-Stereo/debug/FusedBackbone-Stereo_preview_epoch_003.png

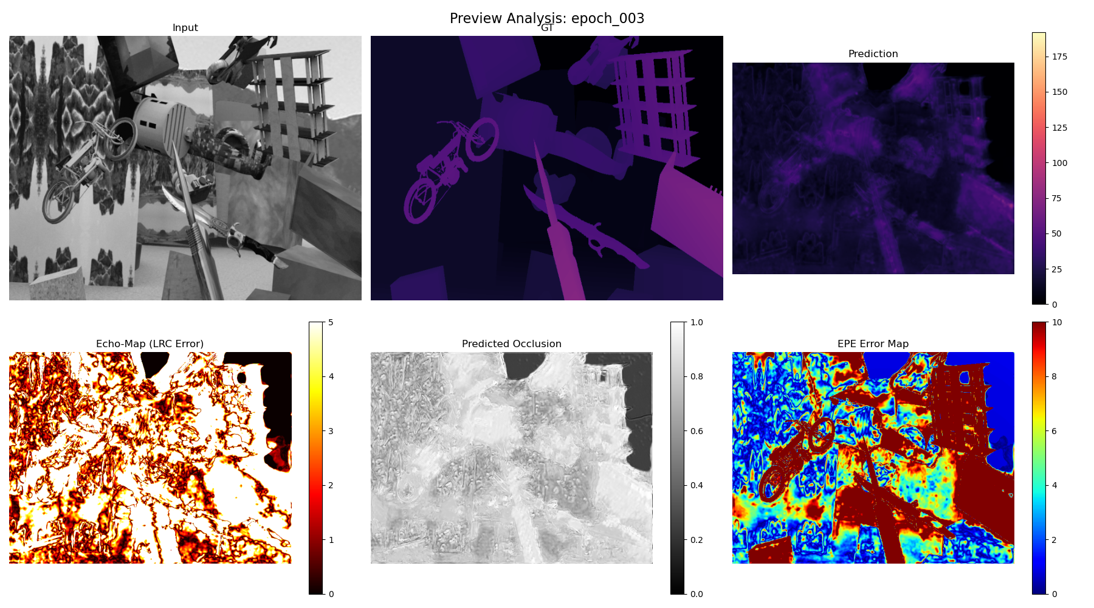
Documentation/Models/FusedBackbone-Stereo/debug/FusedBackbone-Stereo_preview_epoch_003.png
