Hoehlenbaer/SLARC/Documentation/Models/FusedBackbone-Stereo/debug/FusedBackbone-Stereo_profile_ep002.png

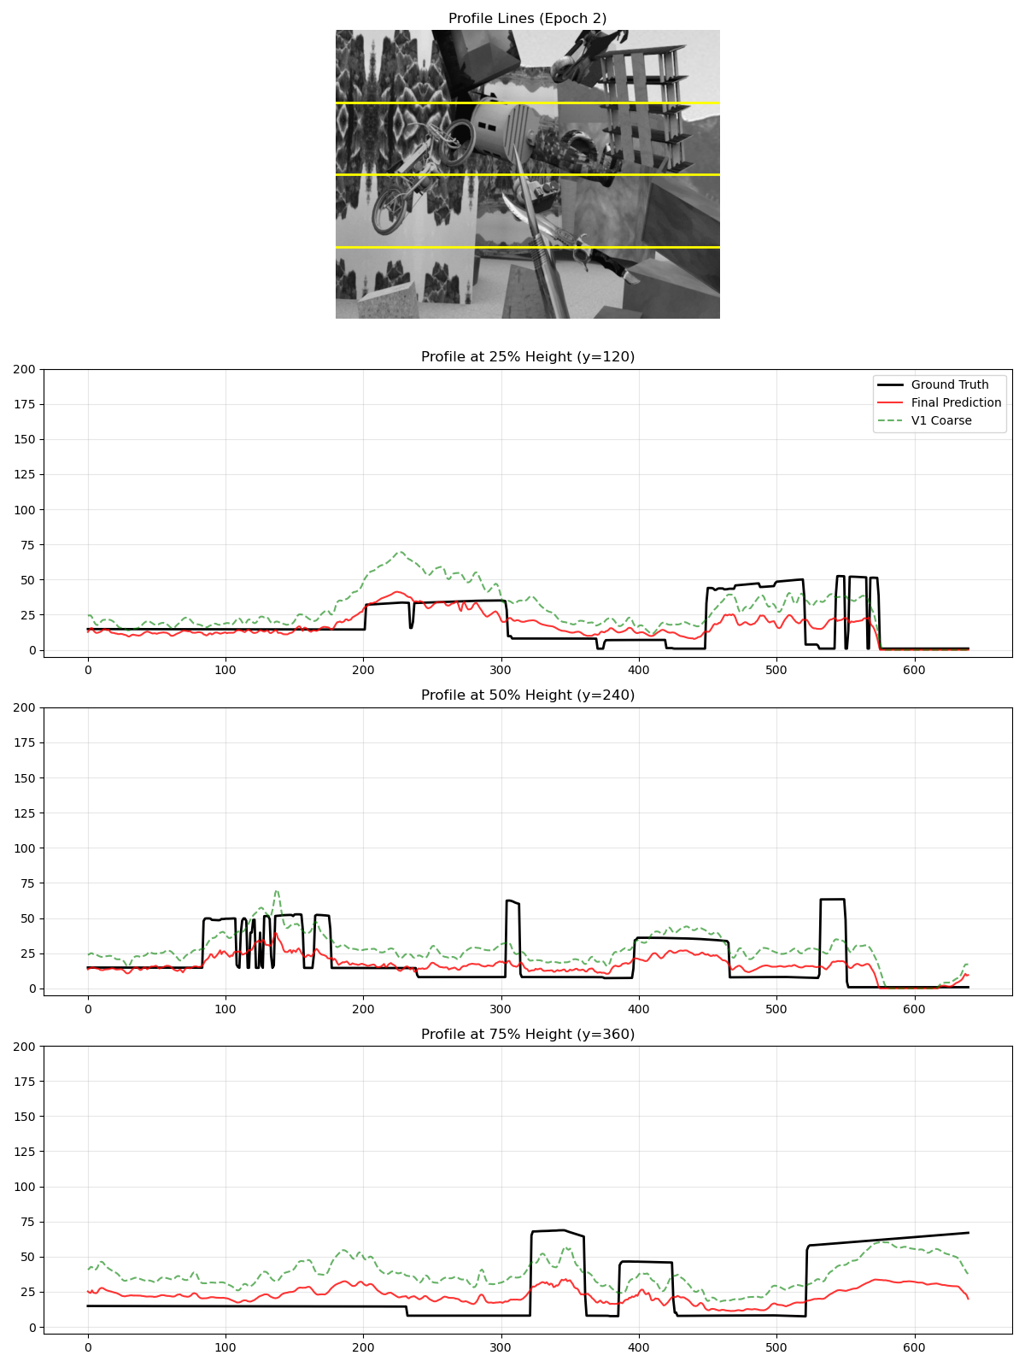
Documentation/Models/FusedBackbone-Stereo/debug/FusedBackbone-Stereo_profile_ep002.png
