Hoehlenbaer/SLARC/Documentation/Models/FusedBackbone-Stereo/debug/FusedBackbone-Stereo_profile_ep012.png

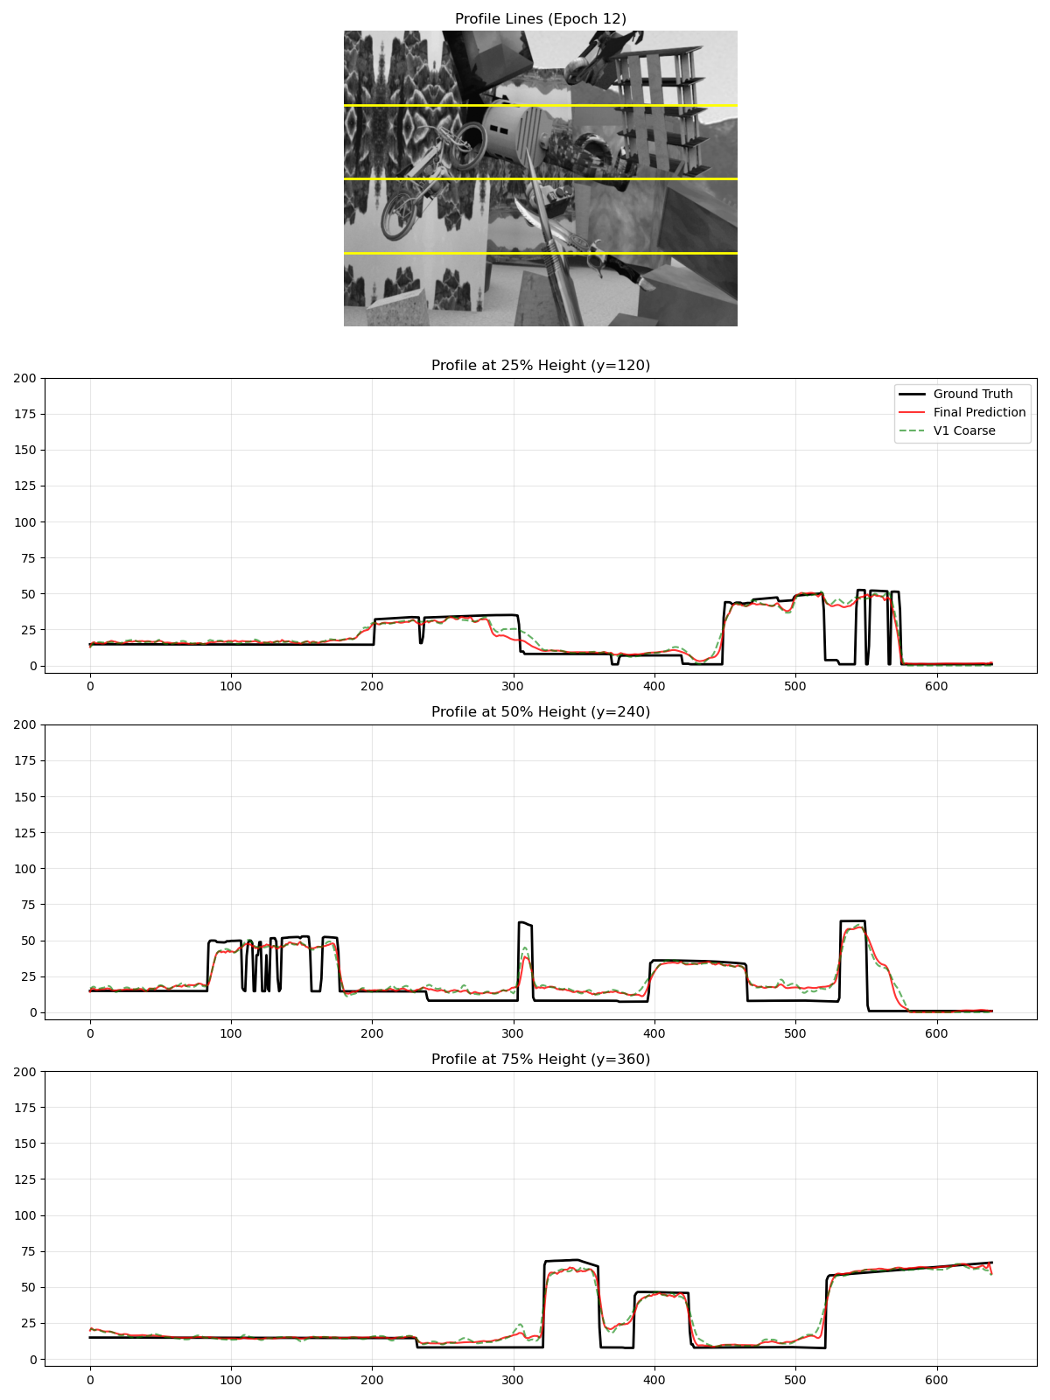
Documentation/Models/FusedBackbone-Stereo/debug/FusedBackbone-Stereo_profile_ep012.png
