Hoehlenbaer/SLARC/Documentation/Models/FusedBackbone-Stereo/debug/FusedBackbone-Stereo_symmetry_ep004.png

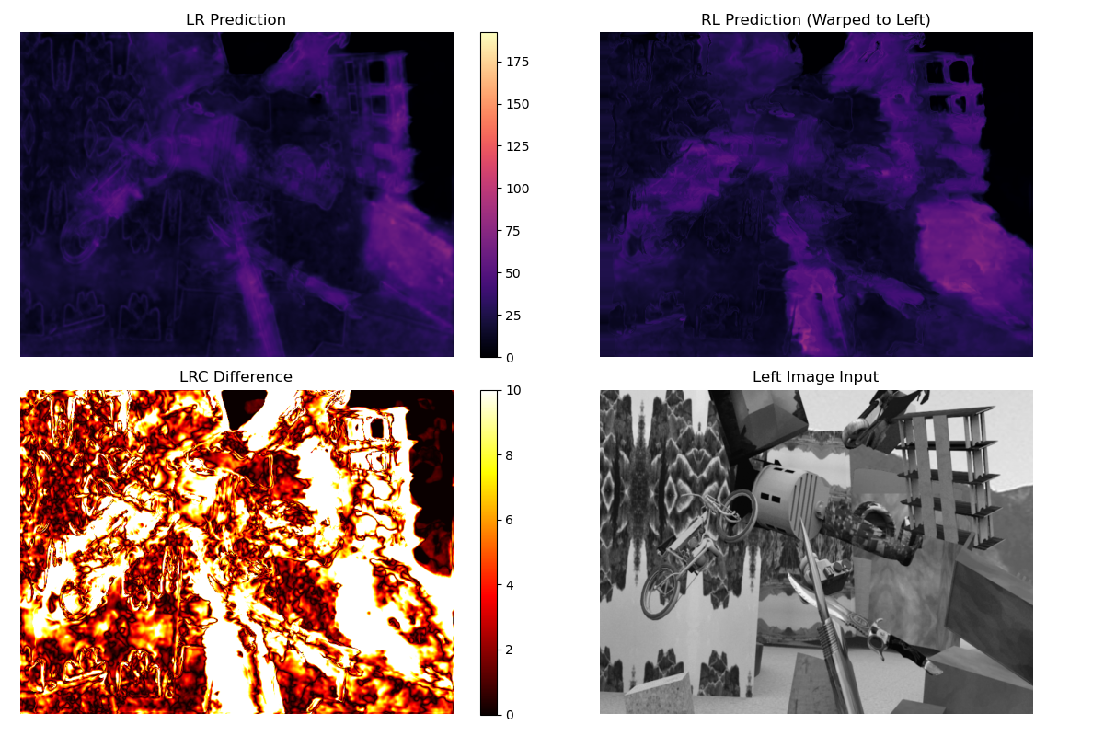
Documentation/Models/FusedBackbone-Stereo/debug/FusedBackbone-Stereo_symmetry_ep004.png
