Hoehlenbaer/SLARC/Documentation/Models/FusedBackbone-Stereo/debug/FusedBackbone-Stereo_symmetry_ep018.png

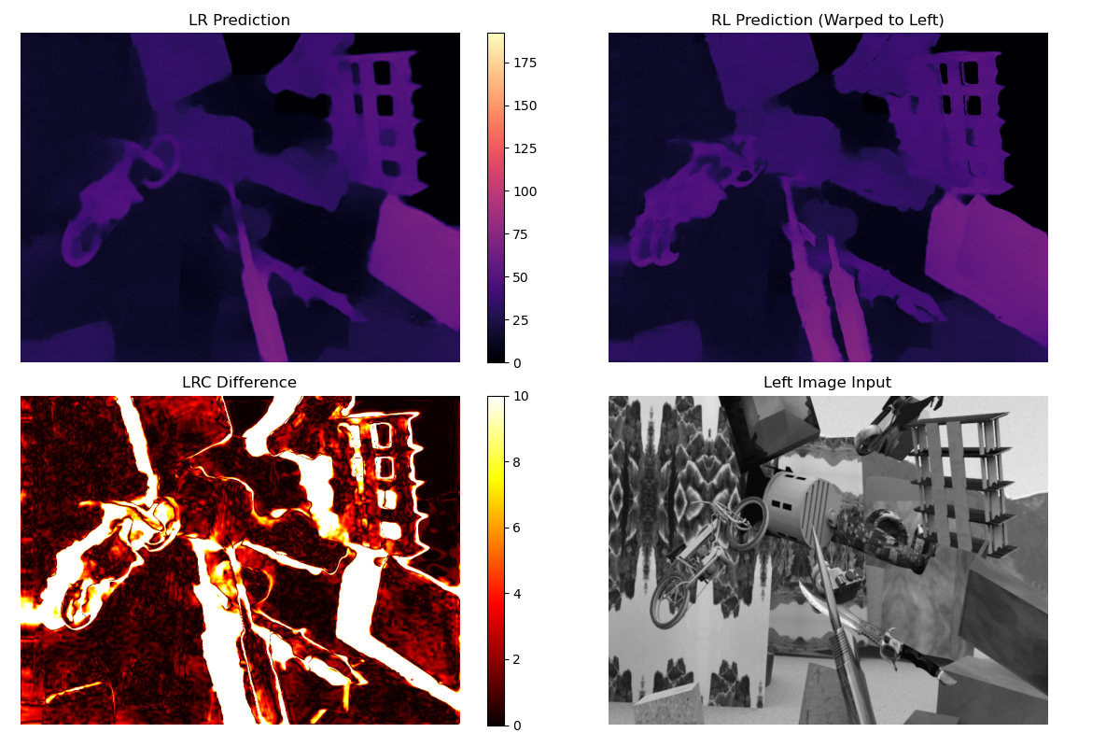
Documentation/Models/FusedBackbone-Stereo/debug/FusedBackbone-Stereo_symmetry_ep018.png
