Hoehlenbaer/SLARC/Documentation/Models/FusedBackbone-Stereo/debug/FusedBackbone-Stereo_symmetry_ep061.png

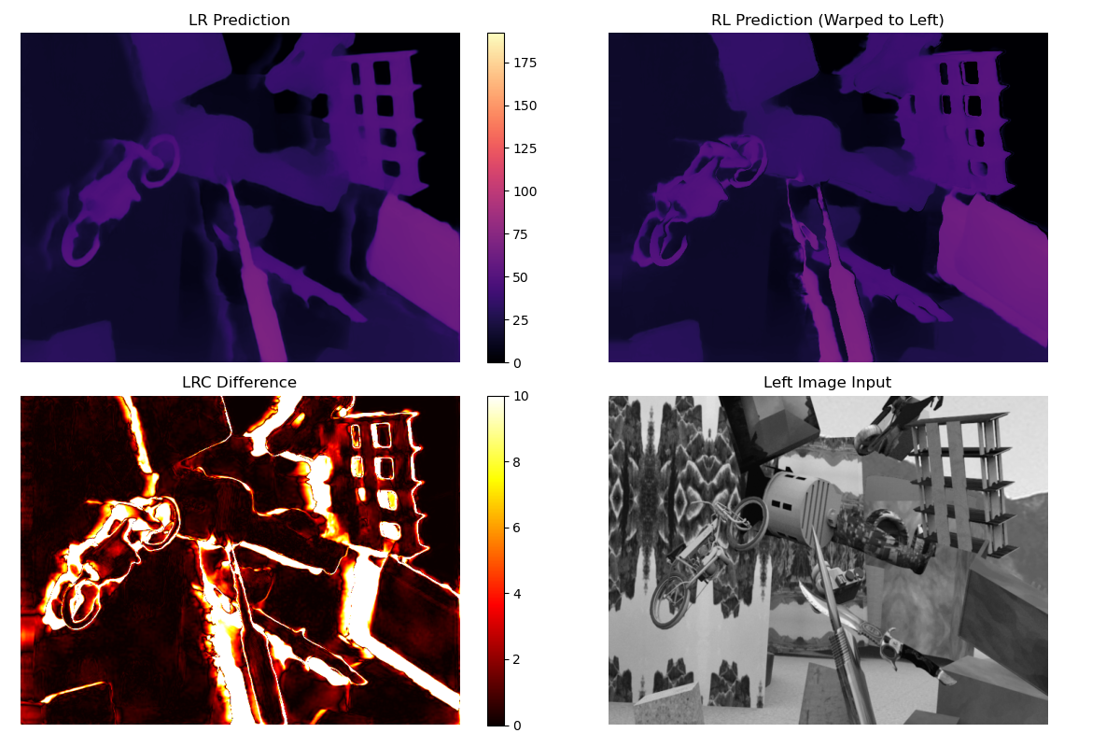
Documentation/Models/FusedBackbone-Stereo/debug/FusedBackbone-Stereo_symmetry_ep061.png
