Hoehlenbaer/SLARC/Documentation/Models/StereoFusion_V8/debug_ep_001.png

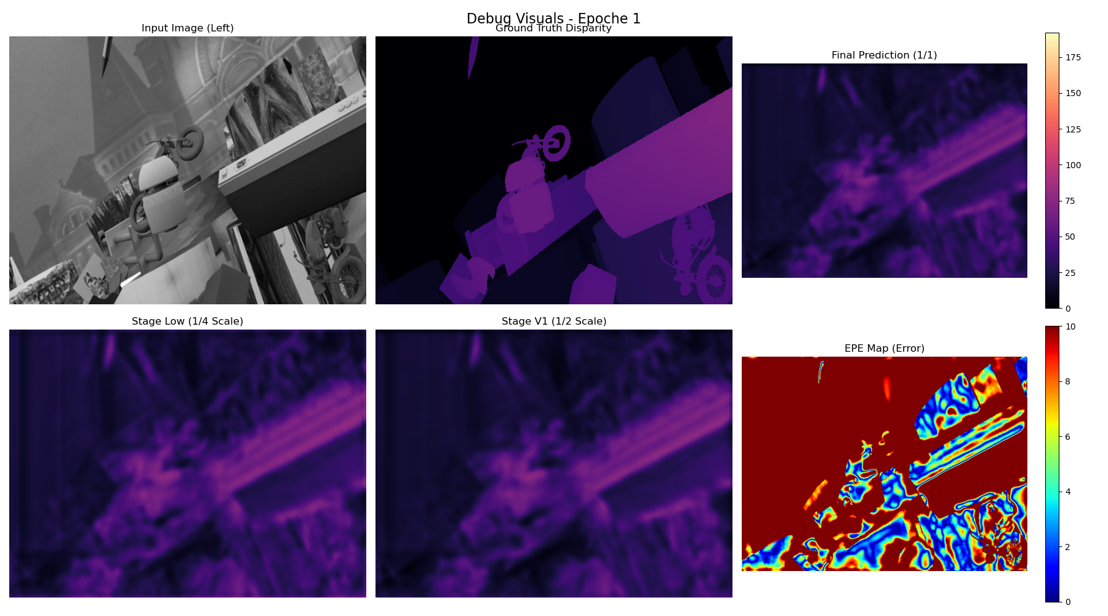
Documentation/Models/StereoFusion_V8/debug_ep_001.png
