Hoehlenbaer/SLARC/Documentation/Models/StereoFusion_V8/debug_ep_003.png

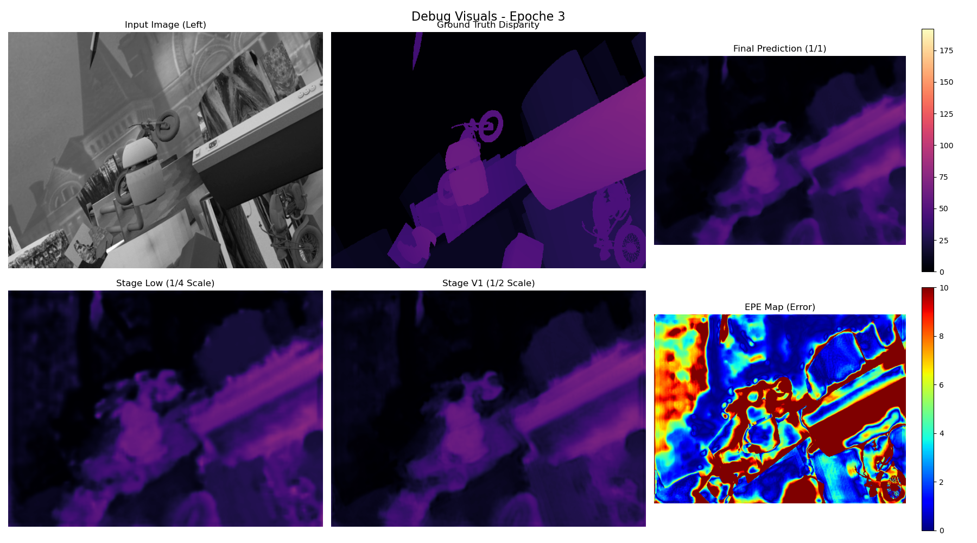
Documentation/Models/StereoFusion_V8/debug_ep_003.png
