Hoehlenbaer/SLARC/Drawings/Step files/ZH3019.pdf

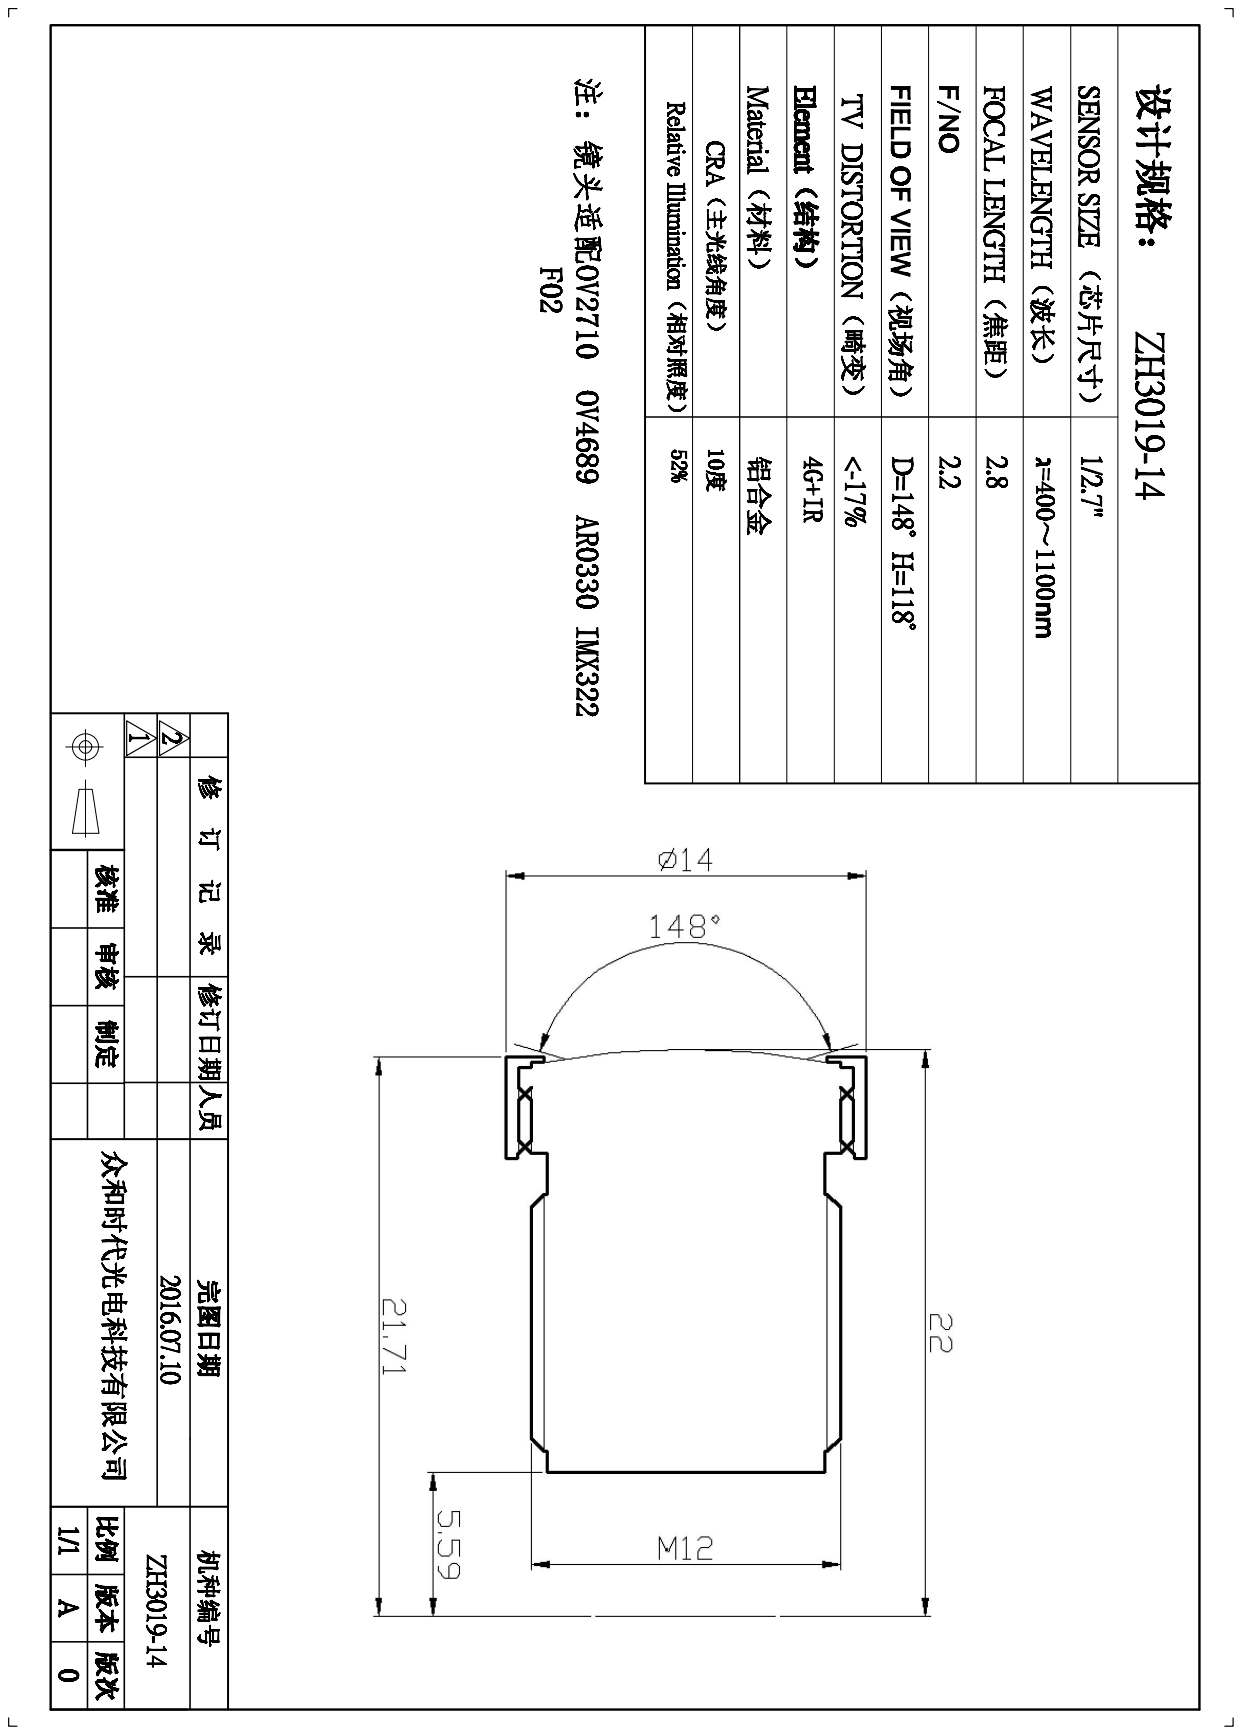
[picture p77: page 1]
