Hoehlenbaer/SLARC/Drawings/IMX219-83 2D drawing.pdf

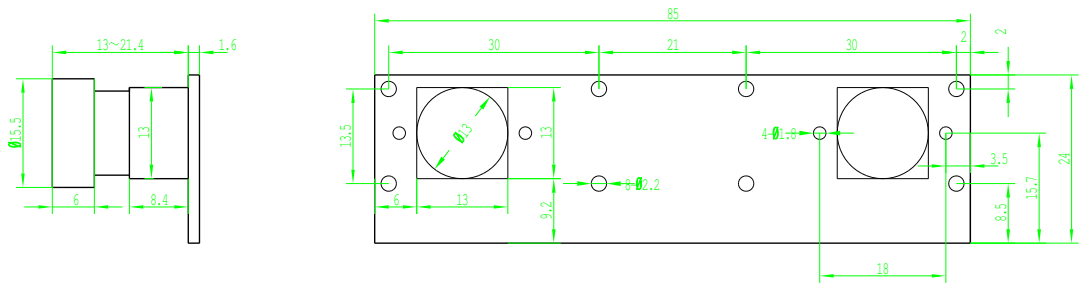
[picture p78: page 1]
