Hoehlenbaer/SLARC/Archive/stuff/FusedBackbone-Stereo/logs.pdf

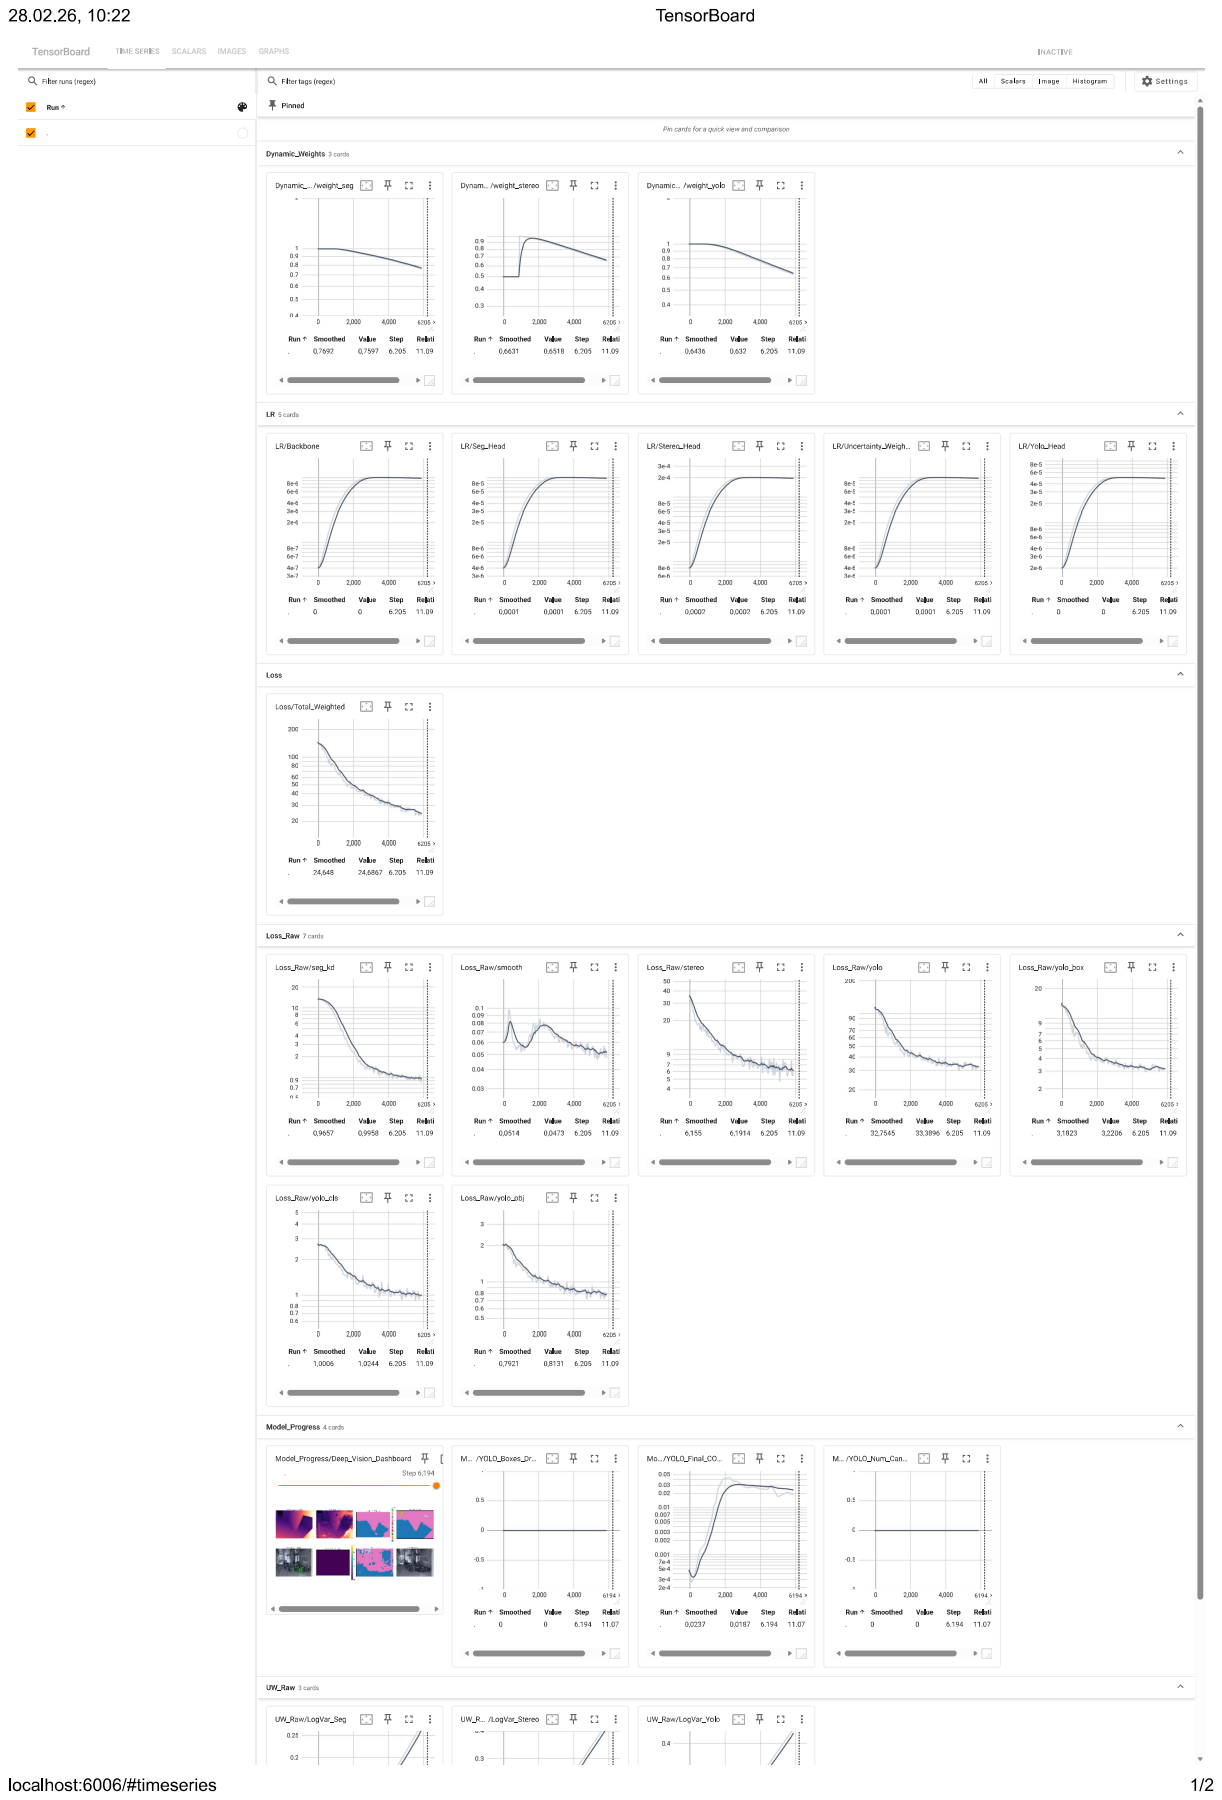
[picture p79: page 1]

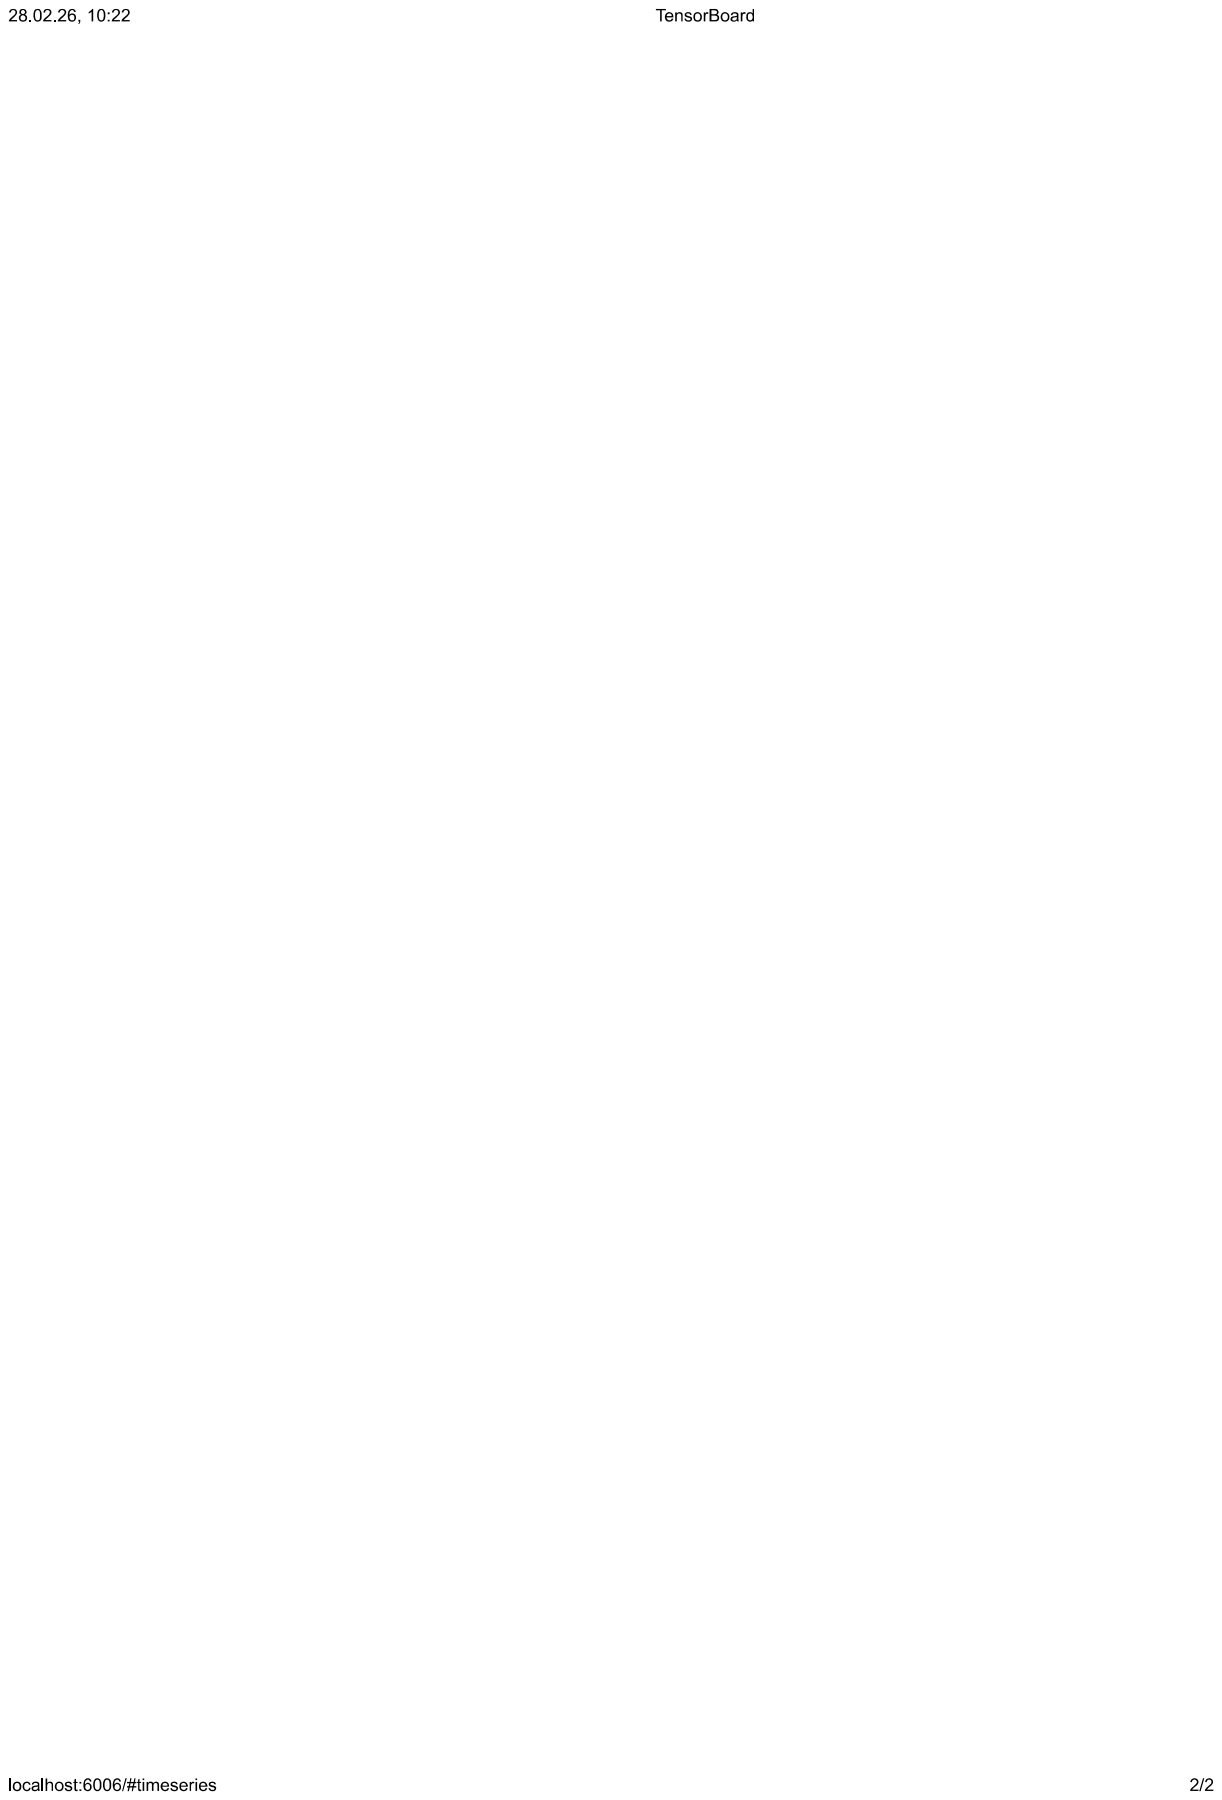
[picture p80: page 2]
