Hoehlenbaer/SLARC/Drawings/Macros/slarc_foot_slider_test_v1.py

# -*- coding: utf-8 -*-
"""
SLARC – Gleithülse PETG mit Federzungen für den zweiteiligen Fuß (Testreihe).   V1.1
FreeCAD 0.21 / 1.0 – Makro ausführen oder:
    exec(open(r"PFAD/slarc_foot_slider_test_v1.py", encoding="utf-8").read())

V1.1 (14.11.2026)
- Statt Gewindeeinsatz + Madenschraube: Zylinderschraube M3x6 (vorhanden, ISO 4762) direkt in PETG geschnitten
  (Kernloch SCR_D), Kopf in einer Senkung von außen. Der Kopf liegt nicht auf, die Schraube hält durch die
  Reibung im selbst geschnittenen Gewinde. Stirnwand 8 statt 6 mm, damit der Kopf versenkt bleibt.

Hintergrund (14.11.2026)
- Der einteilige TPU-Fuß hat zwei Probleme: Gleitpassung TPU auf PETG streut stark, und der innere Anschlag
  ist eine TPU-Brücke (ungleichmäßig, Tibiaspitze schlägt an, Fuß kann nicht mehr gleiten).
- Neues Konzept, zweiteilig: starre Gleithülse aus PETG auf dem Tibia-Ende, darüber später ein TPU-Überzug
  (Kugel, Griff, Dämpfung), der keine Präzision mehr braucht.

Gleithülse
- Gedruckt mit der geschlossenen Stirnwand auf dem Bett: die innere Anschlagfläche liegt auf massivem Material,
  ohne Brücke und eben. Anschlag = Tibia-Stirnfläche (XE im Bein-Makro).
- Halt ohne neue Tibia: zwei Federzungen (U-Schlitze) auf den 20-mm-Seiten, an der Spitze je ein starrer Haken,
  der in die vorhandene Nut der Tibia greift (Nut 1.0 tief, 2.9 lang). Haken ragt HOOK_P über die Tibia;
  Weg zwischen Anschlag und Haken an der Nutwand ca. 1.2 mm (wie TPU-Fuß).
- Schaltpunkt einstellbar: Zylinderschraube M3x6 von außen durch die Stirnwand, direkt ins PETG geschnitten.
  Das Schraubenende drückt durch die offene Schaltertasche auf den Stößel. Überstand innen = 6 - SCR_WALL -
  Kopfabstand zum Senkungsgrund, also 0 bis 3.5 mm. Einstellen: Hülse auf Anschlag drücken, Schraube eindrehen,
  bis der Schalter klickt, dann ca. 1/8 Umdrehung weiter (0.06 mm).
- Testreihe: Spiel CLEAR je Seite, Wert vertieft auf einer 28-mm-Seite.

Maße aus slarc_leg_freecad_v9.py (dort ändern, hier nachziehen): link_w, link_h, foot_trav, lip_w, Nut.
Koordinaten: Z = Druckrichtung (Z=0 Bett = Außenseite Stirnwand), X = link_h-Richtung (Haken), Y = link_w.
"""
import os
import FreeCAD as App
import Part

V = App.Vector

# --- Werte aus dem Bein-Makro V9 ---
LINK_W = 20.0      # Glied quer zur Gelenkachse
LINK_H = 28.0      # Glied entlang der Gelenkachse; Nuten auf den beiden 20-mm-Seiten (x = ±LINK_H/2)
INNER_L = 30.0     # Stirnwand innen bis Öffnung (= boot_l): Haken liegt bei Anschlag 0.2 mm in der Nut
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
