Hoehlenbaer/SLARC/(commit log)

2025-09-16 Added drawings & documentation
    [0619.stp]
2025-09-28 Update git structure
    [0619.stp]
2025-09-28 Added drawings and documentation
    [0619.stp]
2025-11-21 renamed: src_dev/vision/Calibration image recorder.py -> src_dev/vision/Archive/Calibration image recorder.py renamed: src_dev/vision/gdb consumer.py -> src_dev/vision/Archive/gdb consumer.py renamed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
2025-12-04 modified: setup_venvs.sh new file: src_dev/ai/__pycache__/ai_main.cpython-311.pyc new file: src_dev/ai/ai_main.py modified: src_dev/launch_all.py renamed: src_dev/vision/capture.py -> src_dev/vision/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
2025-12-05 modified: src_dev/ai/ai_main.py renamed: src_dev/ai/ai_worker.py -> src_dev/ai/archive/ai_worker.py modified: src_dev/launch_all.py renamed: src_dev/motion_control/control.py -> src_dev/motion_contro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
2025-12-14 Created several chain of thoughts models
2026-01-10 Update documentation
    [General Driver for Robots STEP.step]
2026-01-11 Add ST3215 step file
    [ST3215.step]
2026-02-02 Update training progress
    [Distance vs Disparity.xlsx]
2026-03-09 Update FusedHexapodModel_V2_3_Phase-2 - draft.ipynb
2026-03-13 Update files
    [alle_metriken_zusammen.csv]
2026-03-31 upload debug metrics
    [alle_metriken_zusammen.csv]
2026-04-26 clean up repo
    [alle_metriken_zusammen.csv]
2026-08-09 Upload slarc_sim folder
    [slarc_log_20260608_210906_OFF.csv, slarc_log_20260608_211106_ON.csv, slarc_log_20260608_211147_Mode_2.csv, slarc_log_20260609_192505.csv, slarc_log_20260612_145732.csv, slarc_log_20260614_124632.csv, slarc_log_20260614_170418.csv, slarc_log_20260614_171054.csv]
2026-10-23 Update README: hardware, locomotion/simulation, ESP32, CAD, repo structure
    - Hardware table: 65 mm stereo baseline, HW trigger, leg geometry, TPU feet
    with µ-switch, IMU, BMS/relay, size and mass estimate
    - New sections: Locomotion & Simulation (R1-R3, gaits, stair climbing,
    tools), Low-Level Control (ESP32, Pi<->ESP32 protocol v0.1), Mechanical
    Design (FreeCAD macros, BOM)
    - Planning layer table (exploration manager, BT executor, replanner)
    - Repository structure rewritten to match src_stable/src_dev layout
    - Project status extended
    Claude-Session: https://claude.ai/code/session_0185t9tPaxSFoR6YPk1eVvYK
2026-10-23 Add CAD macros
2026-10-23 README paths to Drawings/Macros, add BOM, remove Windows stream files
    - README: CAD now in Drawings/Macros, BOM path, ESP32 firmware marked as
    in development (not in repo), firmware/ and CAD/ removed from structure
    - Add Drawings/Macros/SLARC_Stueckliste.xlsx
    - Remove 36 *Zone.Identifier / *mshield files and Drawings/STL files/temp.FCStd
    - .gitignore: ignore Zone.Identifier, mshield, __pycache__
    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
2026-10-23 Update standard leg params
2026-10-23 Baseplate V2.5: DC-DC 5 V mount, module spots for MCP23017/MUX; BOM update
    - Top plate rear: Fulree F35J5V5A1S-C (46.2x27.5x14, open tab slots) with
    2x M3 slotted holes; two module carrier spots (2x M3 each) for MCP23017
    and an optional I2C mux. Holes only - rear part prints upside down.
    - BOM: DC-DC, MCP23017, optional mux/WS2812, pull-ups, M3 screws; printed
    volumes updated for the new leg defaults (femur 150 / tibia 175, bend 38.6)
    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
2026-10-23 Stereo mount V1.4: ICM20948 mount on top rim; README IMU line
    - slarc_stereo_mount_v1_4.py: two M2 pilot holes (13 mm, in the front plate
    section) with 1.5 mm standoffs on the top rim, centered between the
    cameras; placeholder board for checks; IMU_MOUNT flag
    - Baseplate macro: identical bracket incl. IMU mount
    - README: IMU = QMI8658C on driver board + ICM-20948 for VIO/SLAM
    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
2026-10-23 ICM20948 mount: measured hole pattern 13.6 mm, M2.5, 2.7 mm from edge
    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
2026-10-23 Cover V1: beetle-shaped lattice back shell with ridge crest
    - slarc_cover_v1.py: gabled roof (40 deg) with ridge crest, honeycomb
    lattice, side windows, Pi port windows, cable notches, 8 posts on the
    plate column positions (M3 inserts, column screws M3x50 from below),
    inner frames, split at x=-15 with 3x M3. Two parts, printable without
    supports.
    - Assembly macro: COVER flag inserts the shell
    - BOM + README updated
    Checked in FreeCAD: both parts valid single solids, no overlap with Pi
    (+HAT envelope), driver, DC-DC, module spots, camera mount, servos;
    base fully on plate material.
    Claude-Session: https://claude.ai/code/session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
2026-10-23 Cover V1.1: lighter back shell (~170 g instead of ~270 g)
    - wall 3.0 -> 2.4 mm, honeycomb 9 mm / rib 2.4 mm, diamond windows in
    the side walls, narrower intermediate frames (3 mm, 5 mm flange),
    hollow posts, crest 3 mm wide
    - 6 posts instead of 8 (the split frame carries at x = -40); roof skin
    kept closed around each post
    - one intermediate frame removed (x = 40)
    - BOM: volumes, 6x M3x50 + 6 inserts, 2x M3x45 remain at x = -40
    Checked in FreeCAD: both parts single valid solids, no overlaps with
    electronics/servos, base fully on plate, no overhang > 55 deg except
    small hole tops.
    Claude-Session: https://claude.ai/code/session_018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
2026-10-24 Leg V9.1: chamfer on fork bridge edges, femur/knee range ±109 -> ±117 deg
    45 deg chamfer (fork_ch = 6) on both inner edges of the femur and tibia
    fork bridge, only between the cheeks. Checked in FreeCAD for normal and
    mirrored leg: first contact at 117-118 deg (was 109-110).
    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
2026-10-24 Sim V10.17: CAD leg geometry, CAD URDF, real joint limits, G_RADIUS 0.18
    - Leg geometry from the CAD model as one source (LEG_* constants): femur
    150 mm, femur axis 17 mm below the coxa axis, bent tibia as straight
    substitute 159.2 mm with 29.07 deg offset (servo angle = substitute - offset)
    - urdf/slarc_cad.urdf with meshes, masses and inertias from SLARC.FCStd
    (3.79 kg); loaded with URDF_USE_INERTIA_FROM_FILE, primitives as fallback
    (primitive generator now uses the same kinematics)
    - IK: real mechanical limits in servo convention (coxa ±90, femur/tibia
    ±112); targets outside are pulled back along the line to the neutral
    foot point by bisection instead of clipping single join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
2026-10-24 BOM: remove SN74LVC1G125 buffer (already on the Waveshare driver board)
    Row removed, positions renumbered, sums/count/validation ranges adjusted.
    Prices and status entries kept.
    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
2026-10-24 Add ST3215 dummy for coxa positions (STL + STEP)
    Outer contour sliced from the manufacturer STEP (0.1 mm bands at top
    and bottom), solid inside, without horn/rear disc; pilot holes 1.7 mm
    for the 2x5 screws at the plate screw positions. Checked against both
    plates at all six coxa positions (no overlap). Print lying on its side.
    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
2026-10-24 Baseplate V2.6: battery connector holder (Deans + balancer) on bottom plate
    Separate printed holder at the rear left of the bottom plate, next to the
    battery exit: Deans pins (robot side) below, balancer adapter to the BMS
    sense lead above, openings facing rearwards, back wall with cable slots,
    cable tie slots, 2x M3 + nut (two new holes in the bottom plate).
    Connector sizes are start values (to be measured).
    Checked: no overlap with battery path, RL servo (2.8 mm), plates.
    BOM: XT60 -> Deans robot side, M3x10 + nut 6 -> 8.
    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
2026-10-24 Battery latch: no half-shells in the battery exit path
    The 12 mm half-shells stood behind the battery and blocked it from being
    pulled out. Now nothing stays on the bottom plate once the pins are pulled:
    - pins are guided at both ends: bottom plate (bayonet slot + detent notch
    in the plate top) and a guide bore in the top plate (chamfered below)
    - rear end of the battery pocket is a 4 mm ramp instead of a 2 mm step
    - FreeCAD check: battery pulled out 170 mm with pins removed, no contact
    with bottom plate, top plate or connector holder
    - BOM volumes updated (bottom rear, top rear, pin)
    Claude-Session: https://claude.ai/code/session_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
2026-10-24 Battery latch: one centered pin between the battery cable exits
    Balancer and main lead leave the battery end face near the sides; two pins
    at y +-16 could collide with them. One pin at y 0 sits in the gap.
    BOM: latch pin x1, foam pad x1, rear plate volumes.
    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
2026-10-24 Stereo mount V1.4.1: IMU bosses 0.5 mm back, flat front face
    The Ø4.5 bosses for the ICM20948 pilot holes stood 0.25 mm past the front
    face, so the mount could not be printed front face down. imu_hz 2.0 -> 2.5
    (also in the copy in the baseplate macro). Front face is one flat face again.
    STL updated (it still predated the IMU bosses).
    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
2026-10-24 Stereo mount V1.5: rounded corners
    - Upper frame corners R6 (front view), inner board corner stays square,
    min. wall 1.76 mm
    - Ear ends fully rounded (R2), fillet R2.5 between frame and ear
    (M3 screw head stays clear)
    - Same geometry in the copy in the baseplate macro (checked: identical)
    - STL, BOM (volume, print hint: brim, fan from layer 4), README
    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
2026-10-25 Stereo mount V1.5.1: IMU bosses reach the front face
    Printed front face down, the Ø4.5 bosses started 0.25 mm above the bed
    (floating island). Each boss now gets a pad down to the front face
    (D shape), so it stands on the bed. Front face stays flat; same change
    in the baseplate copy (checked identical). STL updated.
    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
2026-10-25 M12 lens ZH3019-14 in stereo macro and assembly
    - lens_zh3019(): revolved body after the manufacturer drawing (M12 thread,
    neck, Ø14 head, glass dome 0.29 mm proud), image plane = sensor surface
    1.7 mm above the board top (camera STEP), 5.59 mm to the lens end
    - baseplate macro adds Lens_ZH3019_L/R -> shows up in the assembly
    - stereo macro: LENS switch, camera STEP now also found as
    "IMX296 With M12.stp" (name used in the repo)
    - no interference with mount, top plate or camera STEP
    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
2026-10-25 Wiring plan and perfboard layouts
    - Documentation/Wiring: block diagram, current budget and wire gauges,
    wire list, ESP32/Pi pin assignment, power-on sequence, commissioning
    - perfboard layouts (SVG, generated by gen_wiring_svg.py): A leg
    distributor (6x), B hub with MCP23017 + data star, C power distributor,
    D relay adapter (diodes for the ESP32, BC547 for the Pi hold)
    - BOM: parts for the boards (470 uF, 100 nF, BC547, 4k7, DIP-28 socket,
    headers, AWG24/AWG14, bus-bar copper), MCP23017 as DIP-28
    - README: power line and repo structure
    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
2026-10-25 Wiring: one relay per leg, MCP23017 module, relay module without diodes
    - K2..K7 switch one leg each (max 8.1 A < 10 A contact rating);
    one relay per side (~15 A peak) would be overloaded
    - relay module with JD-VCC jumper removed: opto side 3.3 V, coils 5 V,
    inputs driven directly by 3.3 V logic; IO16 open-drain, Pi via BC547
    - hub board for the MCP23017-E breakout (20-pin side header), I2C/INT
    straight to the module's top header
    - power board reduced to two bus bars (12 V, GND)
    - BOM: MCP23017 module, relay spec, 1N4148 and DIP socket removed
    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
2026-10-25 Baseplate V2.8: places and mounts for the perfboards
    - leg boards A (half 3x7) between the plates on M2 bosses of the bottom
    plate: FR/FL x 183, MR/ML x 0, RR/RL x -100 (outside the battery path)
    - hub B (5x7, holes 66x46) on a printed carrier at the MCP module spot,
    module side outward where the shell is low
    - power board C on a printed bridge over the BMS, resting on two sleeves
    slipped over the columns (60, +-45)
    - relay adapter D in front of the relay module (angled female header)
    - placeholders checked against servos, battery path, relay, BMS, holder,
    columns and back shell; STLs for carrier, bridge, sleeve; BOM updated
    Cl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
2026-10-25 Baseplate V2.9: printed Pi spacers, driver on 16 mm spacers
    - four printed sleeves (d6 x 6, bore 2.8) under the Pi 5; an M2.5x16 from
    below through plate, sleeve and Pi threads into the AI HAT+ standoffs
    - driver board height 12 -> 16 mm (spacers supplied with the board),
    clearance to the back shell still 6.6 mm
    - STL SLARC_Pi_Sleeve, BOM: M2.5x16 instead of bought Pi standoffs
    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
2026-10-25 Hardware interface document for the software workstreams
    Documentation/Hardware_Interfaces.md: responsibilities, coordinate and
    joint conventions, servo IDs and calibration needs, ESP32 and Pi pin
    assignment, I2C addresses, foot contacts, power sequencing, battery
    limits, camera/IMU mounting, inputs for the simulation, open hardware
    items and how to report interface changes.
    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
2026-10-25 Power button with ESP32 deep sleep (Baseplate V2.10)
    - 12 mm panel push button at the rear right between the plates, recessed
    5 mm behind the plate edge, printed bracket with 1x M3 on the bottom plate
    - hub board: J6 button, R7 10k pull-up, J7 -> IO35 (deep-sleep wake-up)
    - power sequence: battery stays connected; button wakes / switches off,
    web shutdown via the Pi, 5 s hold = emergency stop; storage: unplug
    Deans + balancer at the rear holder
    - interface doc: IO35, sequence, protocol needs, watchdog, open items
    (measure deep-sleep current; fallback K8 self-hold)
    - BOM: button, 10k x7, M3, bracket; STL SLARC_Button_Bracket
    Cla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
2026-10-26 Add STL file
2026-10-26 BOM: print settings per part and per material
    - Druckteile: columns for walls, orientation and supports/notes; infill
    updated (plates 40 %), ST3215 dummy as optional row
    - new sheet Druckeinstellungen with the settings shared by all parts of a
    material (PETG, TPU 95A, PLA): temperatures, fan, first layer, holes,
    retract, bridges, walls, top/bottom, adhesion
    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
2026-10-27 BOM: order list for screws and electronics
    - new sheet Bestellliste: screws/nuts/inserts sorted by thread and length,
    electronics grouped; quantities incl. reserve via SUMIF from Kaufteile,
    status via INDEX/MATCH
    - fixes: camera bracket ears are M3 (M3x25 + nut, not M2x25); lock nuts
    14 (+4) after the threaded inserts; fuse row = 30 A + inline holder
    - ICM-20948 added (on hand); spring wire usage described; known stock
    marked as vorhanden
    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
2026-10-27 Fewer screw types: relay on inserts, one column length, M2x6 only
    - Baseplate V2.11: relay bosses d8 with M3 insert pilot (4.0 x 6.5 from
    the top); relay fixed with M3x6 -> no M3x14, no nuts
    - all 8 columns M3x50 (M3x45 dropped), lock nuts 10 (+4)
    - M2x6 pan head (on hand) for camera and perfboards (M2x5 dropped)
    - inserts, M2 screws and washers marked as on hand
    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
2026-10-27 BOM: driver screws M2.5x7 are supplied, drop M2.5x5
    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
2026-11-01 make_urdf/gen_urdf: Pfade relativ zur Datei statt hart verdrahtet
    make_urdf.py enthielt neben Zeile 8 weitere harte Pfade (Cover-Makro,
    Ausgabe, Log, urdf_data.json). Ausgabe geht jetzt direkt nach urdf/.
    gen_urdf.py liest urdf_data.json dort, wo make_urdf.py sie jetzt ablegt.
    README und CLAUDE.md nachgezogen.
2026-11-01 Baseplates V2.12: Bein-Prüfstand für das erste Bein
    Unterteil + Deckel, Coxa-Servo wie im Roboter, Achse 60 mm vor der Tischkante.
    STLs, Stückliste (Hilfsmittel, nicht im Robotergewicht), Prüfstand-Verkabelung in Wiring/README.
    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
2026-11-01 Stückliste: Prüfstand-Deckel 40 % Gyroid, 4 Wände
    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
2026-11-01 Cura-Projekte pro Druckteil: Generator + Vorlagen PLA/PETG
    Ein Profil pro Material, Abweichungen als Einstellungen pro Modell (in Cura 5.13 geprüft).
    Erste Teile: Bein-Prüfstand Unterteil und Deckel.
    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
2026-11-01 Cura-Generator V1.1: Stückliste als Quelle
    Druckteile: neue Spalten STL-Datei und Cura-Ausrichtung. Skript liest Material, Füllung, Wände,
    Brim/Tree Support daraus, schützt von Hand gespeicherte Projekte, liest ASCII-STL.
    Druckeinstellungen an die Cura-Profile angeglichen. Projekte für 7 PETG-Teile erzeugt.
    Offener Punkt: Doku in der finalen Version komplett auf Englisch.
    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
2026-11-02 Baseplates V2.13: Servo-Wiege für formschlüssige Abstützung des Coxa-Servos
    Seitenwangen + hinterer Anschlag auf der unteren Platte (FR/FL/MR/ML) und im Prüfstand.
    Bein-Platinen FR/FL nach y ∓21,5. RR/RL offen (Kollision Taster/Steckerhalter).
    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
2026-11-02 V2.13: Taster und Steckerhalter an die Seiten, Wiegen auch RR/RL, Fenster unter Pi/Treiber
    Taster rechts, Akkustecker-Halter links bei x -140 (8 mm hinter der Kante).
    Fenster in der oberen Platte innerhalb der Lochbilder von Pi und Treiber (-13,5 cm³).
    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
2026-11-02 ESP32-Firmware V0.1: PlatformIO-Gerüst und Inbetriebnahme-Werkzeug
    - firmware/esp32: config.h (Pins, IDs, Richtungen, Offsets, Grenzen, Fußkontakte),
    STS-Bustreiber (ST3215) mit Echo-Erkennung, Kommandozeile über USB
    (I2C-Scan, Servo-Scan über alle Baudraten, setid, info, watch, calib, goto,
    Fußkontakte, INA219, Taster, Relais)
    - README mit Inbetriebnahme-Ablauf und Sicherung der Werks-Firmware (esptool)
    - CLAUDE.md: Firmware-Ort eingetragen
    Claude-Session: https://claude.ai/code/session_014NDcXS66Bt7NFE9UP7ndp9
2026-11-02 Panzer V1.2: ohne Druck ins Leere
    Keine Seitenrauten an den Kabeldurchlässen (notch_gap 4 mm), keine Dachwaben in der hinteren Kuppel
    (hex_slope). Per Schichtanalyse geprüft (0,2 mm, 50°, Stege < 0,84 mm zählen nicht).
    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
2026-11-02 README: Render des Gesamtmodells (iso) unter der Einleitung
    Bild aus den FreeCAD-Makros (headless Export + three.js), Skripte unter Documentation/Images/render.
    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
2026-11-03 Bein: STL + Cura-Projekte je Teil (rechtes Bein), Generator V1.2
    Coxa, Femur, Tibia (PETG, Gelenkachse senkrecht, Tree Support überall), Zierleisten (PLA).
    Fuß nur als STL (keine TPU-Vorlage). Volumen Femur/Tibia aktualisiert.
    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
2026-11-03 Cura-Generator V1.3: Stützen wieder nur vom Druckbett
    Tree Support erreicht die obere Gabelwange um die untere herum (Marco, Cura). Keine Stützen auf der
    Innenseite der unteren Wange. Bein-Projekte neu erzeugt.
    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
2026-11-04 Wiring: BMS 60 A, Begründung F1 30 A
    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
2026-11-04 Coxa: Stützenabstand oben 0,4 mm (0,2 ließ sich schwer lösen)
    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
2026-11-04 Coxa: zurück auf 0,2 mm Abstand, Stützendach 1,5 mm nach außen erweitert (Hebelkante)
    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
2026-11-05 Bein V9.2: Servo-Tasche 0,3 mm Spiel je Seite, Hüllmaße aus STEP
    servo_W 24.78, servo_L 45.25, fit_srv 0.3 (fit 0.2 bleibt für Schaltertasche). STLs und Cura-Projekte neu.
    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
2026-11-05 Doku: Messung Servo-Tasche (24,86 statt 25,10 mm)
    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
2026-11-05 Doku: Servobreite gemessen (24,6–24,9, Grat an der Trennfuge)
    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
2026-11-05 Bein V9.3: waagerecht gedruckte Servo-Schraubenlöcher als Tropfen
    Coxa (Femur-Servo-Laschen): Bohrung und Senkung mit 45°-Spitze nach oben -> keine Stützen in den Löchern.
    Rechts und gespiegelt geprüft. STL und Cura-Projekt Coxa neu.
    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
2026-11-05 Bein V9.3: Servo-Laschen verlängert (Wand um die Senkung)
    tab_x 30.5 -> 29.9, neue Verlängerung tab_ext 3 mm unterhalb des Servos. Femur-Schwenk gegen Coxa geprüft.
    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
2026-11-06 Femur/Tibia: Stützeinstellungen der Coxa übernommen (Dach, 0,2 mm, Überstand 1,5 mm)
    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
2026-11-06 Bein V9.4: Spitzdach 45° im Hohlprofil von Femur und Tibia
    Statt 16-mm-Brücke (Cura druckte sie längs). Rechts und gespiegelt per Schnitt geprüft.
    Femur 47,99 cm³, Tibia 57,38 cm³. STLs, Cura-Projekte, Stückliste, Doku.
    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
2026-11-06 Baseplates V2.14: Elektronik-Testbrett für den Prüfstand
    Relais, Treiber, Power C, Bein A auf PLA-Platte 220x175 mit den Befestigungen wie im Roboter.
    STL, Cura-Projekt, Stückliste (Hilfsmittel), Wiring-README.
    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
2026-11-07 slarc_manual V2: CAD-URDF-Prüfung, Kontakt als Fußfarbe, Last-/Momenttabelle, Körper seitlich (a/d)
    - Kontaktanzeige: ASCII-freies '●' wurde in PyBullet nicht dargestellt; jetzt Fußfarbe
    grün/orange/rot (Schalter gedrückt / nur seitlich / Luft), entprellt wie V10
    - Momente aller 18 Servos (% Stall, Nm) und Fußlast (N, % Gewicht) als Terminal-Tabelle,
    Label je Fuß im 3D-Fenster, Farbe nur nach Auslastung
    - Fußlast korrigiert: PyBullet meldet Normalkraft / numSubSteps (gemessen 50 % bei 2)
    - IK-Grenztreffer je Bein (LIM), Winkel < 5° vor Grenze rot
    - StallGuard im Handbetrieb aus (--stallguard schaltet ihn ein)
    - Aufnahme erweitert um Fußlast, Gelenkwinkel, Momente, LIM (V1-Da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
2026-11-07 slarc_manual V3: Tripod-Verlagerung, Gruppen-Auswahl, Gelenkmodus
    - u/i: Gewicht auf Tripod A (FR, ML, RR) bzw. B (FL, MR, RL), o: zurück. Die drei tragenden
    Beine werden gleich viel länger (Standard 3 cm), die freien Füße heben genau um diesen Betrag
    ab. Gemessen: freies Tripod 0 N, 32 mm Abstand, max. 56 % Stall.
    "Paar kürzer + Mittelbein länger" drückt das freie Mittelbein auf den Boden (liegt außerhalb
    des Stützdreiecks, trägt weiter ~19 N); über --tri-pair negativ weiter einstellbar.
    - Auswahl 7/8 Tripod A/B, 9/0 linke/rechte Seite, b alle; Pfeile/n/m bewegen alle ausgewählten.
    - e: Gelenkmodus, jeder Servo direkt (Coxa je Seite gespiegelt, -> = vor). Rückkehr in de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
2026-11-07 Brain-Konzept V0.1: bedürfnisgesteuertes High-Level-Brain
    Neues Konzeptdokument Documentation/Brain_Konzept.md und Entscheidungen in
    Stand_und_Entscheidungen.md (Abschnitt 9a).
    Claude-Session: https://claude.ai/code/session_014NDcXQMxN7YQt3FhoboxNQ
2026-11-07 Brain V0.1: Bedürfnismodell, Prompt und Testsuite
    - src_dev/ai/brain/: Bedürfnismodell (energie, neugier, nuetzlichkeit,
    gesellschaft, unbehagen) mit Stufen-Hysterese, Sicherheits-Veto, Menübau,
    Arbiter (1 Hz, Auslöser, Abkühlzeit), Gedächtnis, Prompt mit Few-Shot und
    GBNF, llama.cpp-Anbindung mit Zeitlimit, Mock-Backend
    - 15 Entscheidungs-Szenarien und run_decision_suite.py für den Modellvergleich
    - Unit-Tests (38 grün, Grammatik-Test mit llama.cpp-Parser optional)
    - Brain_Konzept.md V0.2: Bedürfnis Gesellschaft, Abschnitt Umsetzung
    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
2026-11-07 Brain-Suite: Statusmeldungen und --verbose
    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
2026-11-07 Brain V0.2: Code entscheidet, LLM für knappe Fälle und Semantik
    Nach dem ersten Modelltest (Qwen3-4B: 36/45 gegen Code 42/45):
    - Energie ab "hoch" als Regel im Arbiter, Menü dann nur Heimweg/Ruhe
    - Bitte und Fund im Code verknüpft (matches)
    - LLM nur noch für knappe Fälle (close_options)
    - semantic.py: Chat deuten, Objekt einschätzen, Suchorte, Tagebuch,
    je mit Prompt, Few-Shot und GBNF; llm.generate(), optionaler RAM-Cache
    - open_scenarios.py + run_open_suite.py, run_decision_suite --close
    - Doku: Brain_Konzept Abschnitt 15, Stand_und_Entscheidungen 9a
    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
2026-11-07 slarc_manual V4: Rückenlage-Start, Startpose in der Aufnahme, Robustheitstest
    - --start-back: Start auf dem Rücken (Dach liegt auf, Beine neutral nach oben)
    - --start-yaw/-tilt/-dx/-dy: Startpose variieren (Teleop und Replay)
    - Aufnahme beginnt mit einer Meta-Zeile: Gelände, Basispose, Ist- und Soll-Gelenkwinkel.
    Replay baut dasselbe Gelände und startet exakt dort (ältere Dateien wie bisher).
    - Replay interpoliert die Soll-Winkel zwischen den 30-Hz-Samples; vorher Treppensprünge,
    Momentspitze 78 % statt 63 % der Aufnahme. Jetzt: Endpose ±0,3 mm, Spitze identisch.
    - Replay endet mit einer RESULT-Zeile (Endpose, up_z, Spitze, LIM, Kontakte)
    - Spitzenwerte zählen das Absetzen nach d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
2026-11-07 Brain V0.5: echte Klassen, simulierte Wohnung, BT-Schicht
    - perception_classes.py: 41 Klassen der Detektion V5.0 als einzige Quelle,
    Synonyme, Raum-Anker; nicht erkennbare Dinge werden ehrlich abgelehnt
    - sim/world.py: abstrakte Wohnung (Räume, Wege, Akku, Dinge, Personen, Chat)
    - sim/bt.py: fester py_trees-Teilbaum je Verhalten
    - sim/day.py: simulierter Tag mit Arbiter, BT und optional LLM
    - Arbiter: keine Unterbrechung ohne Grund, kein Neustart desselben Ziels,
    alle Entscheidungen im Tagebuch, last_seen
    - neue Verhalten wander und doze; Umsehen wird langweilig; Meldung je Ort einmal
    - Szenarien/Tests auf echte Klassen; Doku Abschnitt 16, offene Punkte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
2026-11-07 Brain V0.6: Gesellschaft suchen, Dösen mit Sättigung, Vision-Test
    - seek_company: dorthin, wo zuletzt Menschen waren (sonst Wohnzimmer/Küche),
    leere Räume 15 min nicht erneut; Personen in last_seen
    - Liegen mit 8 statt 15 W in der Simulation
    - Dösen sättigt (doze_log), lockt bei Energiebedarf
    - vision/compare_vlm.py: Vision-Sprachmodelle gegeneinander auf COCO und
    eigenen Fotos (llama-server), Vorlage questions_template.json
    - Tests: 63 grün; Doku Abschnitt 13 und 16
    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
2026-11-08 Brain: VLM-Geschwindigkeit auf dem Pi messen
    - vision/bench_pi.py: Bildfragen bei mehreren Bildgrößen (ja/nein und Liste),
    Brain-Aufgaben ohne Bild nach Wechsel und wiederholt, Temperatur,
    Drosselung und Speicher; Bericht in brain/ergebnisse
    - vision/export_subset.py: echte Innenraumbilder + Mini-Annotation für den Pi
    - vision/README.md: llama.cpp auf dem Pi bauen, Ablauf, Lesehilfe
    - Tests gegen nachgebauten Server
    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
2026-11-08 Baseplates V2.15: Relais-Lochbild gemessen, Power-Platine C Löcher an der langen Kante
    Relais 128,63 x 46,57 (statt 132,2 x 50,8), gilt für untere Platte, Option oben, Testbrett.
    Power C: Löcher 46 mm an der 50-mm-Kante (Power-Brücke und Testbrett). STLs, Cura-Projekte, Stückliste, Doku.
    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
2026-11-08 Testbrett-Adapter für das gedruckte Brett V2.14 (Relais, Power C)
    Relais: auf die alten M3-Einsätze, Modul 10 mm versetzt, M3-Muttern im Sechskant von unten.
    Power C: auf die alten M2-Bunde, Platine 12 mm versetzt, M2-Muttern seitlich. Keine neuen Einsätze.
    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
2026-11-08 Vision-README: llama-server aus eigenem llama.cpp-Klon auf dem Pi
    Vorhandene Quellen gehören root (setup_venvs.sh mit sudo) und sind vom März 2026.
    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
2026-11-08 brain/vision: Messreihe auf dem Pi (run_pi_matrix.sh), bench_pi V0.3 mit Label und Übersicht
    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
2026-11-08 Doku: Pi-Messung Qwen3.5 Text und Bild, Bildgrößen auf dem PC (08.11.2026)
    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
2026-11-08 Doku: Qualitätsvergleich Q4_K_M/Q4_0/2B und Bild-F1 bei 320 px (08.11.2026)
    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
2026-11-08 Brain: ehrliche Bestätigungen per Vorlage, Slot je Aufgabe (ServerBrain), Slot-Messung auf dem Pi
    - semantic V0.6: Aufträge bestätigt der Code (Vorlagen mit Artikeln), LLM-Antwort nur in llm_reply;
    item_problem auch für check (Räume ausgenommen) und mit bekannten Personennamen; claims_result()
    - run_open_suite/compare_models: zählen Bestätigungen, die ein Ergebnis behaupten
    - llm V0.5: ServerBrain (llama-server, id_slot je Aufgabe); compare_models --server/--slots
    - bench_pi V0.4: --slots, echte Grammatiken; run_pi_matrix V0.3: Läufe slots-1/slots-4
    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
2026-11-08 Doku: Objektiv Richer-R 2,8 mm statt ZH3019-14, Bildwinkel/Länge offen
    Claude-Session: https://claude.ai/code/session_014NDcXS7TnomG2qzhC2iVh4
2026-11-08 brain/semantic: „Gehe ins Badezimmer“ ehrlich ablehnen statt „Ich komme zu dir“
    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
2026-11-08 Doku: Slot je Aufgabe auf dem Pi gemessen; run_pi_matrix übergibt -np/-c nur einmal
    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
2026-11-08 brain/vision: Server-Speicher getrennt (RssAnon/RssFile), Speicherläufe mem-1…5 in run_pi_matrix
    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
2026-11-08 Brain: KV-Cache q8_0 festgelegt (PC-Vergleich), compare_models --server NAME=URL, Ortswort „…bereich“
    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
2026-11-08 brain/vision: „Was ist das?“ – Ausschnitt einer Box ans VLM (identify.py) und COCO-Test (crops_vlm.py)
    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
2026-11-08 brain/vision: roter Rahmen um die Box und Wortliste „haushalt“ für „Was ist das?“
    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
2026-11-08 Doku: Ergebnis „Was ist das?“ (Ausschnitt ans VLM, roter Rahmen)
    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
2026-11-08 slarc_manual V4.1: w/s und t/g korrigiert
    Gemessen (240 Frames gehalten, ebener Boden): w fuhr den Körper 271 mm zurück,
    s 280 mm vor; t senkte die Nase um 38°, g hob sie. Beide Paare getauscht.
    Der Kommentar "neg = nose high" war falsch; V10 nutzt Pitch > 0 = Nase hoch.
    a/d (±340 mm links/rechts), r/f (hoch/runter) und z/h (rechts/links runter)
    stimmen; z/h-Richtung in der Tastenliste ergänzt.
    Aufnahmen bleiben gültig: gespeichert werden die kommandierten Werte.
    Claude-Session: https://claude.ai/code/session_014NDcXNN6VqcZGmTCK2wyfP
2026-11-10 PETG 230 °C (erste Schicht 235, Ende 225) aus Temperaturturm, alle PETG-Projekte neu
    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
2026-11-10 Baseplates (4 Teile) und Kamerahalter als STL + Cura-Projekt aus dem Generator
    Baseplate oben vorn neu aus V2.15 (alte STL war vom 26.10., ohne Fenster unter Pi/Treiber).
    Handgespeicherte Projekte durch generierte ersetzt (PETG 230 °C). Untere Platte hinten mit Stützen nur ab 20 mm².
    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
2026-11-11 Cura-Generator V1.5: TPU-Vorlage und -Profil, Fuß in Druckausrichtung
    Fuß-STL jetzt mit Öffnung nach unten (vorher im Tibia-Frame seitlich). TPU-Profil setzt Rückzug,
    Lüfter, Bett und Temperaturen selbst, weil die Vorlage noch PETG als Material hat.
    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
2026-11-11 Brain: Blackboard-Formate, Karte/A*/Grenzen/Tracking (nav) und 2D-Simulation mit Viewer (sim2d)
    - blackboard.py (BB 0.1): Pose, Belegungskarte, Detektionen, Objekt-Tracks, Personen, Grenzen,
    Bereiche, Navigation, Roboterzustand; to_observation() fürs Brain, to_dict() für JSON
    - nav/: gridmap (Log-Odds, ROS-Konvention), astar (nach Pathfinder_V4, ohne matplotlib/scipy),
    frontier, tracker (Wiedererkennen Stufe 1), layers
    - sim2d/: Grundriss, Kamera mit Verdeckung, BT-Blätter mit A*, Tagesschleife, Aufzeichnung, HTML-Viewer
    - arbiter V0.7: Meldung unter dem Ort des Objekts merken (sonst Dauermeldung bei 4 m Sicht)
    - Tests: test_nav.py, test_sim2d.py (88 grün); Doku Brain_Konzept Abschni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
2026-11-11 Brain: „Was ist das?“ für unbekannte Dinge (nie antasten, zwei Blicke, Rückfrage, suchbar)
    - behaviors V0.7: identify statt inspect für "unbekannt", Neugier-Bonus; arbiter V0.8 gewöhnt auch bei Fehlschlag
    - blackboard BB 0.2: Detection.quelle, TrackedObject.ident/answers/name_source/label; ObjectSeen.ident
    - semantic V0.7: naming() für Antworten, item_problem(known=…); identify.py: "nichts" in der Wortliste
    - sim2d: unbekannte Dinge mit wahrem Namen, nachgebildetes VLM (75 %), BT identify mit zweitem Blick,
    Rückfrage und Antwort im Chat, Suche beginnt am bekannten Ort; „Sehe ich X?“ zählt 20 s
    - Tests (92 grün), Doku Brain_Konzept 18.1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
2026-11-11 Brain: grammatische Vorlagen (Artikel, Räume) in sprache.py
    „Im Raum schlafzimmer liegt etwas, ich glaube socke.“ -> „Im Schlafzimmer liegt etwas. Ich glaube,
    das ist eine Socke. Was ist das?“ Meldungen, Rückfragen, Bestätigungen und Ziel-Labels nutzen
    sprache.noun/in_room/cap; Genus auch für Haushaltsdinge und Räume.
    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
2026-11-12 Bein V9.6: Spitzdach über der Mikroschalter-Tasche (ohne Stütze druckbar)
    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
2026-11-12 Cura V1.6: Lüfter 100 % für die Haut über dem Stützdach (alle Profile)
    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
2026-11-13 TPU-Fuß: Passungsringe slide_c 0.3–1.0 als Testdruck
    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
2026-11-13 Cura V1.7: TPU-Beschleunigung und Ruck für den Kobra Plus (500/1000 mm/s², 5/8 mm/s)
    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
2026-11-13 Cura V1.7: PETG-Fahrt 1000 mm/s², Ruck 8 mm/s (Vibration beim Stützendruck)
    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
2026-11-13 Cura V1.8: TPU-Fahrt 80 mm/s
    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
2026-11-13 README: Stand 13.11.2026 (Brain, Firmware V0.1, CAD V9.7, Status)
    - Brain-Abschnitt ersetzt den alten Mission-Planner: Bedürfnisse, Code-Arbiter,
    LLM nur für Semantik, Qwen3.5-4B + mmproj auf dem Pi (Messwerte), Blackboard, sim2d
    - Beingeometrie 150/175 mit Knick, Masse 3,79 kg laut CAD
    - UNKNOWN-Klasse ehrlich beschrieben (übrige COCO-Klassen, keine gemessene Objekthaftigkeit);
    fehlende Klassen Tür/Fenster/Dose
    - ESP32: Firmware V0.1 (Inbetriebnahme-Werkzeug) statt "noch nicht im Repo";
    Ein/Aus-Ablauf mit Taster, Deep Sleep, BC547 statt Dioden-ODER
    - Sim: Klettern bleibt an der Stufenkante hängen, Aufrichten manuell gelungen,
    Kletterschema aus der Teleop, slarc_manual-Beschreib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
2026-11-13 setup_venvs.sh V2.0: llama-server und Qwen3.5 fürs Brain, Lauf als User
    - llama.cpp/llama-server ohne BLAS nach ~/llama.cpp/build-noblas, fest auf a691b23
    (Stand der Pi-Messung 08.11.2026), --update-llama / --llama-ref
    - Modelle: Qwen3.5-4B Q4_K_M + mmproj Q8_0; Qwen3-4B nur mit --legacy-llm;
    Download über .part mit Mindestgröße und Ersatzquelle (404 hinterließ bisher eine
    leere Datei, die als vorhanden galt)
    - Läuft als normaler User; mit sudo gestartet Neustart als SUDO_USER, root-eigene
    venvs/Modelle/Build-Ordner werden einmalig per chown zurückgegeben
    - llama-cpp-python nur bauen, wenn es fehlt (bisher bei jedem Lauf), ohne BLAS
    - venv ai: pillow, pytest; ollama entfällt;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
2026-11-13 Bein V9.8: Gleitspiel TPU-Fuß 0.6 mm (Passungsringe)
    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
2026-11-13 Bein V9.9: Fußlippe 0.5 mm (Luft am Nutgrund), Gleitspiel 0.7; Passungsringe V1.1
    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
